tomstorey/discrete-nor-logic-clock/3-bit-ripple-counter/3 bit ripple counter.png

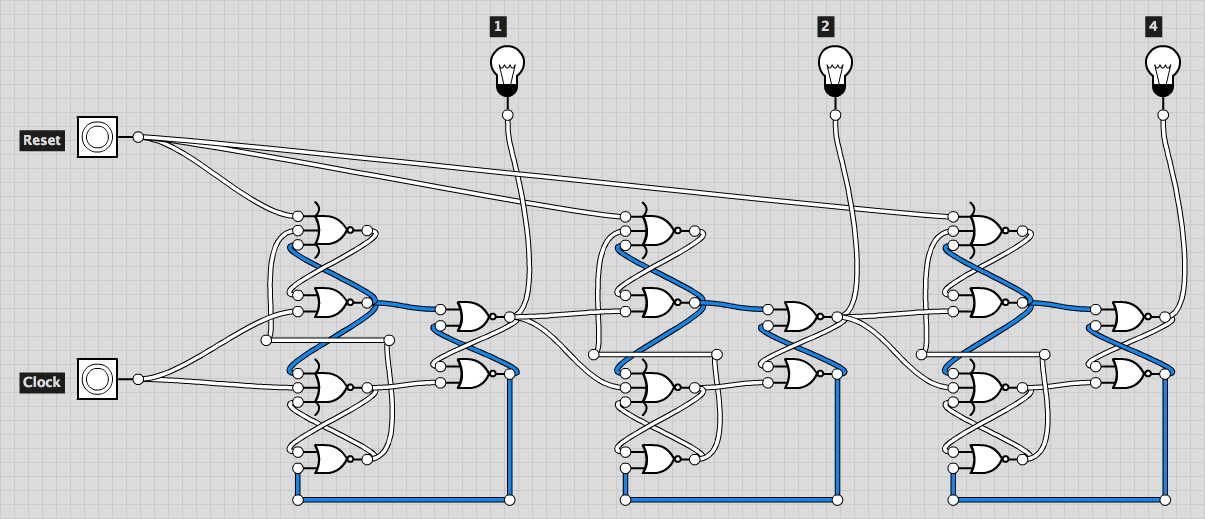
3-bit-ripple-counter/3 bit ripple counter.png
