tomstorey/discrete-nor-logic-clock/7-seg-decoders/2 bit BCD NOR 7 seg decoder Rev B.png

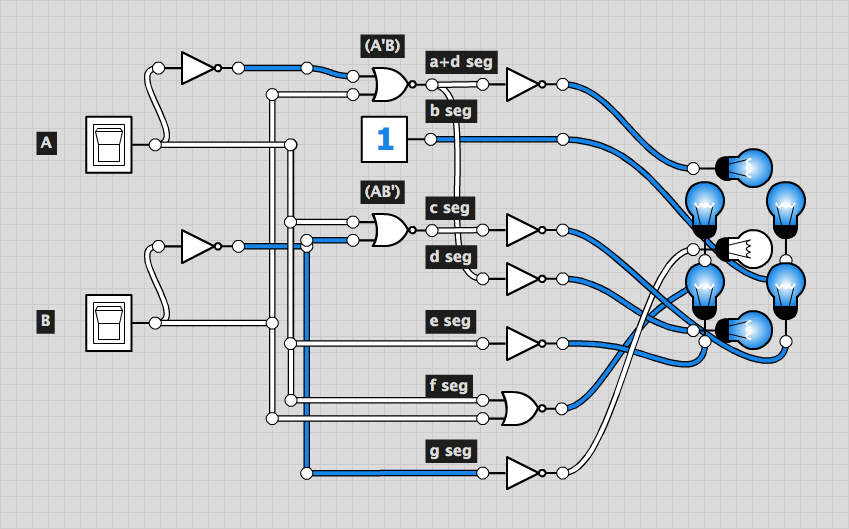
7-seg-decoders/2 bit BCD NOR 7 seg decoder Rev B.png
