tomstorey/discrete-nor-logic-clock/schematics/display-board.pdf

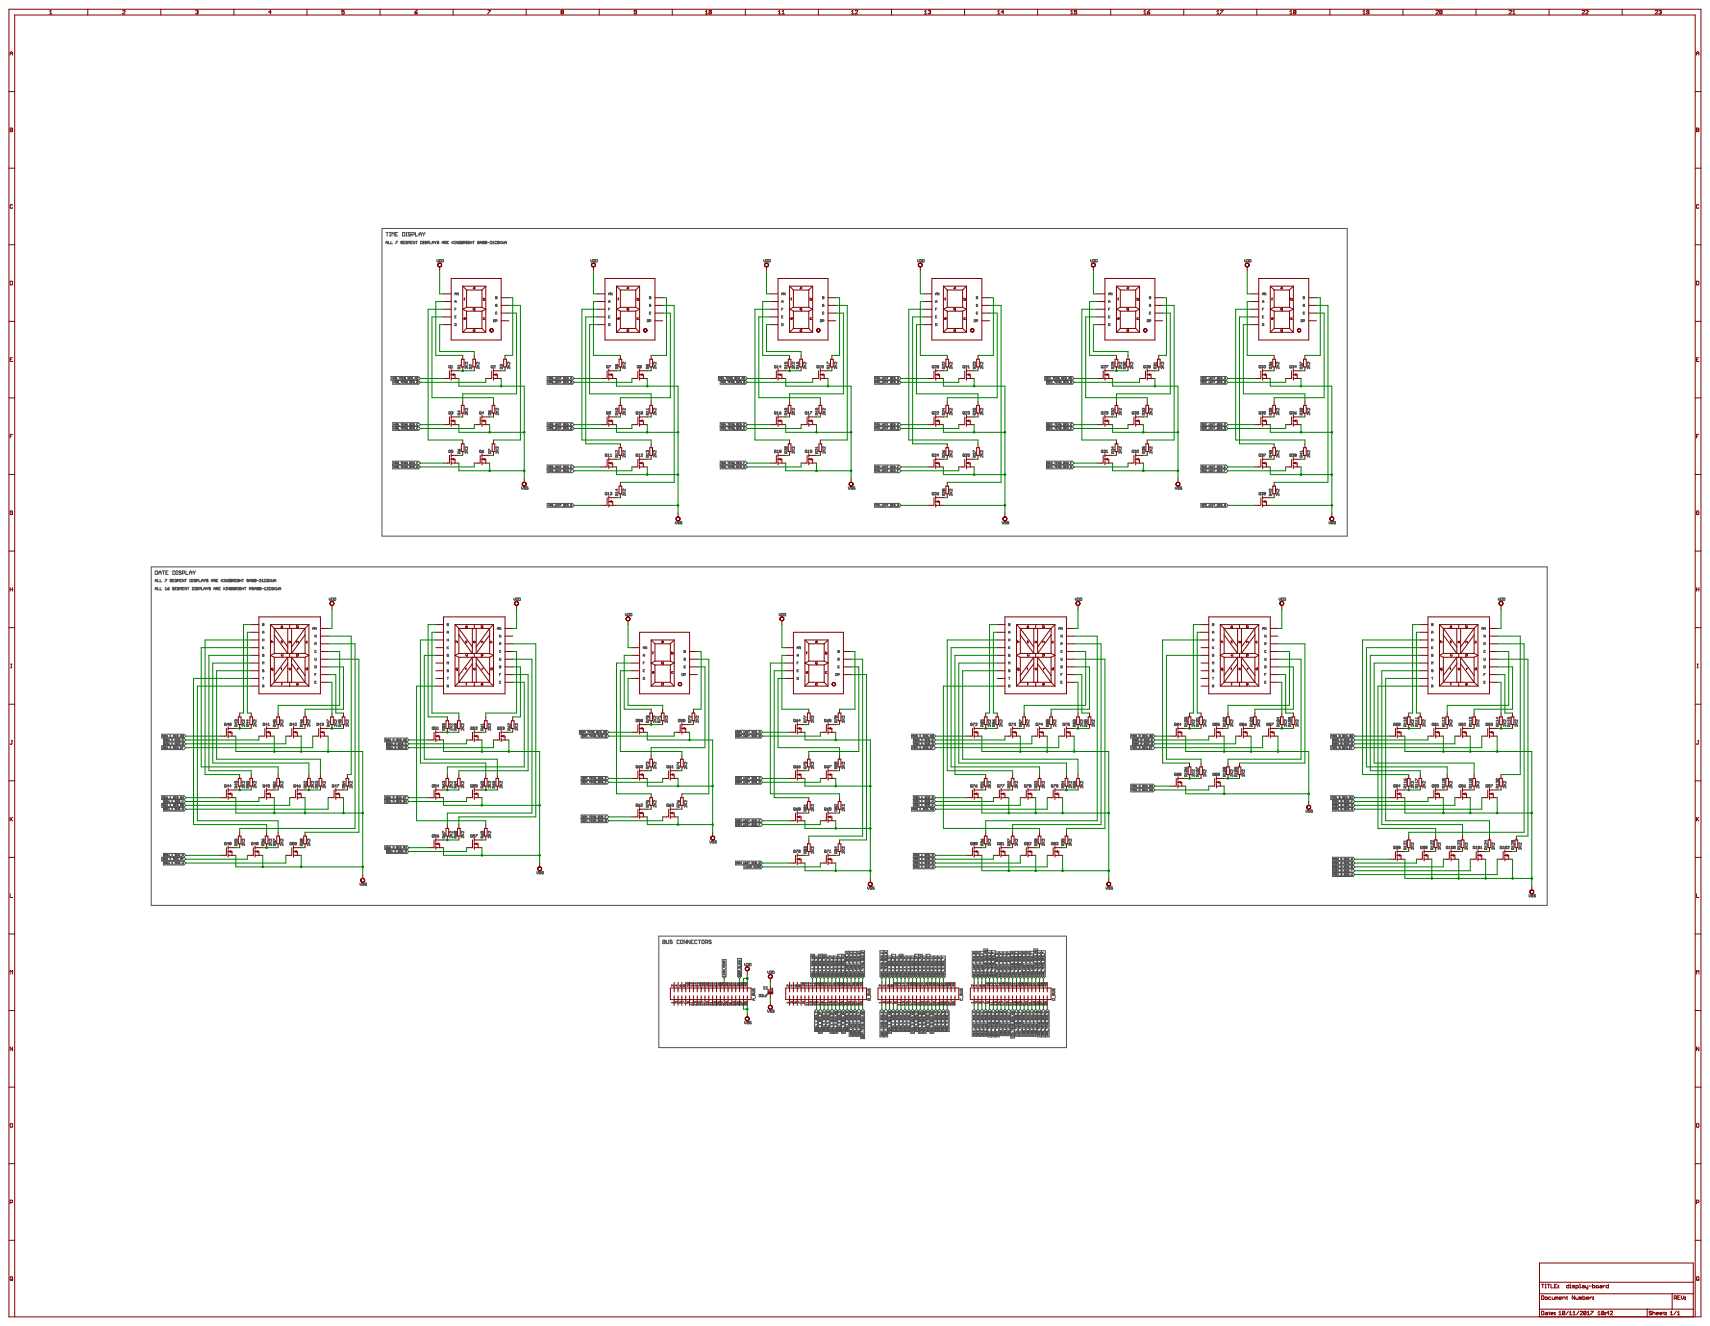
[picture p4: page 1]
