tomstorey/discrete-nor-logic-clock/schematics/calendar-module.pdf

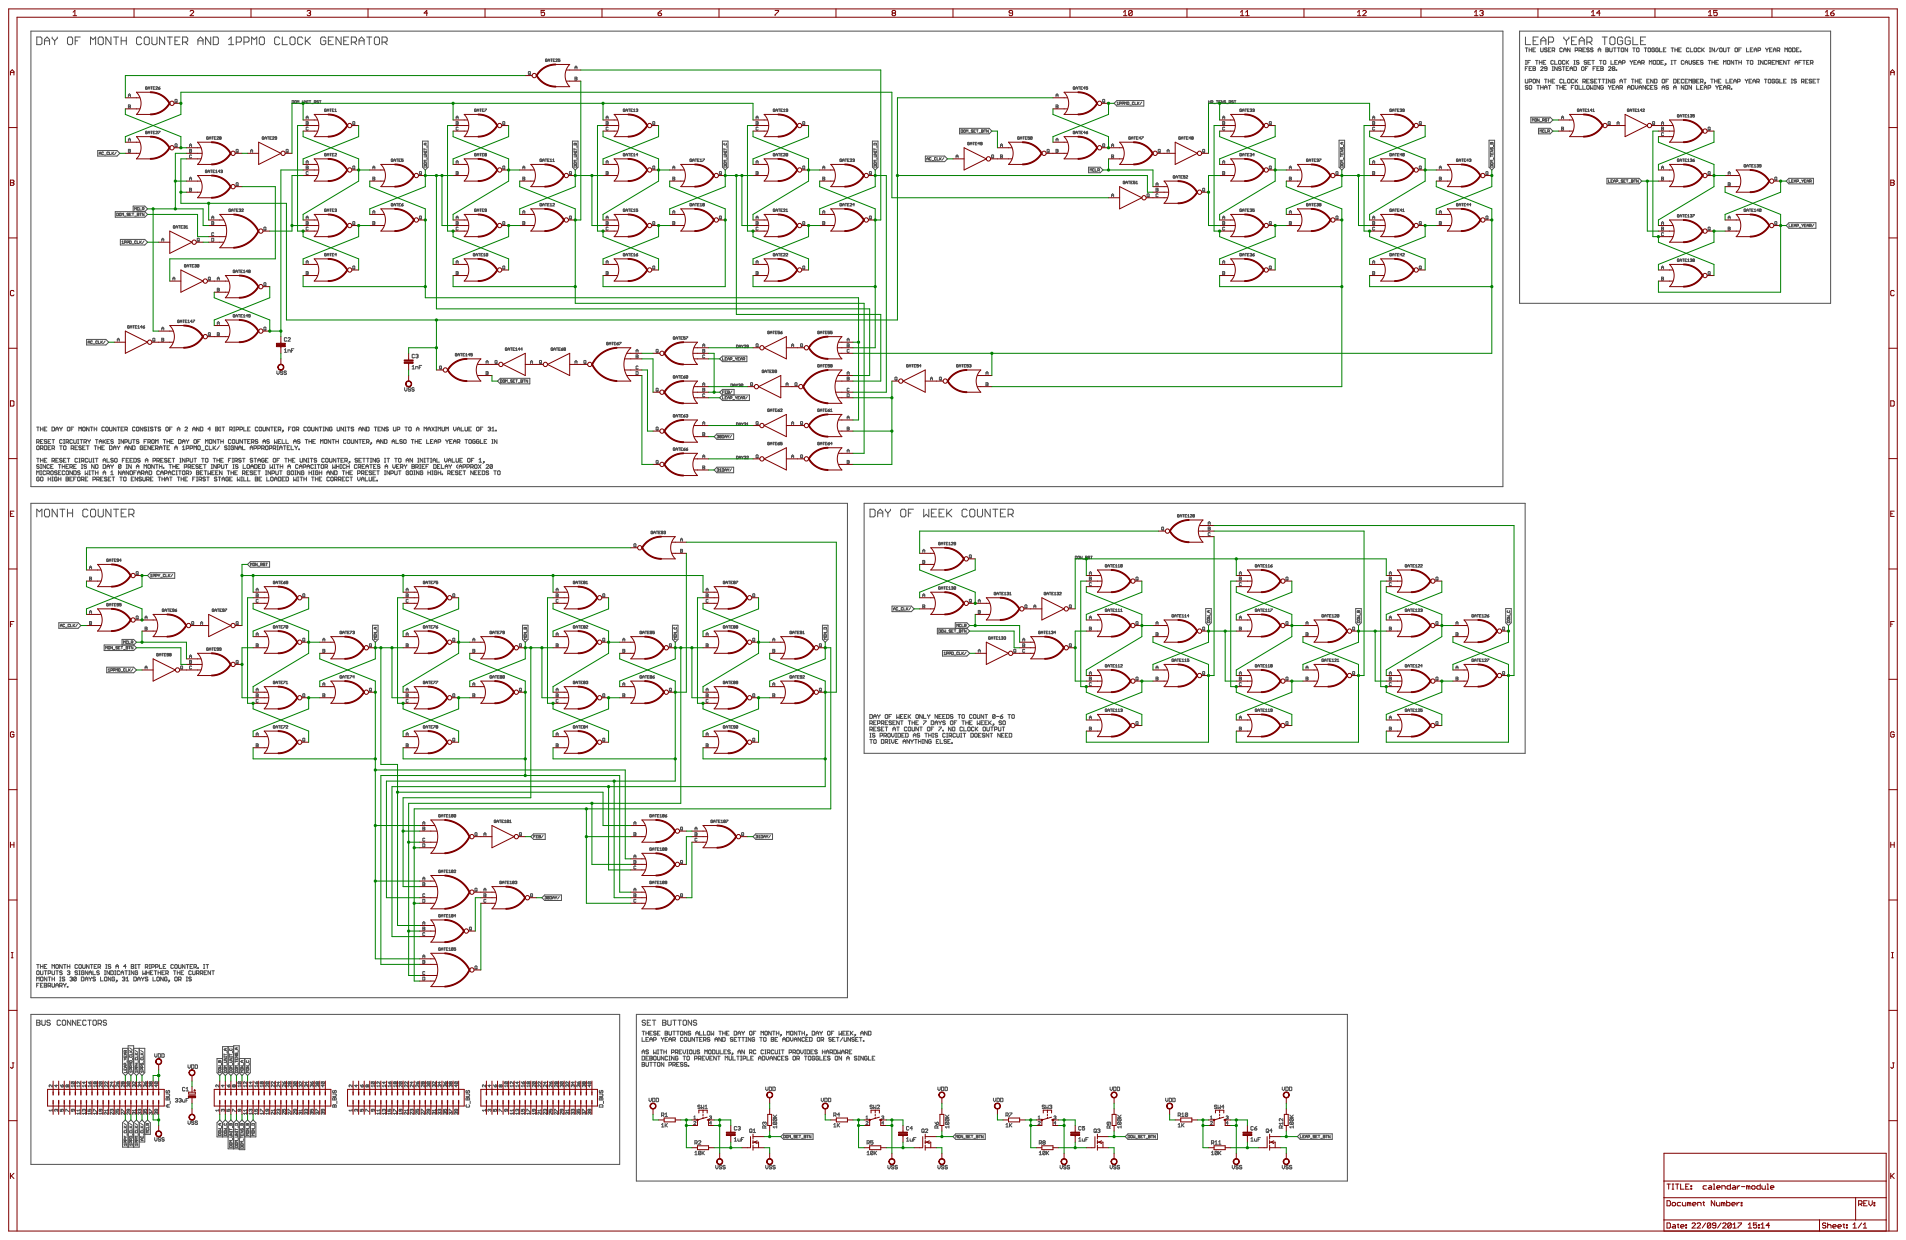
[picture p5: page 1]
