tomstorey/discrete-nor-logic-clock/schematics/calendar-decoders.pdf

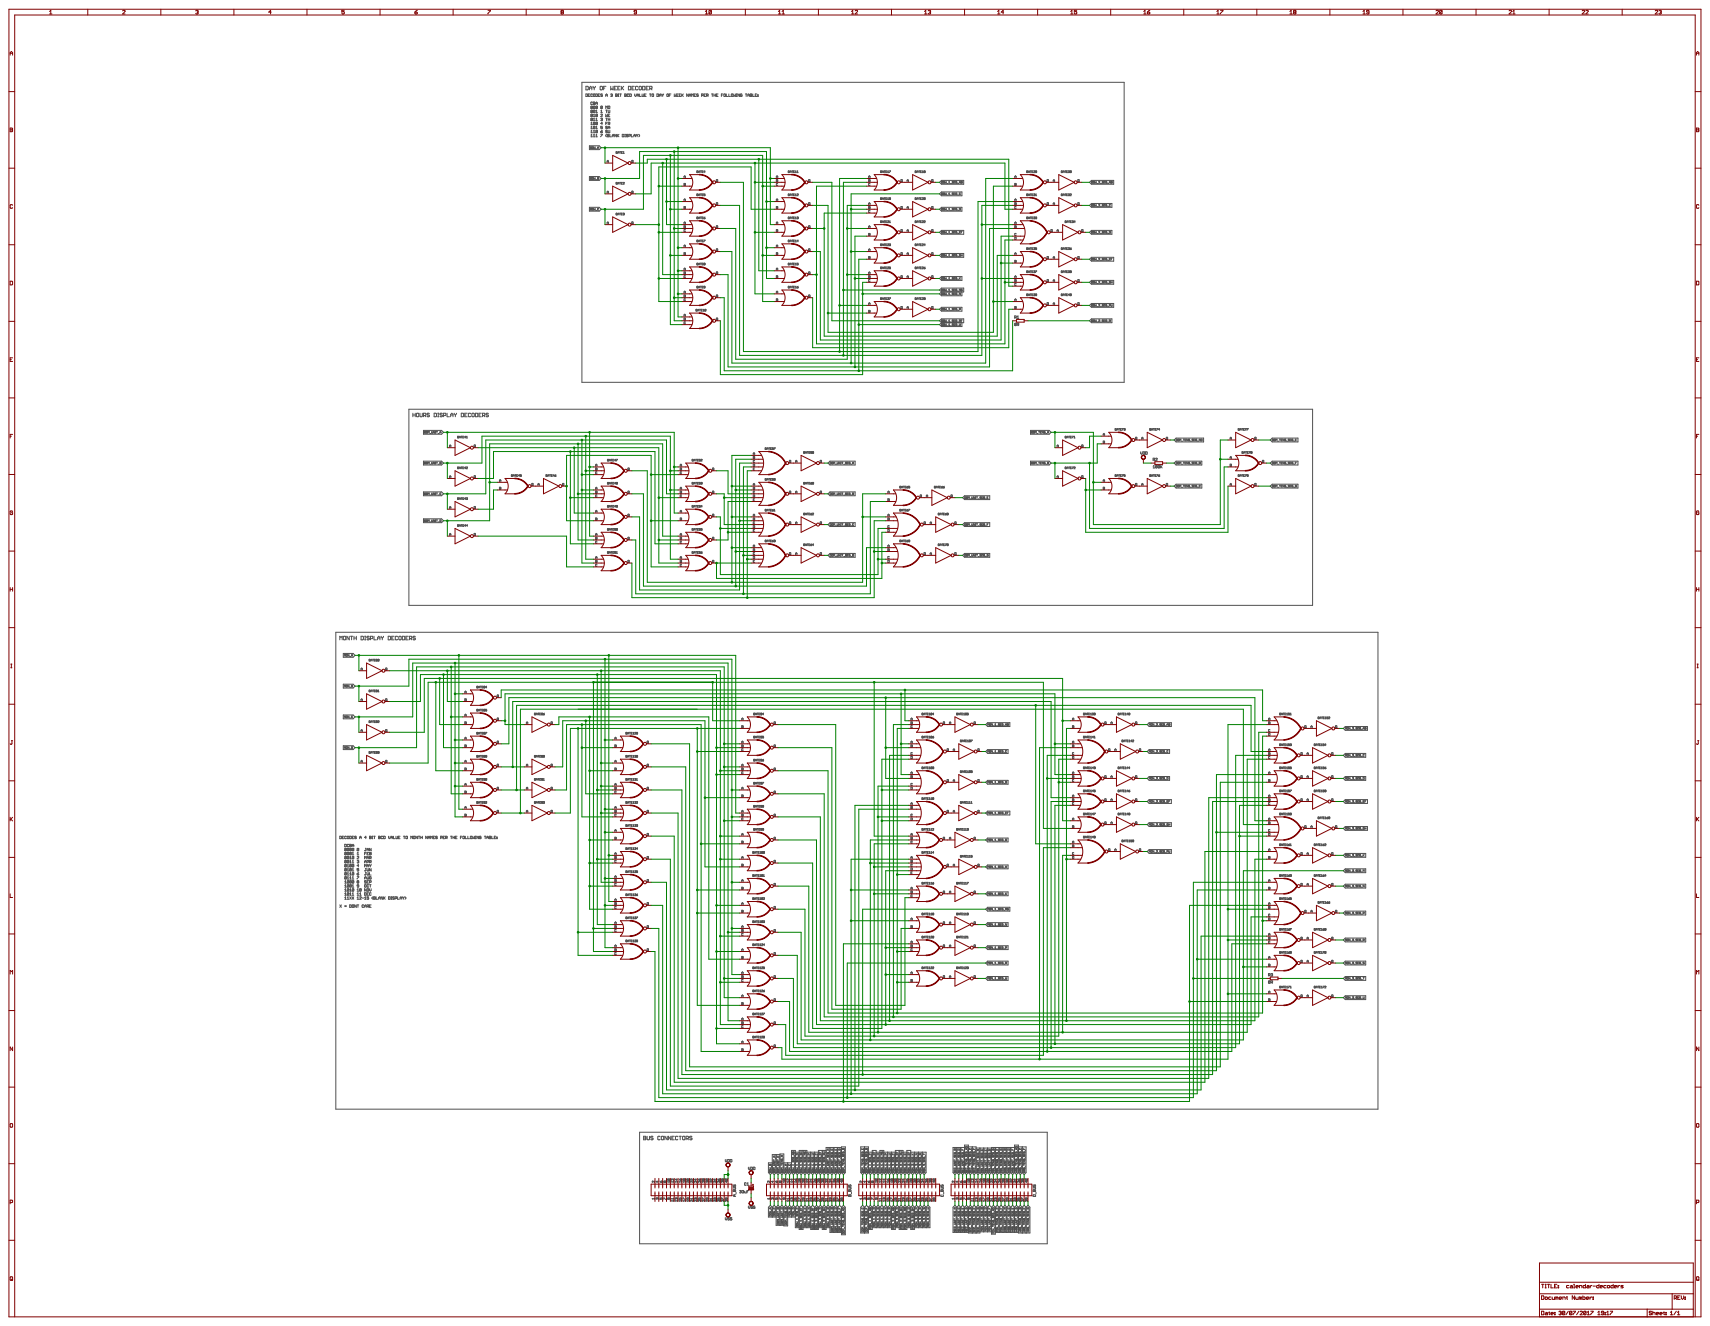
[picture p6: page 1]
