tomstorey/discrete-nor-logic-clock/schematics/analogue-board.pdf

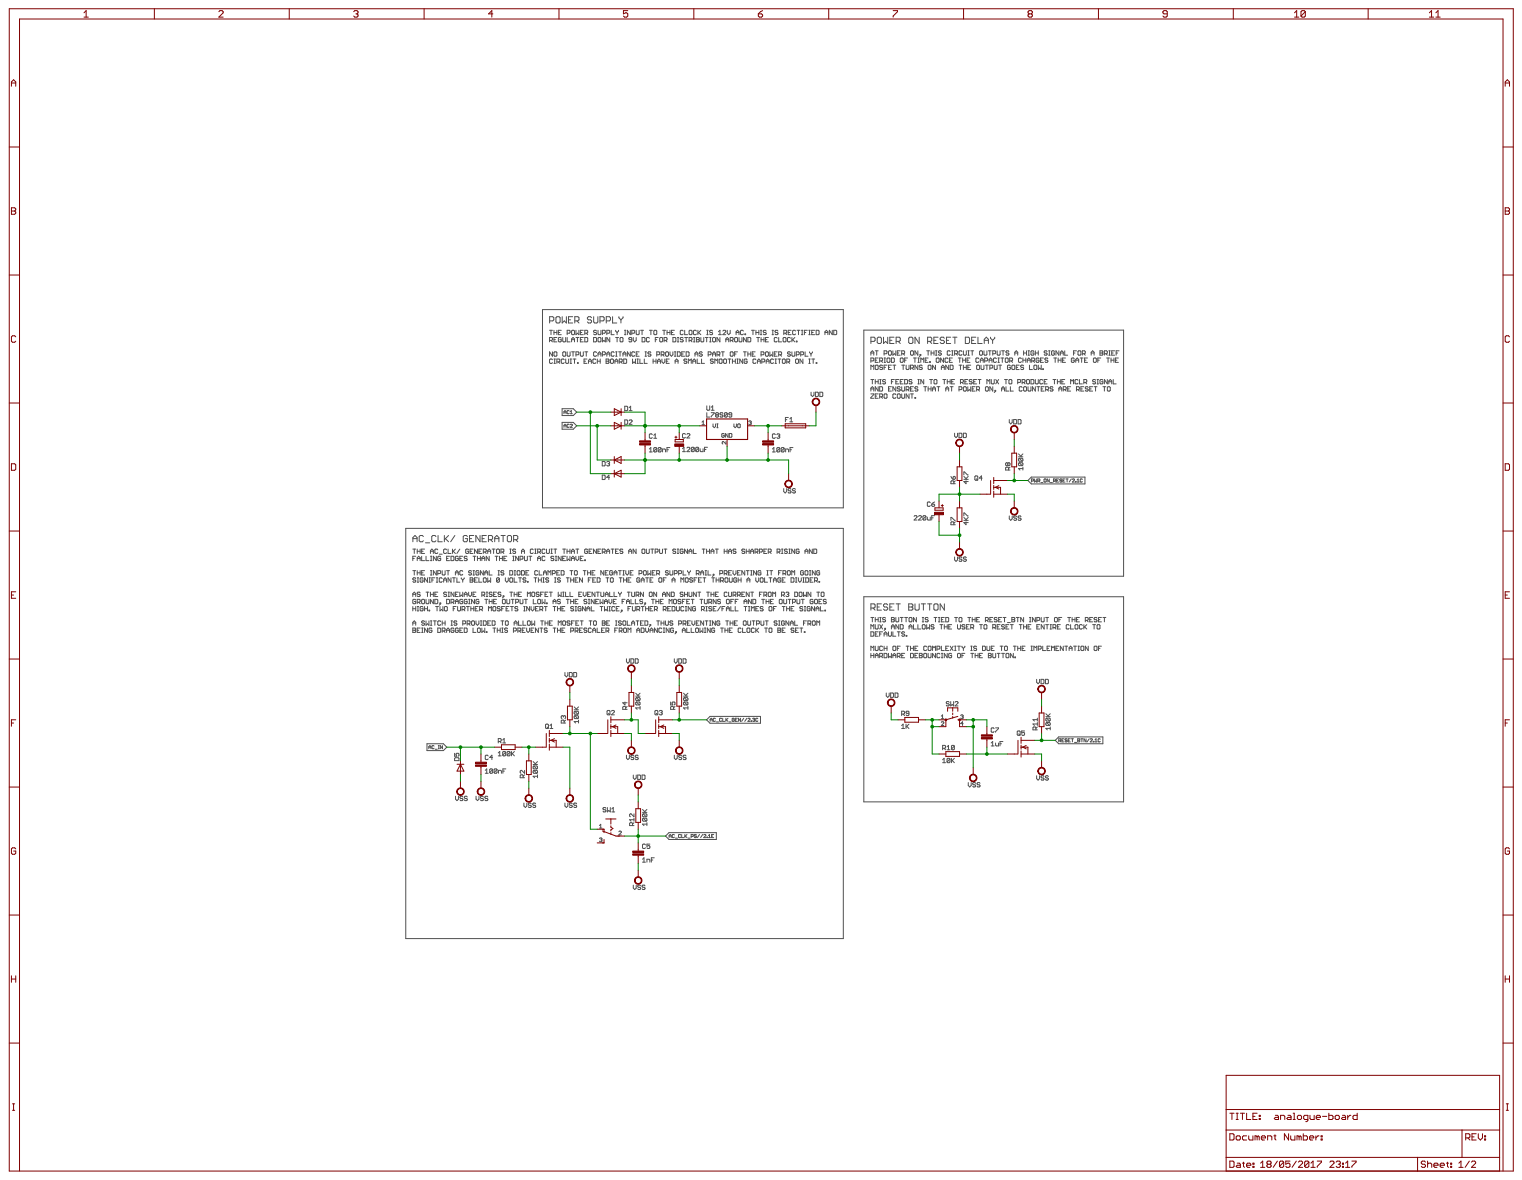
[picture p7: page 1]

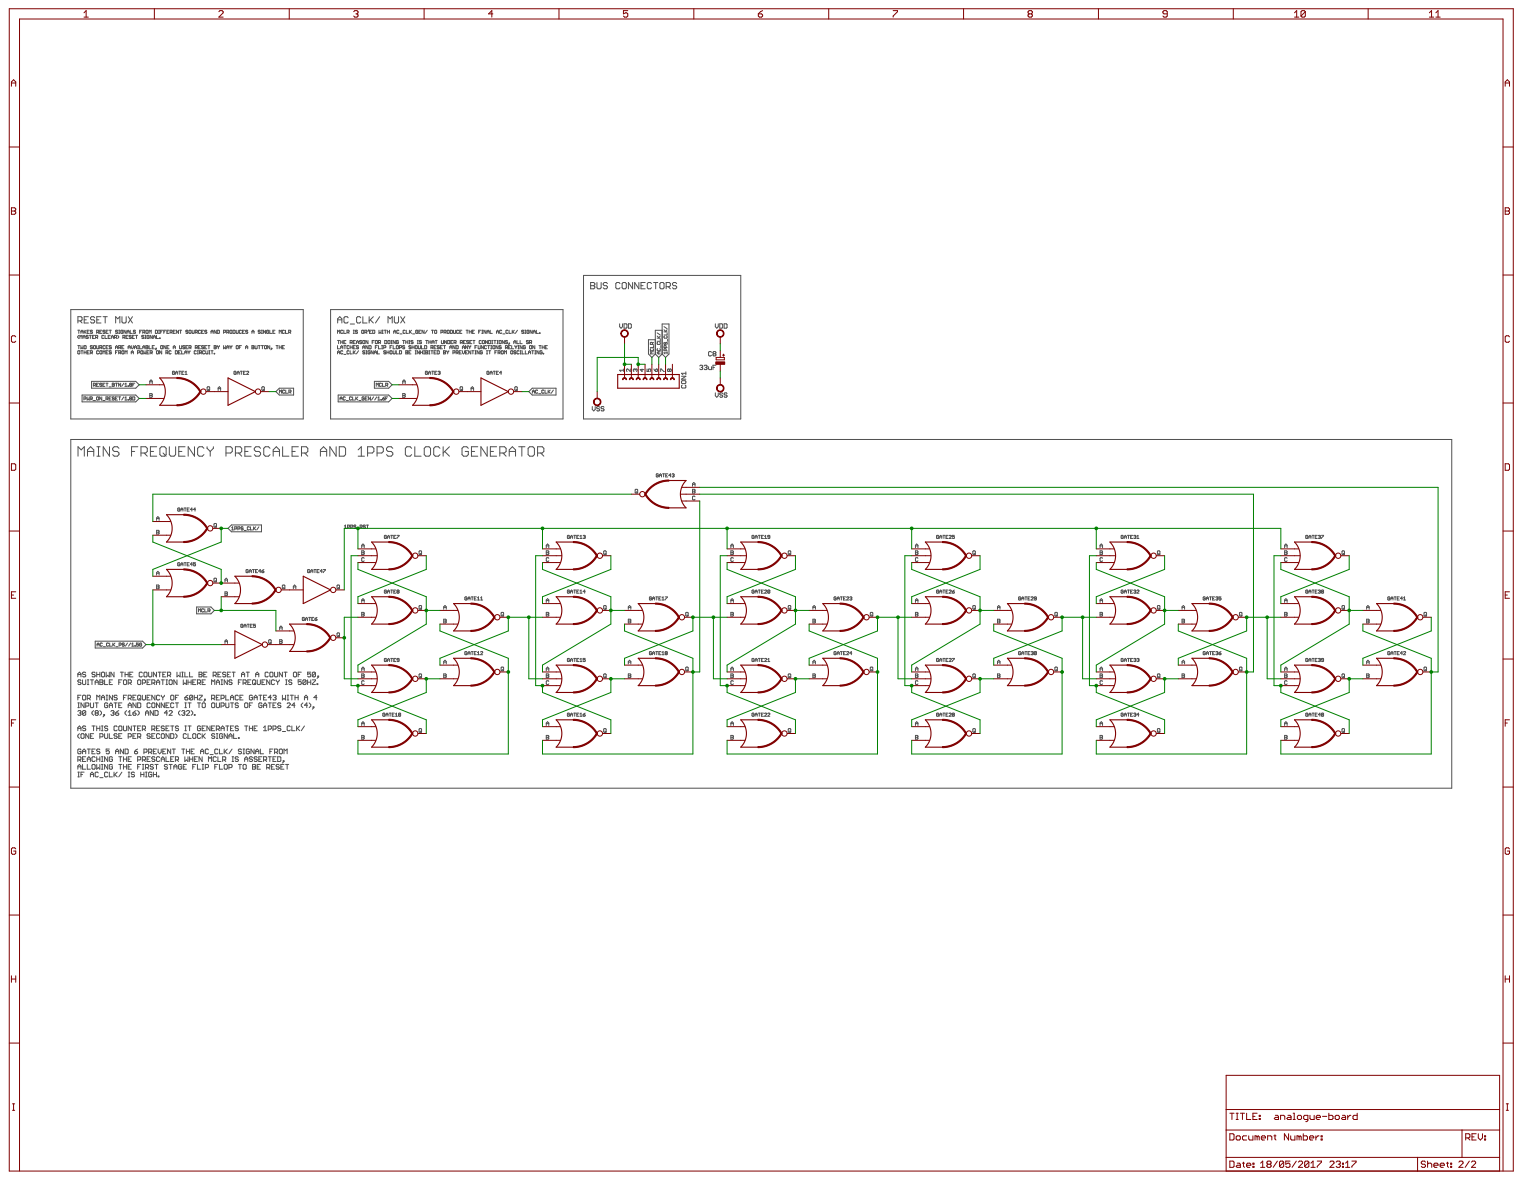
[picture p8: page 2]
