tomstorey/discrete-nor-logic-clock/schematics/time-decoders.pdf

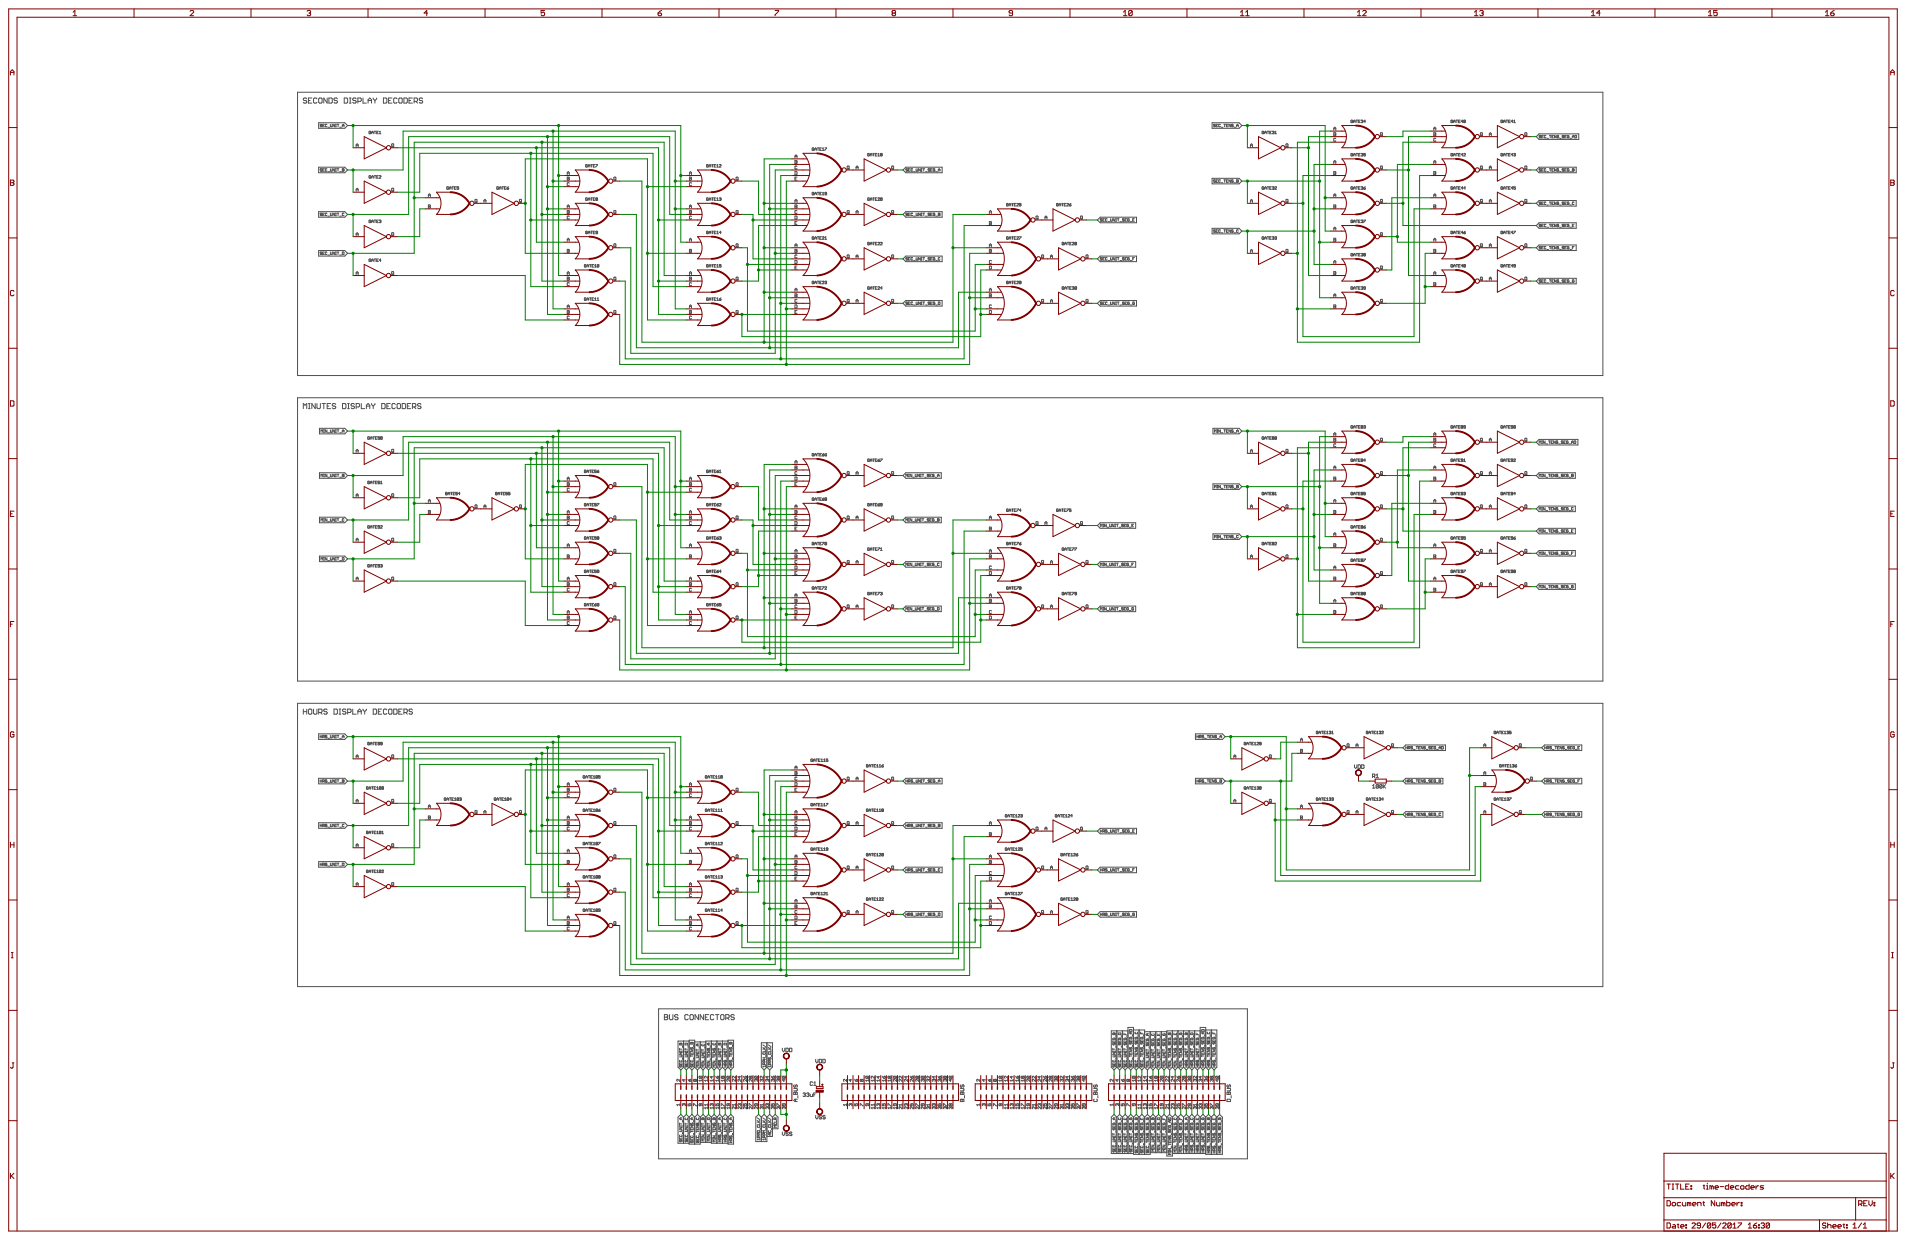
[picture p9: page 1]
