tomstorey/discrete-nor-logic-clock/schematics/time-module.pdf

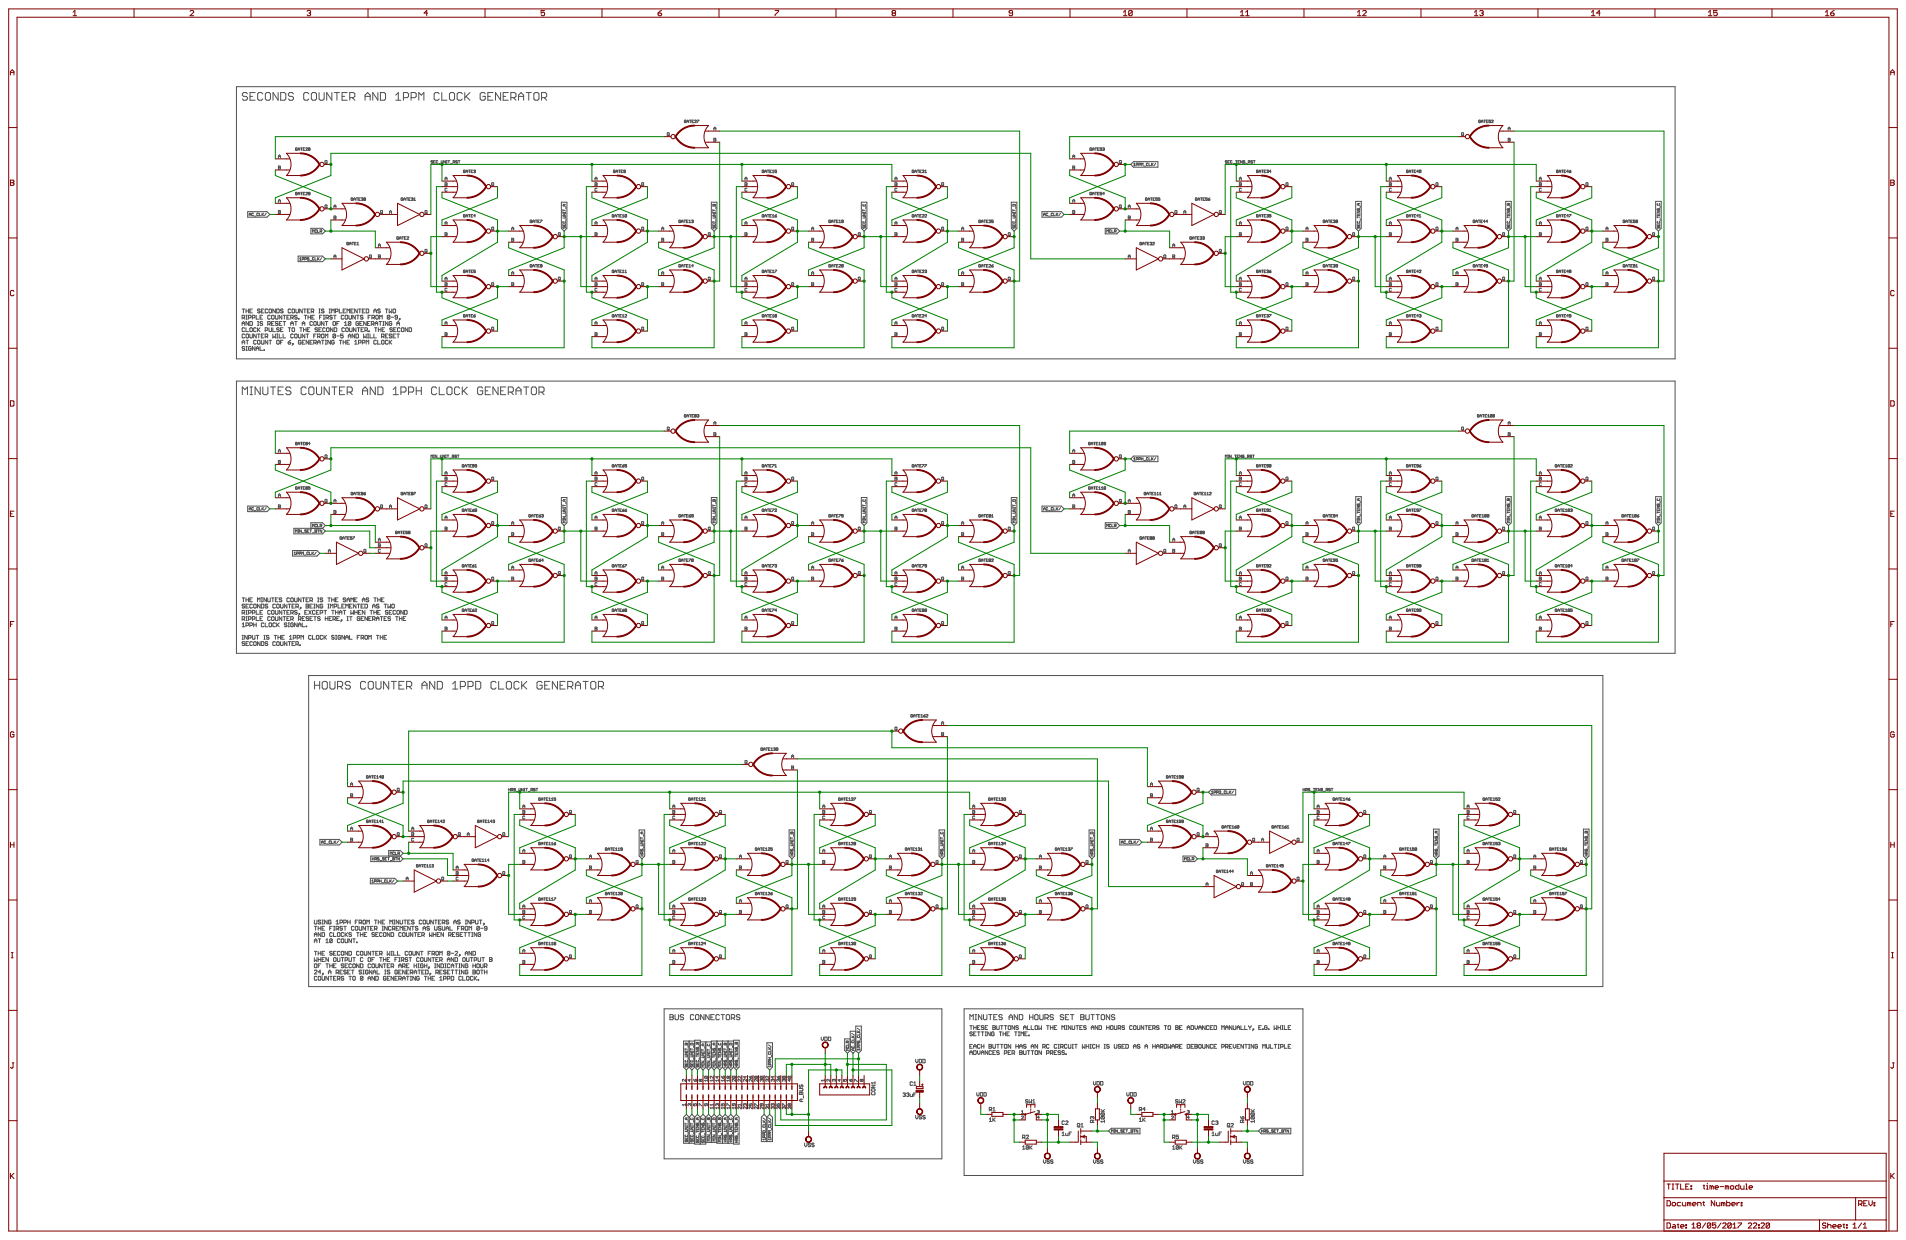
[picture p10: page 1]
