tomstorey/discrete-nor-logic-clock/schematics/analogue-board.sch

## EAGLE design schematics/analogue-board.sch (2017-05-24)

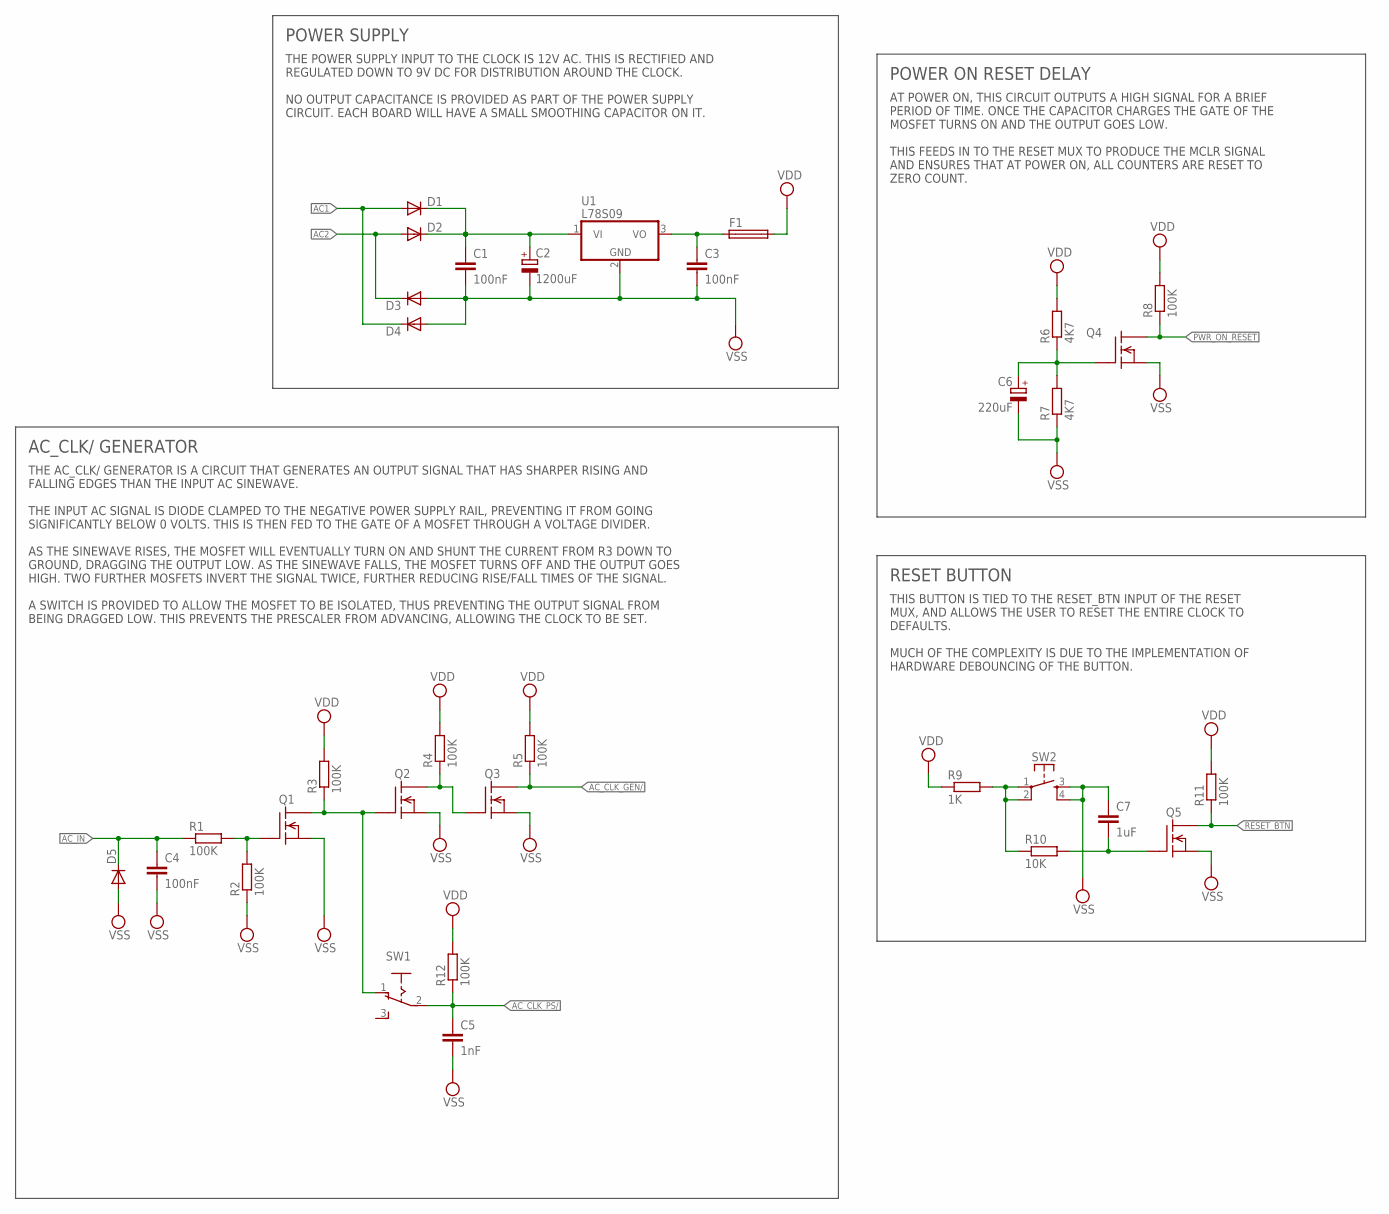
[picture p11: schematic analogue-board.sch, sheet 1]

Parts:
C1, C3, C4: 100nF; C050-024X044
C2: 1200uF; E7,5-16
C5: 1nF; C050-025X075
C6: 220uF; E2,5-6
C7: 1uF; C050-025X075
D1, D2, D3, D4, D5: 1N4004; DO41-10
F1: TE5
Q1, Q2, Q3, Q4, Q5: 2N7000; TO-92
R1, R2, R3, R4, R5, R8, R11, R12: 100K; 0207/2V
R6, R7: 4K7; 0207/2V
R9: 1K; 0207/2V
R10: 10K; 0207/2V
SW1: 255SB
SW2: SPST-TACSWITCH; TE-SMD-TACSWITCH
U1: L78S09; TO220H

Connections:
AC1: D1.A, D4.C
AC2: D2.A, D3.C
AC_CLK_GEN/: Q3.3 (D), R5.1
AC_CLK_PS/: C5.1, R12.1, SW1.2
AC_IN: C4.1, D5.C, R1.1
unnamed: Q1.3 (D), Q2.2 (G), R3.1, SW1.1 (O)
unnamed: C6.+, Q4.2 (G), R6.1, R7.2
unnamed: C3.1, F1.1, U1.3 (VO)
unnamed: C1.1, C2.+, D1.C, D2.C, U1.1 (VI)
unnamed: R9.2, R10.1, SW2.1, SW2.2
unnamed: Q2.3 (D), Q3.2 (G), R4.1
unnamed: Q1.2 (G), R1.2, R2.2
unnamed: C7.2, Q5.2 (G), R10.2
PWR_ON_RESET: Q4.3 (D), R8.1
RESET_BTN: Q5.3 (D), R11.1
VDD: F1.2, R3.2, R4.2, R5.2, R6.2, R8.2, R9.1, R11.2, R12.2
VSS: C1.2, C2.-, C3.2, C4.2, C5.2, C6.-, C7.1, D3.A, D4.A, D5.A, Q1.1 (S), Q2.1 (S), Q3.1 (S), Q4.1 (S), Q5.1 (S), R2.1, R7.1, SW2.3, SW2.4, U1.2 (GND)

Notes on the sheet:
POWER SUPPLY
THE POWER SUPPLY INPUT TO THE CLOCK IS 12V AC. THIS IS RECTIFIED AND REGULATED DOWN TO 9V DC FOR DISTRIBUTION AROUND THE CLOCK. NO OUTPUT CAPACITANCE IS PROVIDED AS PART OF THE POWER SUPPLY CIRCUIT. EACH BOARD WILL HAVE A SMALL SMOOTHING CAPACITOR ON IT.
AC_CLK/ GENERATOR
POWER ON RESET DELAY
AT POWER ON, THIS CIRCUIT OUTPUTS A HIGH SIGNAL FOR A BRIEF PERIOD OF TIME. ONCE THE CAPACITOR CHARGES THE GATE OF THE MOSFET TURNS ON AND THE OUTPUT GOES LOW. THIS FEEDS IN TO THE RESET MUX TO PRODUCE THE MCLR SIGNAL AND ENSURES THAT AT POWER ON, ALL COUNTERS ARE RESET TO ZERO COUNT.
RESET BUTTON
THIS BUTTON IS TIED TO THE RESET_BTN INPUT OF THE RESET MUX, AND ALLOWS THE USER TO RESET THE ENTIRE CLOCK TO DEFAULTS. MUCH OF THE COMPLEXITY IS DUE TO THE IMPLEMENTATION OF HARDWARE DEBOUNCING OF THE BUTTON.
THE AC_CLK/ GENERATOR IS A CIRCUIT THAT GENERATES AN OUTPUT SIGNAL THAT HAS SHARPER RISING AND FALLING EDGES THAN THE INPUT AC SINEWAVE. THE INPUT AC SIGNAL IS DIODE CLAMPED TO THE NEGATIVE POWER SUPPLY RAIL, PREVENTING IT FROM GOING SIGNIFICANTLY BELOW 0 VOLTS. THIS IS THEN FED TO THE GATE OF A MO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

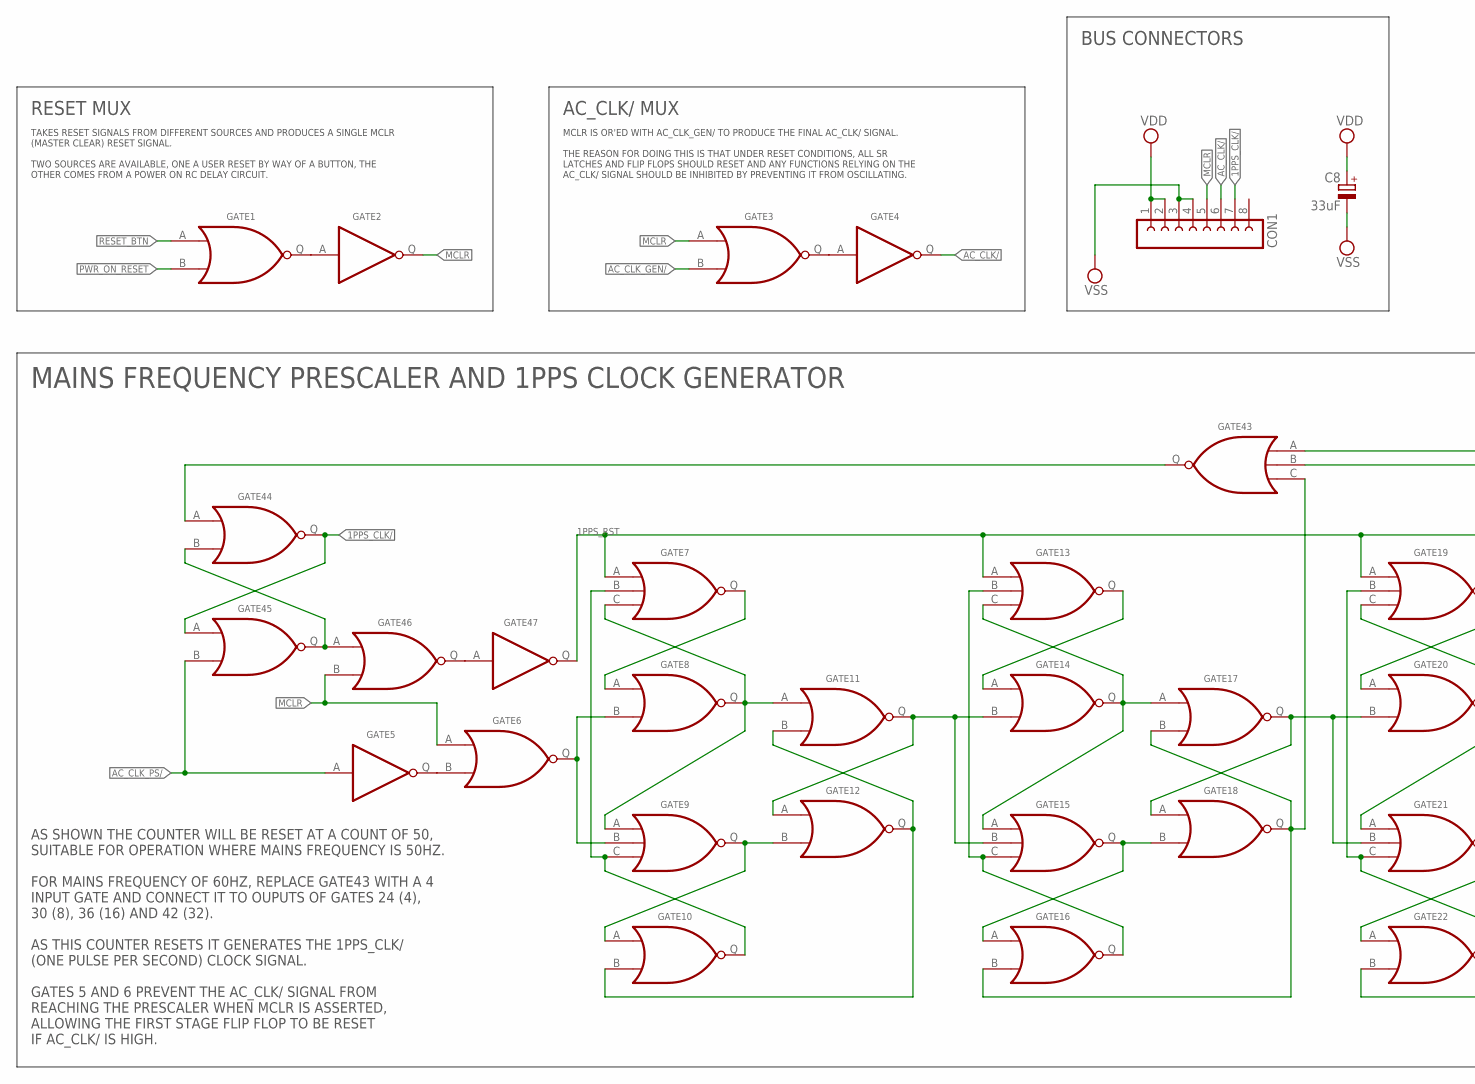
[picture p12: schematic analogue-board.sch, sheet 2, part in row 1, column 1]

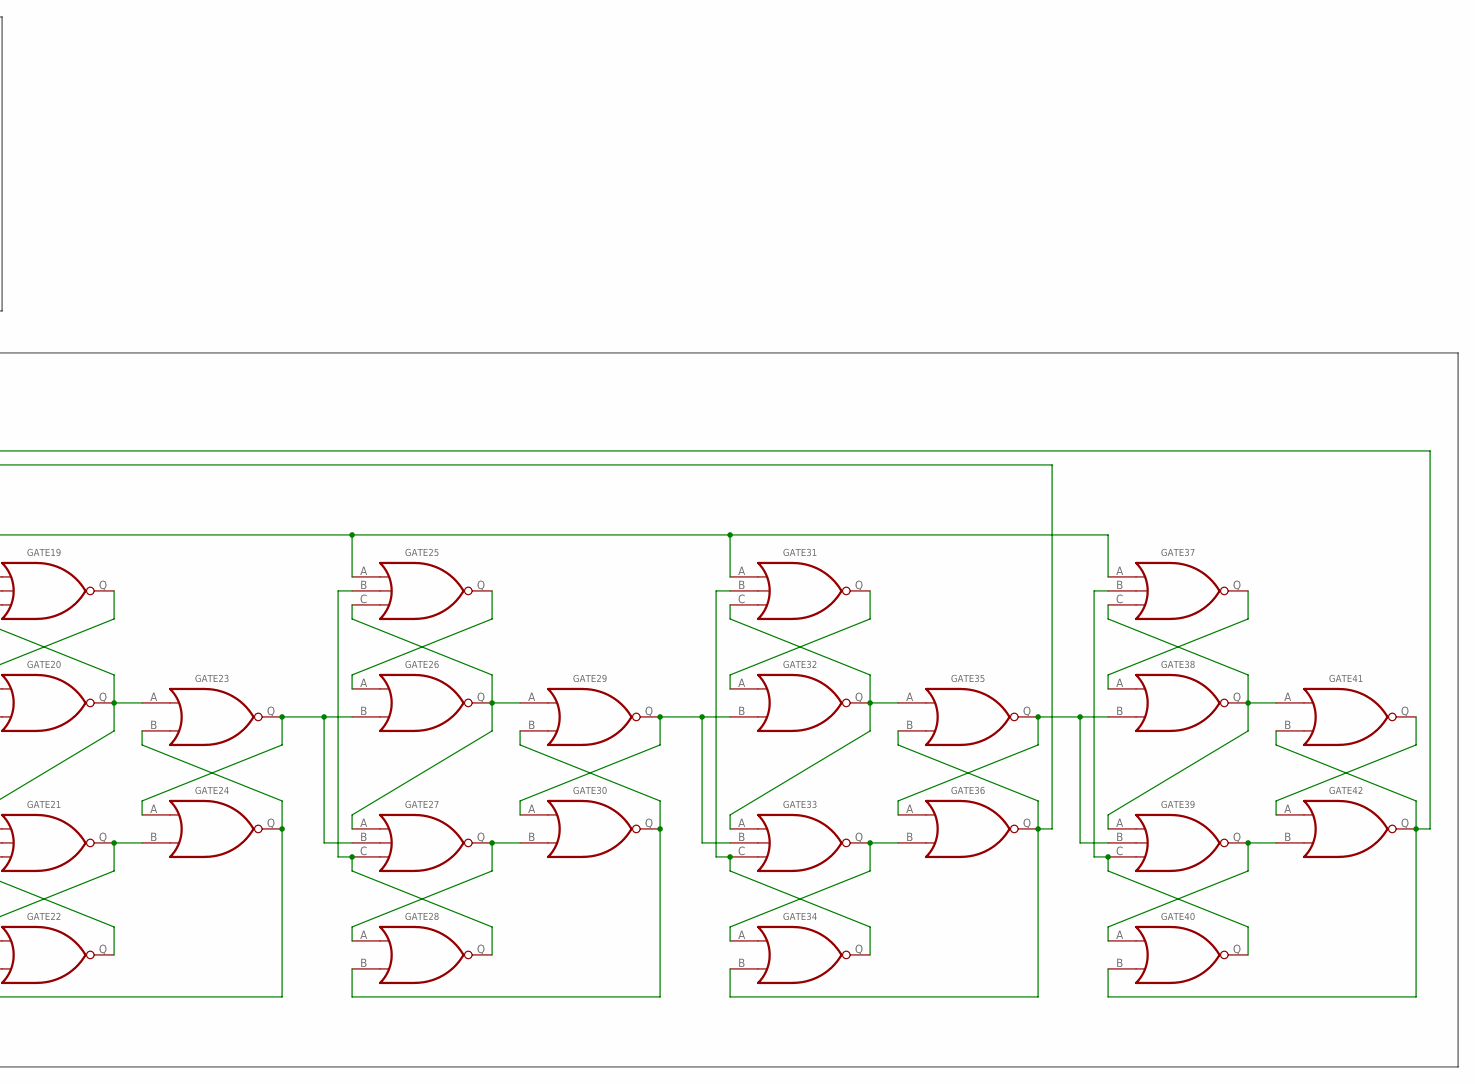
[picture p13: schematic analogue-board.sch, sheet 2, part in row 1, column 2]

Parts:
C8: 33uF; E2,5-6
CON1: FE08-1; FE08
GATE1, GATE3, GATE6, GATE8, GATE10, GATE11, GATE12, GATE14, GATE16, GATE17, GATE18, GATE20, GATE22, GATE23, GATE24, GATE26, GATE28, GATE29, GATE30, GATE32, GATE34, GATE35, GATE36, GATE38, GATE40, GATE41, GATE42, GATE44, GATE45, GATE46: 2NOR
GATE2, GATE4, GATE5, GATE47: INVERTER
GATE7, GATE9, GATE13, GATE15, GATE19, GATE21, GATE25, GATE27, GATE31, GATE33, GATE37, GATE39, GATE43: 3NOR

Connections:
1PPS_CLK/: CON1.7, GATE44.Q, GATE45.A
1PPS_RST: GATE7.A, GATE13.A, GATE19.A, GATE25.A, GATE31.A, GATE37.A, GATE47.Q
AC_CLK/: CON1.6, GATE4.Q
AC_CLK_GEN/: GATE3.B
AC_CLK_PS/: GATE5.A, GATE45.B
MCLR: CON1.5, GATE2.Q, GATE3.A, GATE6.A, GATE46.B
unnamed: GATE1.Q, GATE2.A
unnamed: GATE44.B, GATE45.Q, GATE46.A
unnamed: GATE3.Q, GATE4.A
unnamed: GATE6.Q, GATE8.B, GATE9.B
unnamed: GATE5.Q, GATE6.B
unnamed: GATE46.Q, GATE47.A
unnamed: GATE35.Q, GATE36.A, GATE38.B, GATE39.B
unnamed: GATE7.C, GATE8.Q, GATE9.A, GATE11.A
unnamed: GATE7.Q, GATE8.A
unnamed: GATE7.B, GATE9.C, GATE10.Q
unnamed: GATE9.Q, GATE10.A, GATE12.B
unnamed: GATE10.B, GATE11.B, GATE12.Q
unnamed: GATE11.Q, GATE12.A, GATE14.B, GATE15.B
unnamed: GATE13.C, GATE14.Q, GATE15.A, GATE17.A
unnamed: GATE13.Q, GATE14.A
unnamed: GATE13.B, GATE15.C, GATE16.Q
unnamed: GATE15.Q, GATE16.A, GATE18.B
unnamed: GATE16.B, GATE17.B, GATE18.Q, GATE43.C
unnamed: GATE17.Q, GATE18.A, GATE20.B, GATE21.B
unnamed: GATE19.C, GATE20.Q, GATE21.A, GATE23.A
unnamed: GATE19.Q, GATE20.A
unnamed: GATE19.B, GATE21.C, GATE22.Q
unnamed: GATE21.Q, GATE22.A, GATE24.B
unnamed: GATE22.B, GATE23.B, GATE24.Q
unnamed: GATE23.Q, GATE24.A, GATE26.B, GATE27.B
unnamed: GATE25.C, GATE26.Q, GATE27.A, GATE29.A
unnamed: GATE25.Q, GATE26.A
unnamed: GATE25.B, GATE27.C, GATE28.Q
unnamed: GATE27.Q, GATE28.A, GATE30.B
unnamed: GATE28.B, GATE29.B, GATE30.Q
unnamed: GATE41.Q, GATE42.A
unnamed: GATE31.C, GATE32.Q, GATE33.A, GATE35.A
unnamed: GATE31.Q, GATE32.A
unnamed: GATE31.B, GATE33.C, GATE34.Q
unnamed: GATE33.Q, GATE34.A, GATE36.B
unnamed: GATE34.B, GATE35.B, GATE36.Q, GATE43.B
unnamed: GATE43.Q, GATE44.A
unnamed: GATE37.C, GATE38.Q, GATE39.A, GATE41.A
unnamed: GATE37.Q, GATE38.A
unnamed: GATE37.B, GATE39.C, GATE40.Q
unnamed: GATE39.Q, GATE40.A, GATE42.B
unnamed: GATE40.B, GATE41.B, GATE42.Q, GATE43.A
unnamed: GATE29.Q, GATE30.A, GATE32.B, GATE33.B
PWR_ON_RESET: GATE1.B
RESET_BTN: GATE1.A
VDD: C8.+, CON1.1, CON1.2
VSS: C8.-, CON1.3, CON1.4

Notes on the sheet:
RESET MUX
TAKES RESET SIGNALS FROM DIFFERENT SOURCES AND PRODUCES A SINGLE MCLR (MASTER CLEAR) RESET SIGNAL. TWO SOURCES ARE AVAILABLE, ONE A USER RESET BY WAY OF A BUTTON, THE OTHER COMES FROM A POWER ON RC DELAY CIRCUIT.
MAINS FREQUENCY PRESCALER AND 1PPS CLOCK GENERATOR
AS SHOWN THE COUNTER WILL BE RESET AT A COUNT OF 50, SUITABLE FOR OPERATION WHERE MAINS FREQUENCY IS 50HZ. FOR MAINS FREQUENCY OF 60HZ, REPLACE GATE43 WITH A 4 INPUT GATE AND CONNECT IT TO OUPUTS OF GATES 24 (4), 30 (8), 36 (16) AND 42 (32). AS THIS COUNTER RESETS IT GENERATES THE 1PPS_CLK/ (ONE PU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
BUS CONNECTORS
AC_CLK/ MUX
MCLR IS OR'ED WITH AC_CLK_GEN/ TO PRODUCE THE FINAL AC_CLK/ SIGNAL. THE REASON FOR DOING THIS IS THAT UNDER RESET CONDITIONS, ALL SR LATCHES AND FLIP FLOPS SHOULD RESET AND ANY FUNCTIONS RELYING ON THE AC_CLK/ SIGNAL SHOULD BE INHIBITED BY PREVENTING IT FROM OSCILLATING.
