tomstorey/discrete-nor-logic-clock/schematics/calendar-decoders.sch

## EAGLE design schematics/calendar-decoders.sch (2017-08-16)

Schematic: calendar-decoders.sch

Parts:
A_BUS: MA20-2
B_BUS: MA20-2
C1: 33uF; E2,5-6
C_BUS: MA20-2
D_BUS: MA20-2
GATE1, GATE2, GATE3, GATE18, GATE20, GATE22, GATE24, GATE26, GATE28, GATE30, GATE32, GATE34, GATE36, GATE38, GATE40, GATE41, GATE42, GATE43, GATE44, GATE46, GATE58, GATE60, GATE62, GATE64, GATE66, GATE68, GATE70, GATE71, GATE72, GATE74, GATE76, GATE77, GATE79, GATE80, GATE81, GATE82, GATE83, GATE86, GATE89, GATE91, GATE93, GATE105, GATE107, GATE109, GATE111, GATE113, GATE115, GATE117, GATE119, GATE121, GATE123, GATE140, GATE142, GATE144, GATE146, GATE148, GATE150, GATE152, GATE154, GATE156, GATE158, GATE160, GATE162, GATE164, GATE166, GATE168, GATE170, GATE172: INVERTER
GATE4, GATE5, GATE7, GATE12, GATE13, GATE14, GATE15, GATE16, GATE21, GATE23, GATE27, GATE29, GATE35, GATE39, GATE45, GATE49, GATE54, GATE65, GATE73, GATE75, GATE78, GATE84, GATE85, GATE87, GATE88, GATE90, GATE92, GATE94, GATE97, GATE99, GATE100, GATE101, GATE102, GATE118, GATE122, GATE124, GATE126, GATE128, GATE129, GATE130, GATE133, GATE139, GATE147, GATE155, GATE161, GATE163, GATE169, GATE171: 2NOR
GATE6, GATE8, GATE9, GATE10, GATE11, GATE17, GATE19, GATE25, GATE31, GATE37, GATE47, GATE48, GATE50, GATE51, GATE52, GATE53, GATE55, GATE56, GATE95, GATE96, GATE98, GATE103, GATE104, GATE112, GATE116, GATE120, GATE125, GATE127, GATE131, GATE132, GATE134, GATE135, GATE136, GATE137, GATE138, GATE143, GATE145, GATE153, GATE157, GATE167: 3NOR
GATE33, GATE67, GATE69, GATE106, GATE108, GATE110, GATE141, GATE149, GATE151, GATE159, GATE165: 4NOR
GATE57, GATE59, GATE61, GATE63, GATE114: 5NOR
R1, R3: 0R; 0207/2V
R2: 100K; 0207/2V

Connections:
DOM_TENS_A: B_BUS.8, GATE71.A, GATE75.A, GATE77.A, GATE78.A
DOM_TENS_B: B_BUS.9, GATE72.A, GATE73.B, GATE78.B
DOM_TENS_SEG_AD: B_BUS.39, GATE74.Q
DOM_TENS_SEG_B: B_BUS.40, R2.2
DOM_TENS_SEG_C: C_BUS.1, GATE76.Q
DOM_TENS_SEG_E: C_BUS.2, GATE77.Q
DOM_TENS_SEG_F: C_BUS.3, GATE78.Q
DOM_TENS_SEG_G: C_BUS.4, GATE79.Q
DOM_UNIT_A: B_BUS.4, GATE41.A, GATE47.A, GATE50.A, GATE52.A, GATE54.A
DOM_UNIT_B: B_BUS.5, GATE42.A, GATE47.B, GATE51.A, GATE52.B, GATE53.A, GATE56.A
DOM_UNIT_C: B_BUS.6, GATE43.A, GATE47.C, GATE48.A, GATE51.B, GATE53.B
DOM_UNIT_D: B_BUS.7, GATE44.A, GATE45.A, GATE48.B, GATE50.B, GATE55.A
DOM_UNIT_SEG_A: B_BUS.32, GATE58.Q
DOM_UNIT_SEG_B: B_BUS.33, GATE60.Q
DOM_UNIT_SEG_C: B_BUS.34, GATE62.Q
DOM_UNIT_SEG_D: B_BUS.35, GATE64.Q
DOM_UNIT_SEG_E: B_BUS.36, GATE66.Q
DOM_UNIT_SEG_F: B_BUS.37, GATE68.Q
DOM_UNIT_SEG_G: B_BUS.38, GATE70.Q
DOW_1_SEG_AB: B_BUS.14, GATE18.Q
DOW_1_SEG_C: B_BUS.15, GATE7.Q, GATE19.B, GATE23.A, GATE29.A
DOW_1_SEG_D: B_BUS.16, GATE20.Q
DOW_1_SEG_EF: B_BUS.17, GATE22.Q
DOW_1_SEG_GH: B_BUS.18, GATE24.Q
DOW_1_SEG_K: B_BUS.19, GATE26.Q
DOW_1_SEG_MS: B_BUS.20, GATE5.Q, GATE17.B, GATE31.B, GATE33.A, GATE37.A
DOW_1_SEG_N: B_BUS.21, GATE10.Q, GATE25.C
DOW_1_SEG_P: B_BUS.22, GATE28.Q
DOW_1_SEG_RT: B_BUS.23, GATE11.Q
DOW_1_SEG_U: B_BUS.24, GATE9.Q, GATE23.B, R1.1
DOW_2_SEG_AB: B_BUS.25, GATE30.Q
DOW_2_SEG_C: B_BUS.26, GATE32.Q
DOW_2_SEG_D: B_BUS.27, GATE34.Q
DOW_2_SEG_EF: B_BUS.28, GATE36.Q
DOW_2_SEG_GH: B_BUS.29, GATE38.Q
DOW_2_SEG_PU: B_BUS.30, GATE40.Q
DOW_2_SEG_R: B_BUS.31, R1.2
DOW_A: B_BUS.1, GATE1.A, GATE4.A, GATE7.A, GATE8.A, GATE9.A, GATE10.A, GATE11.A, GATE13.A
DOW_B: B_BUS.2, GATE2.A, GATE6.B, GATE9.B, GATE10.B, GATE12.A, GATE14.A, GATE15.B
DOW_C: B_BUS.3, GATE3.A, GATE5.B, GATE7.B, GATE10.C, GATE11.C, GATE14.B, GATE16.B
HRS_TENS_SEG_AD: D_BUS.34
HRS_TENS_SEG_B: D_BUS.35
HRS_TENS_SEG_C: D_BUS.36
HRS_TENS_SEG_E: D_BUS.37
HRS_TENS_SEG_F: D_BUS.38
HRS_TENS_SEG_G: D_BUS.39
HRS_UNIT_SEG_A: D_BUS.27
HRS_UNIT_SEG_B: D_BUS.28
HRS_UNIT_SEG_C: D_BUS.29
HRS_UNIT_SEG_D: D_BUS.30
HRS_UNIT_SEG_E: D_BUS.31
HRS_UNIT_SEG_F: D_BUS.32
HRS_UNIT_SEG_G: D_BUS.33
MIN_TENS_SEG_AD: D_BUS.21
MIN_TENS_SEG_B: D_BUS.22
MIN_TENS_SEG_C: D_BUS.23
MIN_TENS_SEG_E: D_BUS.24
MIN_TENS_SEG_F: D_BUS.25
MIN_TENS_SEG_G: D_BUS.26
MIN_UNIT_SEG_A: D_BUS.14
MIN_UNIT_SEG_B: D_BUS.15
MIN_UNIT_SEG_C: D_BUS.16
MIN_UNIT_SEG_D: D_BUS.17
MIN_UNIT_SEG_E: D_BUS.18
MIN_UNIT_SEG_F: D_BUS.19
MIN_UNIT_SEG_G: D_BUS.20
MON_1_SEG_AB: C_BUS.5, GATE105.Q
MON_1_SEG_C: C_BUS.6, GATE107.Q
MON_1_SEG_D: C_BUS.7, GATE109.Q
MON_1_SEG_EF: C_BUS.8, GATE111.Q
MON_1_SEG_G: C_BUS.9, GATE113.Q
MON_1_SEG_H: C_BUS.10, GATE115.Q
MON_1_SEG_K: C_BUS.11, GATE117.Q
MON_1_SEG_MS: C_BUS.12, GATE131.Q, GATE157.B
MON_1_SEG_N: C_BUS.13, GATE119.Q
MON_1_SEG_P: C_BUS.14, GATE121.Q
MON_1_SEG_R: C_BUS.15, GATE137.Q, GATE163.A, R3.1
MON_1_SEG_U: C_BUS.16, GATE123.Q
MON_2_SEG_AB: C_BUS.17, GATE140.Q
MON_2_SEG_C: C_BUS.18, GATE142.Q
MON_2_SEG_D: C_BUS.19, GATE144.Q
MON_2_SEG_EF: C_BUS.20, GATE146.Q
MON_2_SEG_GH: C_BUS.21, GATE148.Q
MON_2_SEG_PU: C_BUS.22, GATE150.Q
MON_3_SEG_AB: C_BUS.23, GATE152.Q
MON_3_SEG_C: C_BUS.24, GATE154.Q
MON_3_SEG_D: C_BUS.25, GATE156.Q
MON_3_SEG_EF: C_BUS.26, GATE158.Q
MON_3_SEG_GH: C_BUS.27, GATE160.Q
MON_3_SEG_K: C_BUS.28, GATE162.Q
MON_3_SEG_M: C_BUS.29, GATE103.Q, GATE112.B, GATE114.B, GATE169.B
MON_3_SEG_N: C_BUS.30, GATE164.Q
MON_3_SEG_P: C_BUS.31, GATE166.Q
MON_3_SEG_R: C_BUS.32, GATE168.Q
MON_3_SEG_S: C_BUS.33, GATE170.Q
MON_3_SEG_T: C_BUS.34, R3.2
MON_3_SEG_U: C_BUS.35, GATE172.Q
MON_A: B_BUS.10, GATE80.A, GATE92.A, GATE98.A, GATE134.A, GATE136.A
MON_B: B_BUS.11, GATE81.A, GATE97.A, GATE98.B, GATE101.A, GATE103.A, GATE125.A, GATE129.A, GATE132.A, GATE133.A, GATE135.A, GATE136.B, GATE138.A
MON_C: B_BUS.12, GATE82.A, GATE84.A, GATE87.A, GATE88.A, GATE90.A, GATE92.B, GATE103.B, GATE127.A
MON_D: B_BUS.13, GATE83.A, GATE85.A, GATE90.B, GATE95.A, GATE96.A, GATE98.C, GATE125.B, GATE126.A
unnamed: GATE3.Q, GATE4.B, GATE6.C, GATE8.C, GATE9.C, GATE12.B
unnamed: GATE45.Q, GATE46.A
unnamed: GATE57.Q, GATE58.A
unnamed: GATE1.Q, GATE5.A, GATE6.A, GATE15.A, GATE37.C
unnamed: GATE2.Q, GATE8.B, GATE11.B, GATE13.B, GATE16.A, GATE31.C
unnamed: GATE8.Q, GATE21.B, GATE25.B, GATE33.B
unnamed: GATE12.Q, GATE27.B, GATE29.B, GATE39.A
unnamed: GATE6.Q, GATE19.A, GATE21.A, GATE25.A
unnamed: GATE59.Q, GATE60.A
unnamed: GATE4.Q, GATE17.A, GATE27.A, GATE31.A
unnamed: GATE16.Q, GATE39.B
unnamed: GATE15.Q, GATE17.C, GATE33.D, GATE37.B
unnamed: GATE14.Q, GATE33.C, GATE35.B
unnamed: GATE13.Q, GATE19.C, GATE35.A
unnamed: GATE61.Q, GATE62.A
unnamed: GATE63.Q, GATE64.A
unnamed: GATE17.Q, GATE18.A
unnamed: GATE19.Q, GATE20.A
unnamed: GATE21.Q, GATE22.A
unnamed: GATE23.Q, GATE24.A
unnamed: GATE25.Q, GATE26.A
unnamed: GATE27.Q, GATE28.A
unnamed: GATE29.Q, GATE30.A
unnamed: GATE31.Q, GATE32.A
unnamed: GATE33.Q, GATE34.A
unnamed: GATE35.Q, GATE36.A
unnamed: GATE37.Q, GATE38.A
unnamed: GATE39.Q, GATE40.A
unnamed: GATE65.Q, GATE66.A
unnamed: GATE67.Q, GATE68.A
unnamed: GATE69.Q, GATE70.A
unnamed: GATE73.Q, GATE74.A
unnamed: GATE75.Q, GATE76.A
unnamed: GATE93.Q, GATE94.B, GATE95.C, GATE101.B, GATE102.B, GATE126.B, GATE137.C, GATE138.C
unnamed: GATE91.Q, GATE99.B, GATE128.B, GATE129.B, GATE132.C
unnamed: GATE90.Q, GATE91.A, GATE149.A, GATE153.A
unnamed: GATE92.Q, GATE93.A, GATE159.B
unnamed: GATE104.Q, GATE105.A
unnamed: GATE106.Q, GATE107.A
unnamed: GATE108.Q, GATE109.A
unnamed: GATE110.Q, GATE111.A
unnamed: GATE80.Q, GATE84.B, GATE96.B, GATE99.A, GATE100.A, GATE103.C, GATE125.C, GATE127.B, GATE130.A, GATE131.A, GATE132.B, GATE135.B
unnamed: GATE81.Q, GATE87.B, GATE95.B, GATE96.C, GATE102.A, GATE124.A, GATE127.C, GATE128.A, GATE131.B, GATE134.B, GATE137.A
unnamed: GATE82.Q, GATE85.B, GATE139.A, GATE147.A
unnamed: GATE83.Q, GATE88.B, GATE94.A, GATE112.A, GATE137.B, GATE138.B, GATE147.B
unnamed: GATE84.Q, GATE104.A, GATE151.A
unnamed: GATE85.Q, GATE86.A, GATE106.A, GATE108.A, GATE141.A, GATE143.A
unnamed: GATE87.Q, GATE106.B, GATE108.B, GATE159.A
unnamed: GATE88.Q, GATE89.A, GATE145.A
unnamed: GATE86.Q, GATE124.B, GATE130.B, GATE133.B, GATE134.C, GATE135.C, GATE136.C
unnamed: GATE112.Q, GATE113.A
unnamed: GATE114.Q, GATE115.A
unnamed: GATE116.Q, GATE117.A
unnamed: GATE118.Q, GATE119.A
unnamed: GATE120.Q, GATE121.A
unnamed: GATE122.Q, GATE123.A
unnamed: GATE124.Q, GATE145.C, GATE157.C, GATE159.D
unnamed: GATE125.Q, GATE145.B, GATE153.B
unnamed: GATE126.Q, GATE141.C, GATE143.B, GATE167.C
unnamed: GATE127.Q, GATE149.B
unnamed: GATE128.Q, GATE141.B, GATE151.B, GATE165.B, GATE167.B, GATE171.A
unnamed: GATE120.A, GATE138.Q, GATE165.A, GATE171.B
unnamed: GATE89.Q, GATE97.B, GATE100.B, GATE131.C
unnamed: GATE114.A, GATE116.A, GATE118.A, GATE136.Q, GATE163.B, GATE169.A
unnamed: GATE110.A, GATE135.Q, GATE167.A
unnamed: GATE110.B, GATE134.Q
unnamed: GATE133.Q, GATE161.A
unnamed: GATE132.Q, GATE157.A
unnamed: GATE102.Q, GATE112.C, GATE114.C, GATE116.B, GATE141.D, GATE143.C
unnamed: GATE101.Q, GATE108.C, GATE110.C, GATE149.C, GATE153.C
unnamed: GATE100.Q, GATE106.D, GATE108.D, GATE110.D
unnamed: GATE99.Q, GATE114.D, GATE120.B, GATE122.A, GATE165.C
unnamed: GATE98.Q, GATE106.C, GATE139.B, GATE149.D, GATE161.B
unnamed: GATE97.Q, GATE104.B, GATE151.C
unnamed: GATE96.Q, GATE104.C, GATE114.E, GATE120.C, GATE122.B, GATE151.D, GATE165.D
unnamed: GATE95.Q, GATE118.B
unnamed: GATE94.Q, GATE116.C
unnamed: GATE151.Q, GATE152.A
unnamed: GATE130.Q, GATE155.A, GATE159.C
unnamed: GATE129.Q, GATE155.B
unnamed: GATE139.Q, GATE140.A
unnamed: GATE141.Q, GATE142.A
unnamed: GATE41.Q, GATE49.A, GATE53.C, GATE55.B, GATE56.B
unnamed: GATE42.Q, GATE48.C, GATE50.C, GATE55.C
unnamed: GATE43.Q, GATE45.B
unnamed: GATE44.Q, GATE51.C
unnamed: GATE143.Q, GATE144.A
unnamed: GATE46.Q, GATE49.B, GATE52.C, GATE54.B, GATE56.C
unnamed: GATE51.Q, GATE57.E, GATE63.D, GATE67.B, GATE69.B
unnamed: GATE50.Q, GATE57.D, GATE63.C, GATE65.B
unnamed: GATE49.Q, GATE57.C, GATE61.B
unnamed: GATE48.Q, GATE57.B, GATE59.B, GATE63.B, GATE69.A
unnamed: GATE47.Q, GATE57.A, GATE59.A, GATE61.A, GATE63.A, GATE65.A, GATE67.A
unnamed: GATE53.Q, GATE59.D, GATE61.C
unnamed: GATE54.Q, GATE61.D, GATE67.C, GATE69.C
unnamed: GATE55.Q, GATE59.E, GATE61.E
unnamed: GATE56.Q, GATE63.E, GATE67.D, GATE69.D
unnamed: GATE52.Q, GATE59.C
unnamed: GATE145.Q, GATE146.A
unnamed: GATE147.Q, GATE148.A
unnamed: GATE149.Q, GATE150.A
unnamed: GATE153.Q, GATE154.A
unnamed: GATE155.Q, GATE156.A
unnamed: GATE157.Q, GATE158.A
unnamed: GATE159.Q, GATE160.A
unnamed: GATE71.Q, GATE73.A
unnamed: GATE72.Q, GATE75.B, GATE79.A
unnamed: GATE161.Q, GATE162.A
unnamed: GATE163.Q, GATE164.A
unnamed: GATE165.Q, GATE166.A
unnamed: GATE167.Q, GATE168.A
unnamed: GATE169.Q, GATE170.A
unnamed: GATE171.Q, GATE172.A
SEC_TENS_SEG_AD: D_BUS.8
SEC_TENS_SEG_B: D_BUS.9
SEC_TENS_SEG_C: D_BUS.10
SEC_TENS_SEG_E: D_BUS.11
SEC_TENS_SEG_F: D_BUS.12
SEC_TENS_SEG_G: D_BUS.13
SEC_UNIT_SEG_A: D_BUS.1
SEC_UNIT_SEG_B: D_BUS.2
SEC_UNIT_SEG_C: D_BUS.3
SEC_UNIT_SEG_D: D_BUS.4
SEC_UNIT_SEG_E: D_BUS.5
SEC_UNIT_SEG_F: D_BUS.6
SEC_UNIT_SEG_G: D_BUS.7
VDD: A_BUS.38, A_BUS.40, C1.+, R2.1
VSS: A_BUS.37, A_BUS.39, C1.-

Notes on the sheet:
BUS CONNECTORS
DAY OF WEEK DECODER
DECODES A 3 BIT BCD VALUE TO DAY OF WEEK NAMES PER THE FOLLOWING TABLE: CBA 000 0 MO 001 1 TU 010 2 WE 011 3 TH 100 4 FR 101 5 SA 110 6 SU 111 7 (BLANK DISPLAY)
HOURS DISPLAY DECODERS
MONTH DISPLAY DECODERS
DECODES A 4 BIT BCD VALUE TO MONTH NAMES PER THE FOLLOWING TABLE: DCBA 0000 0 JAN 0001 1 FEB 0010 2 MAR 0011 3 APR 0100 4 MAY 0101 5 JUN 0110 6 JUL 0111 7 AUG 1000 8 SEP 1001 9 OCT 1010 10 NOV 1011 11 DEC 11XX 12-15 (BLANK DISPLAY) X = DONT CARE
