tomstorey/discrete-nor-logic-clock/schematics/calendar-module.sch

## EAGLE design schematics/calendar-module.sch (2017-09-22)

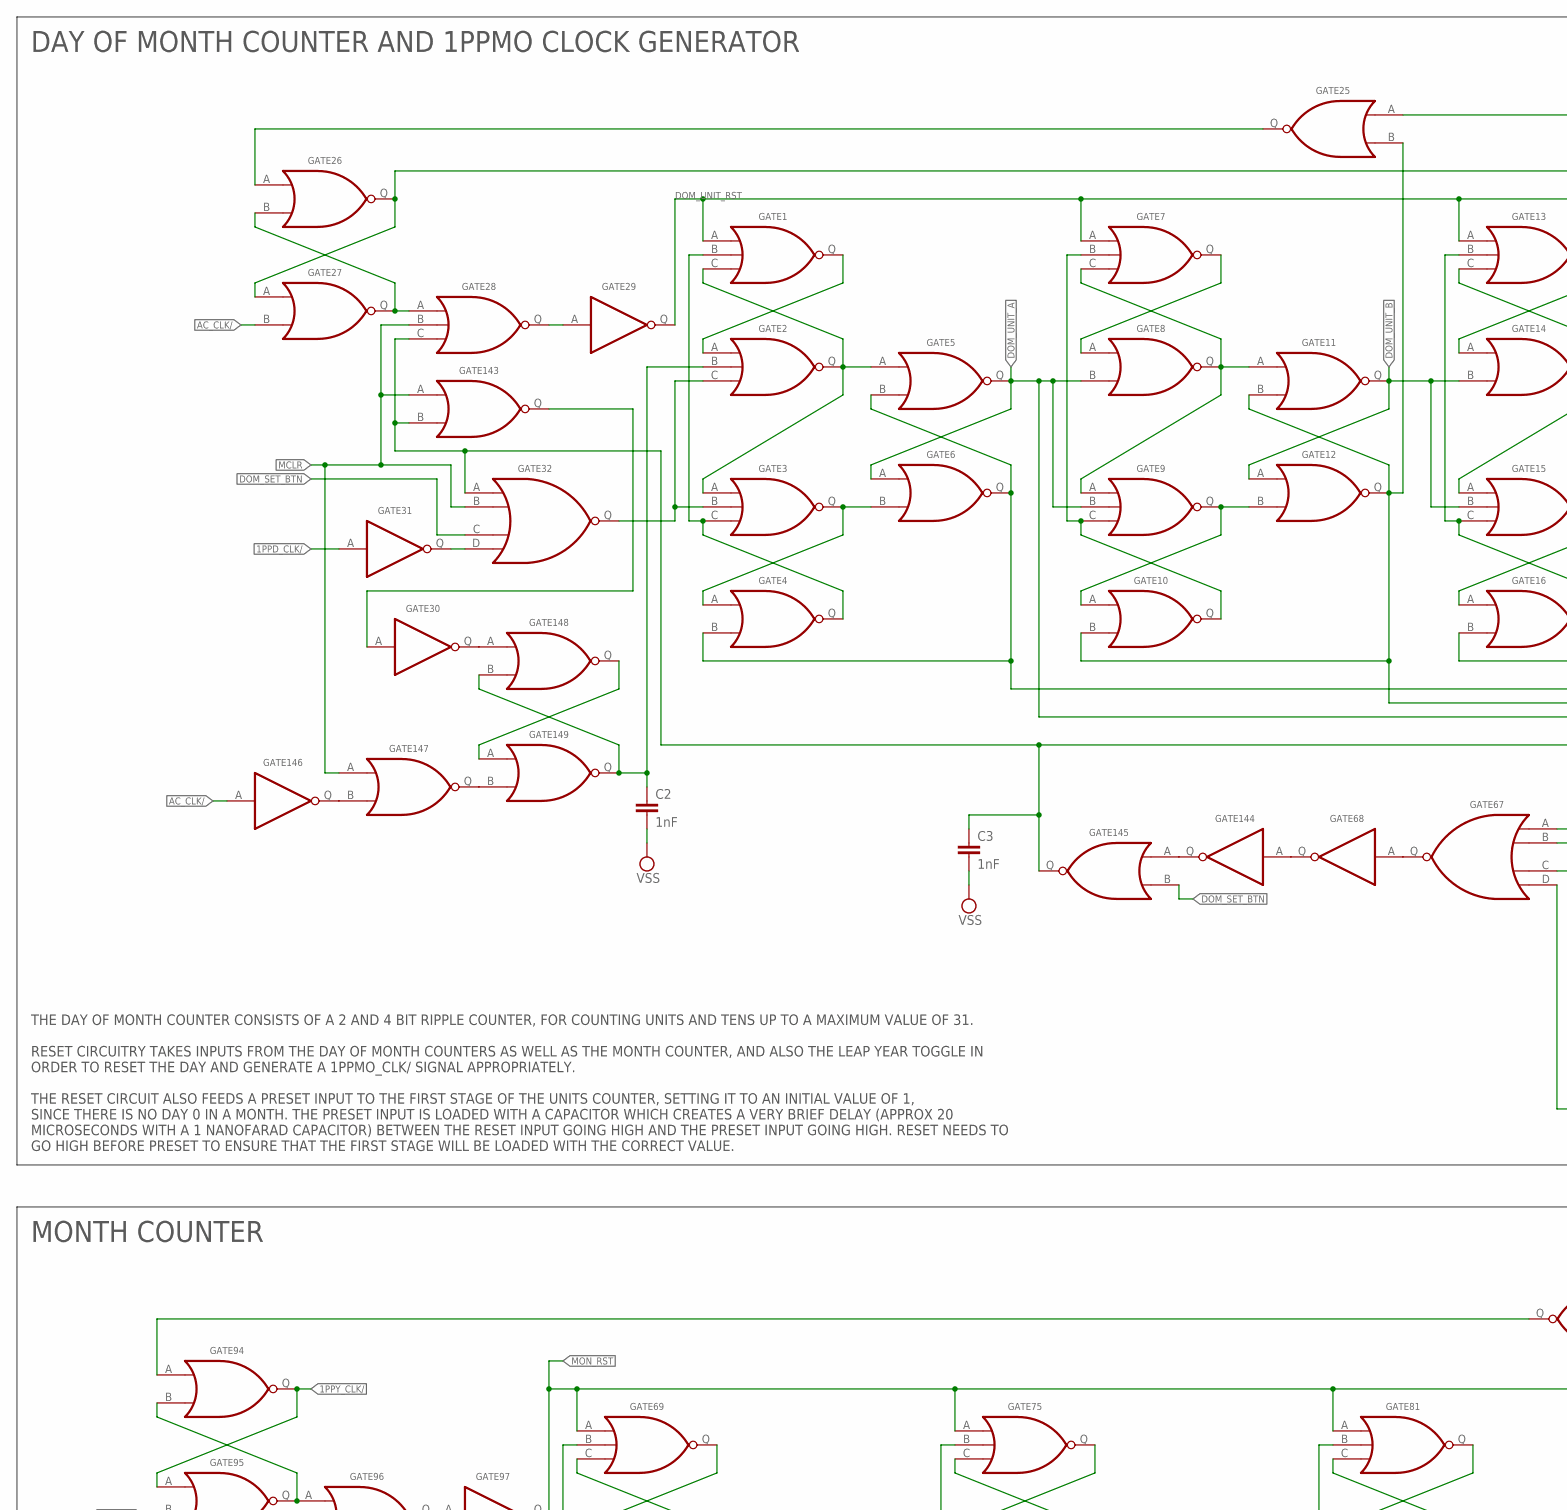
[picture p14: schematic calendar-module.sch, part in row 1, column 1]

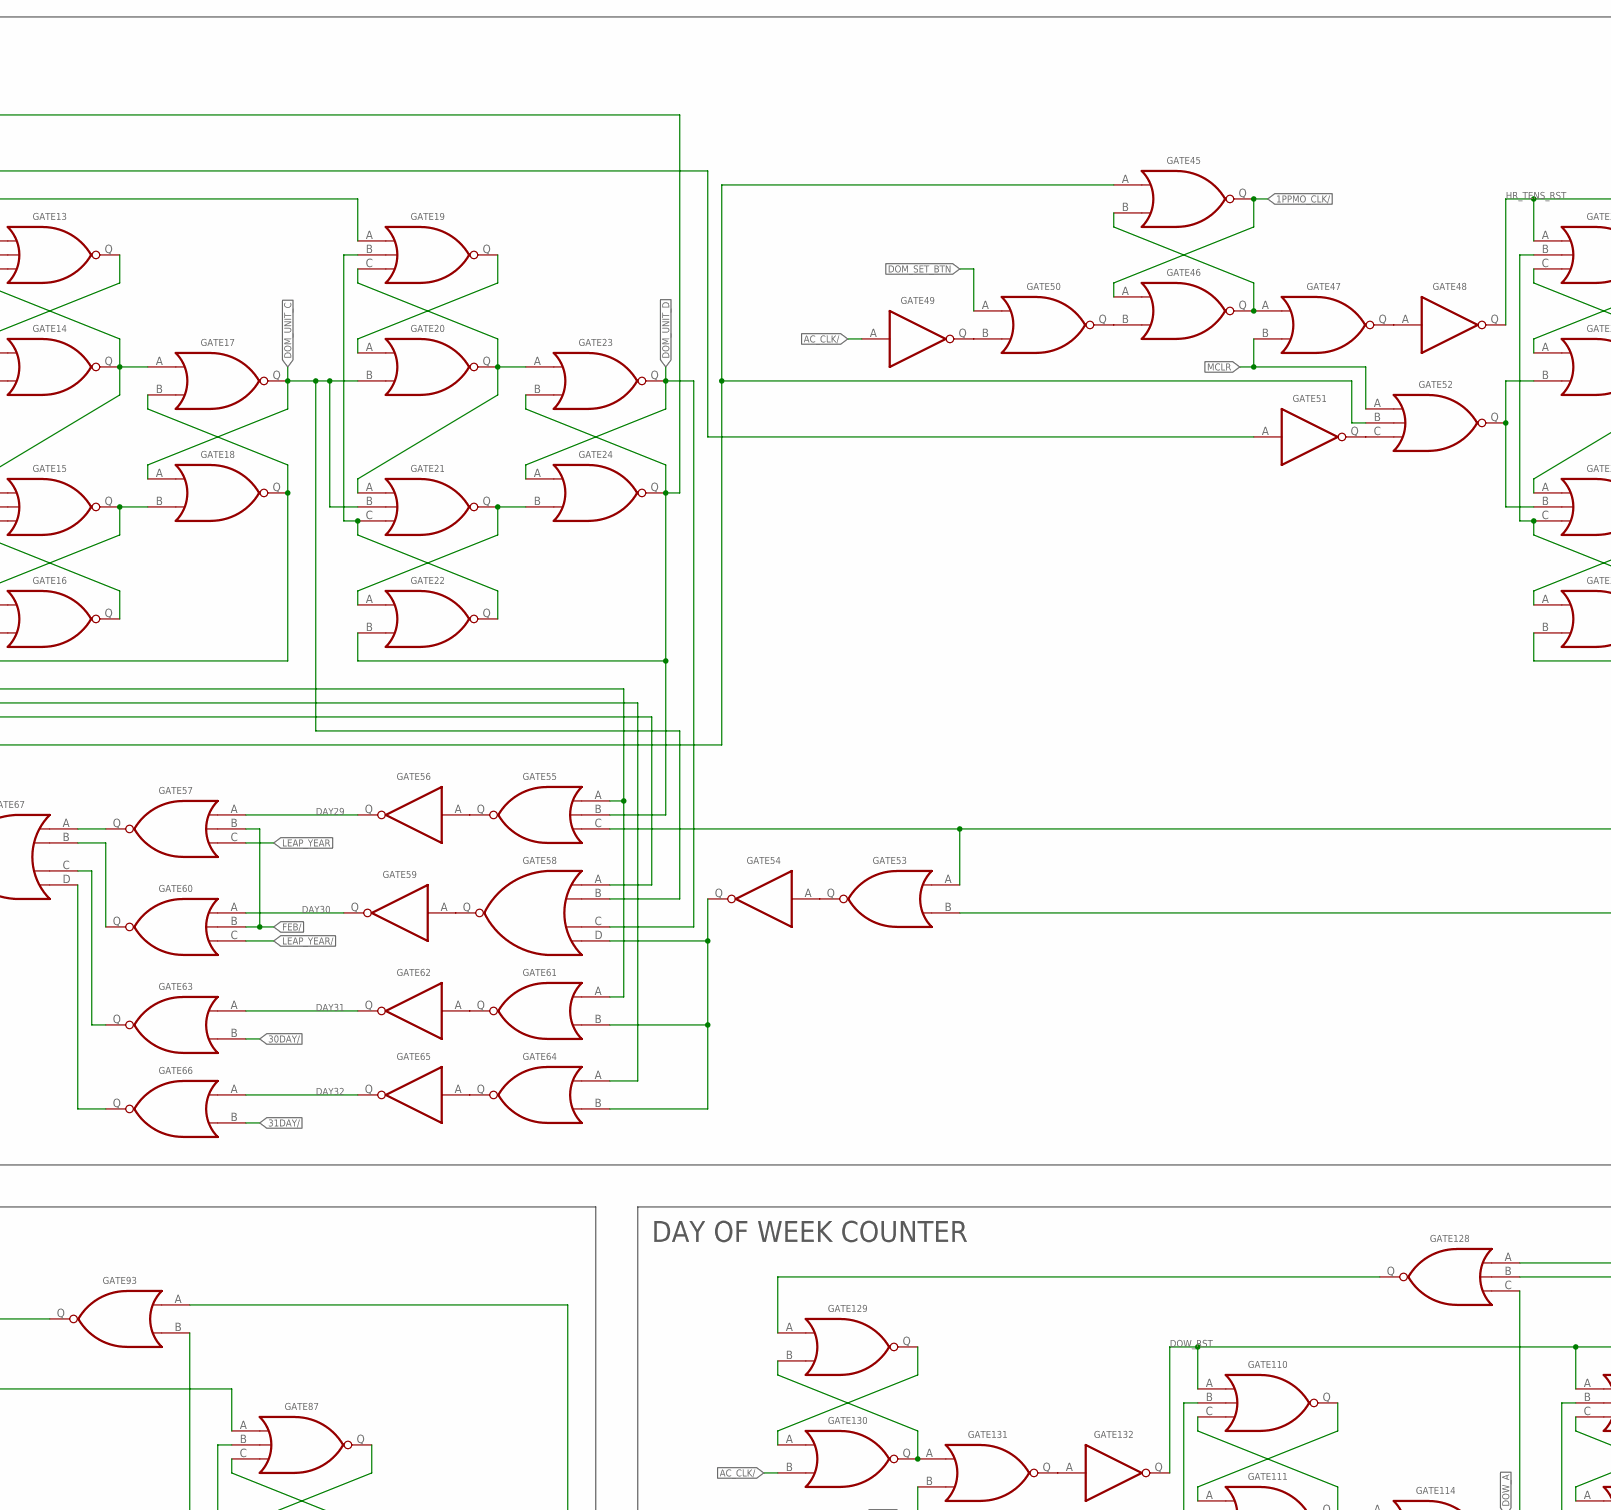
[picture p15: schematic calendar-module.sch, part in row 1, column 2]

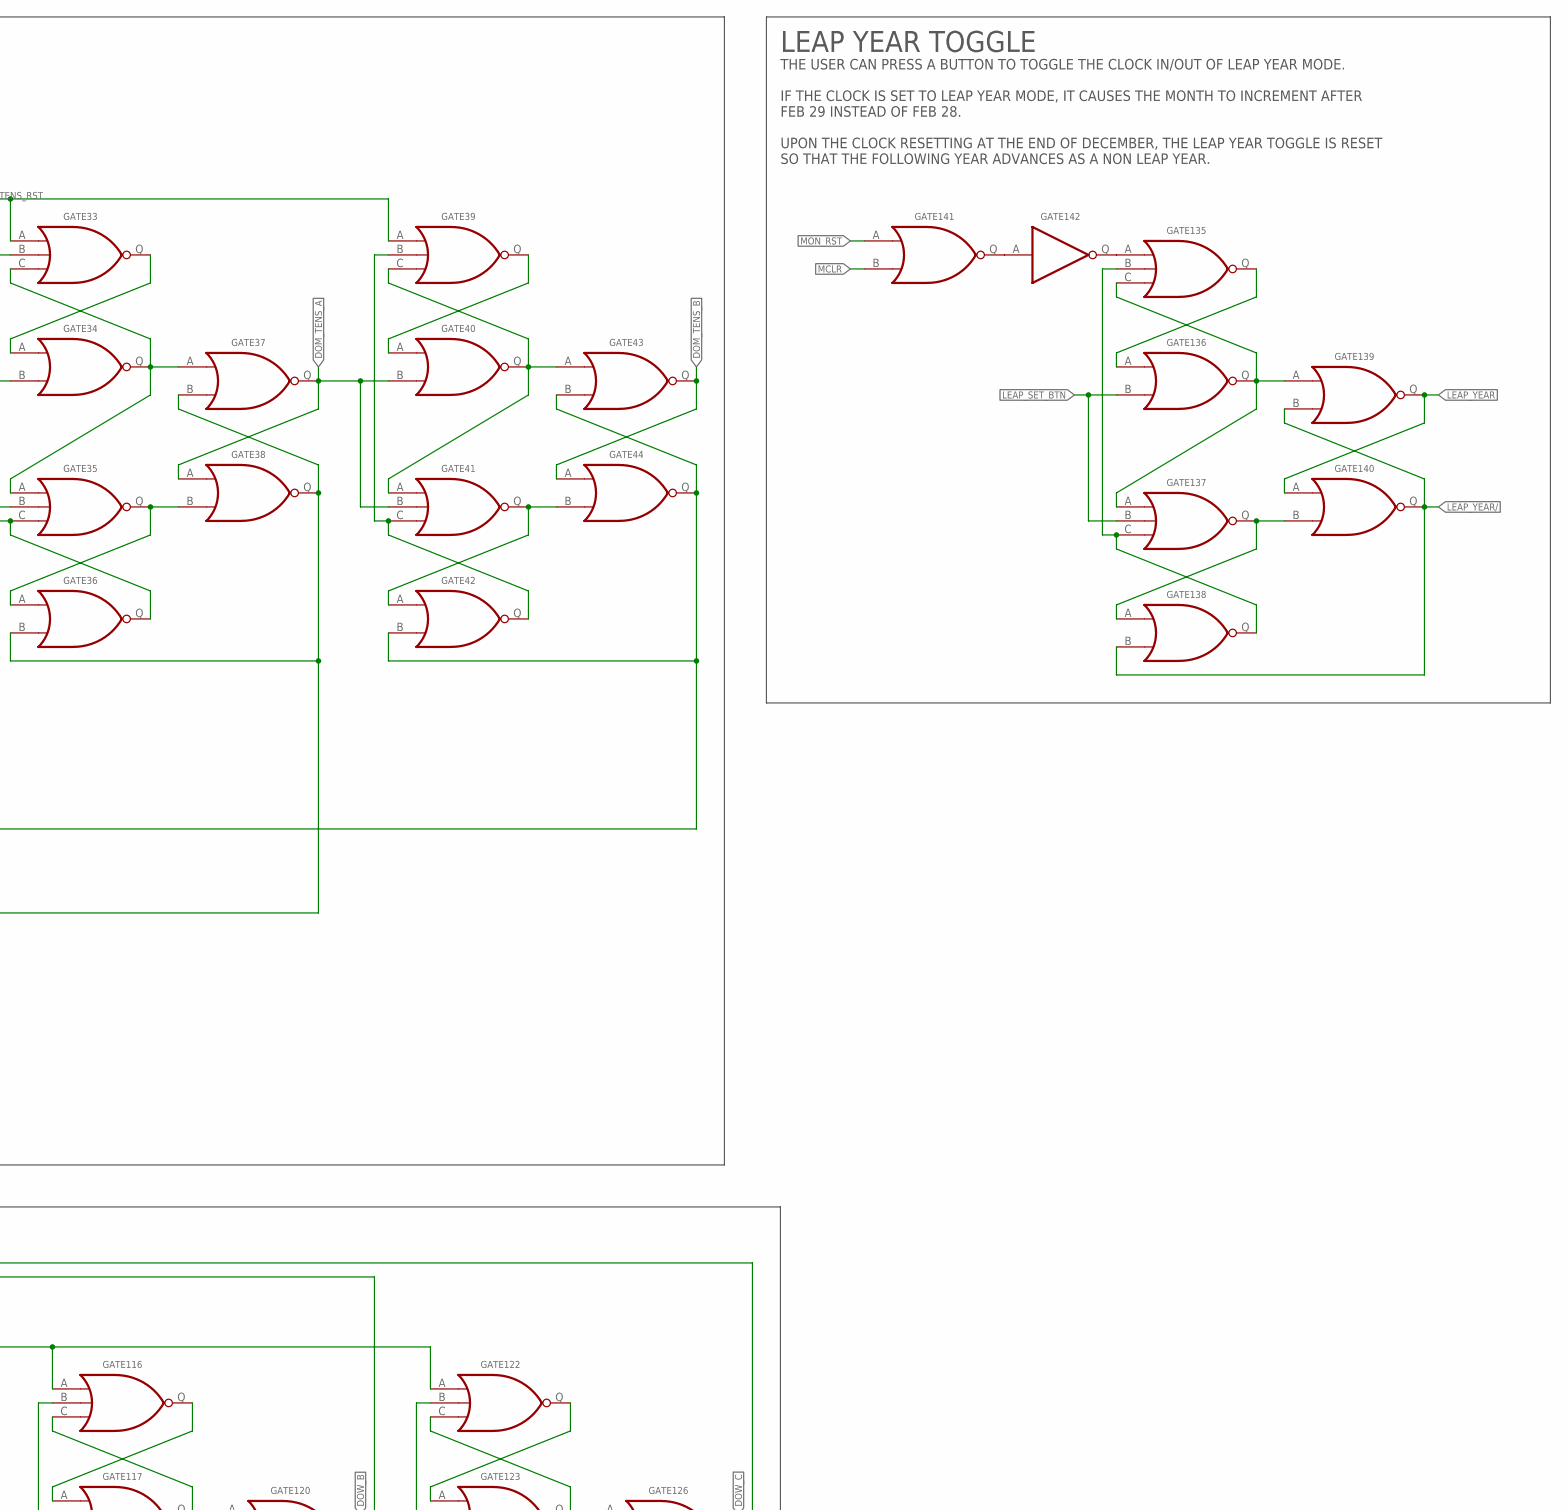
[picture p16: schematic calendar-module.sch, part in row 1, column 3]

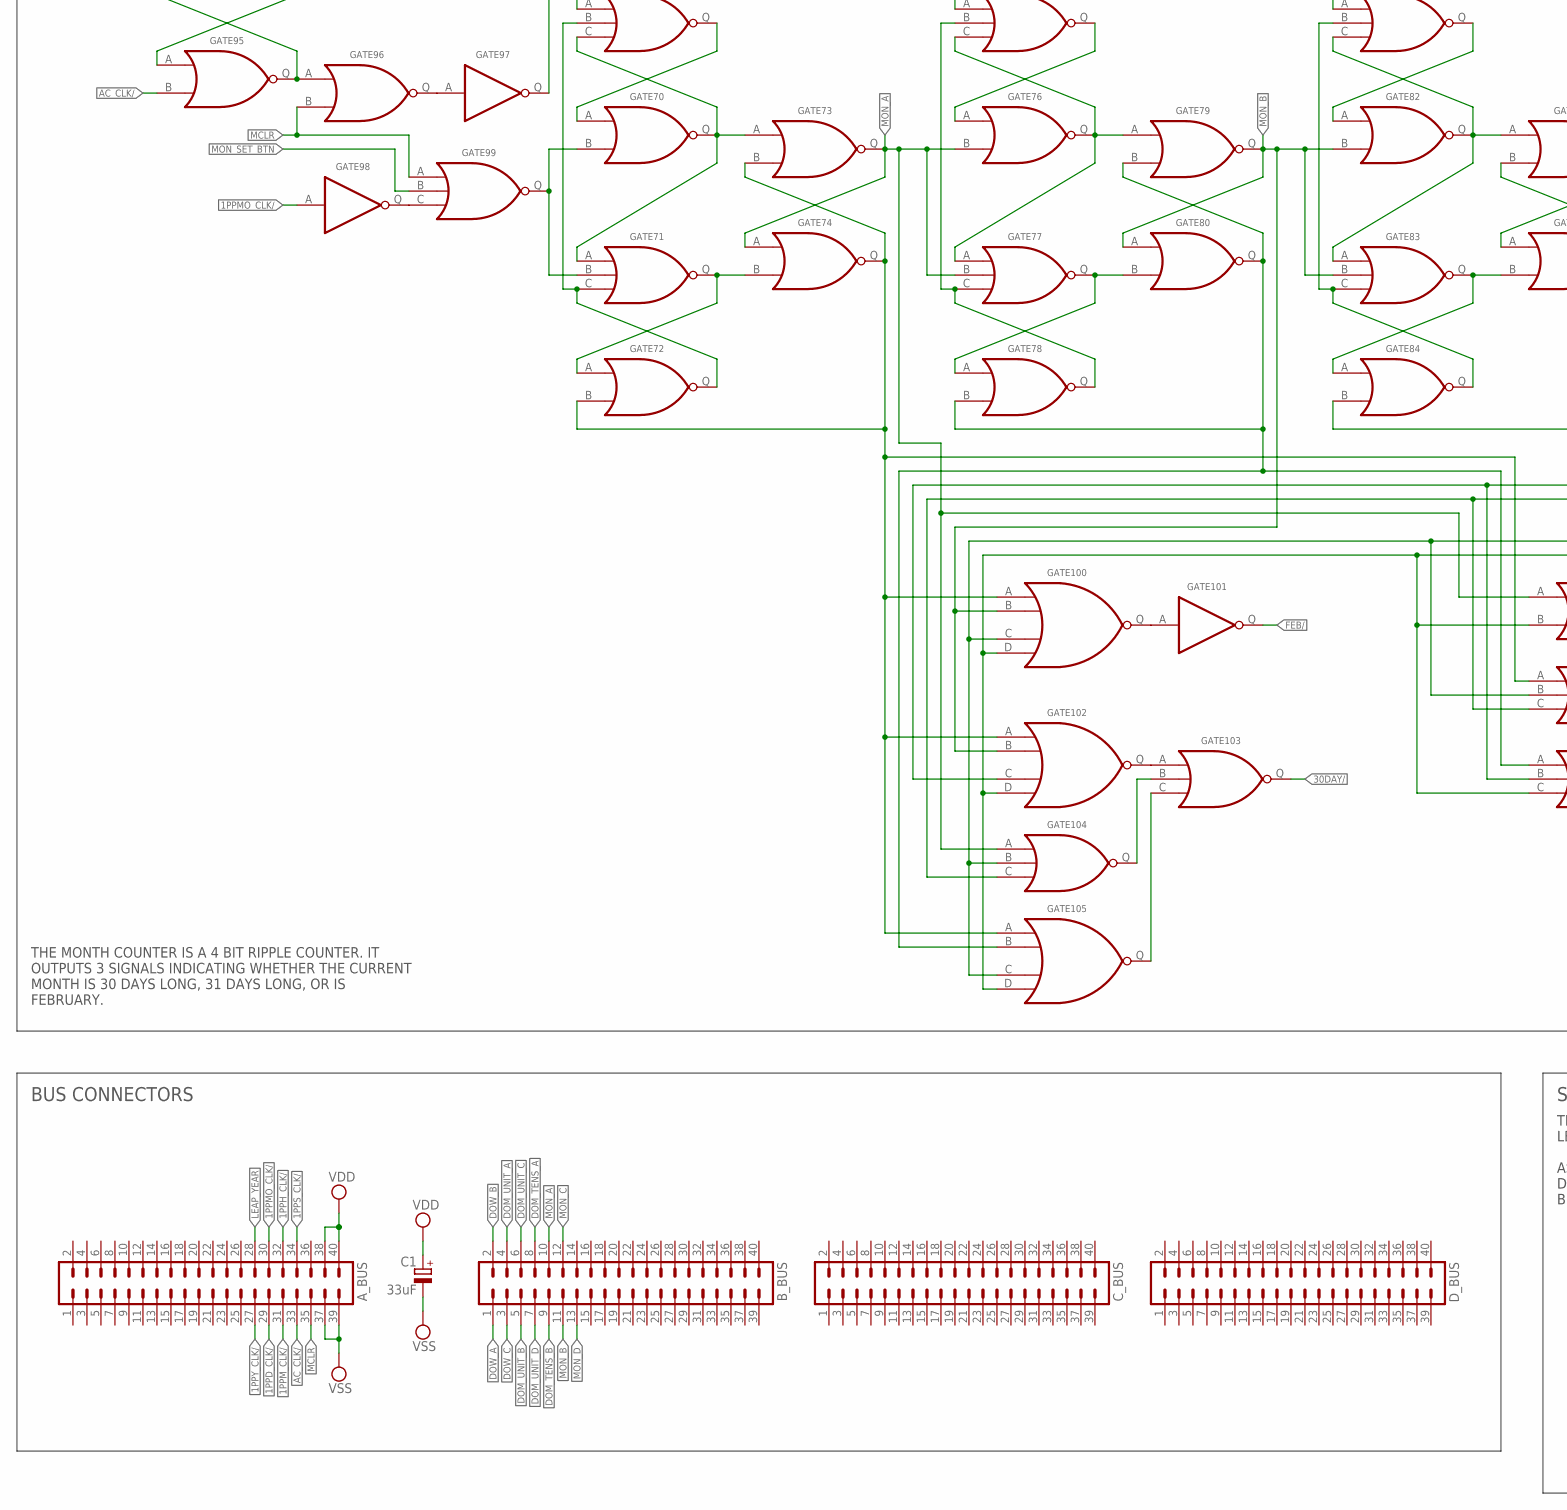
[picture p17: schematic calendar-module.sch, part in row 2, column 1]

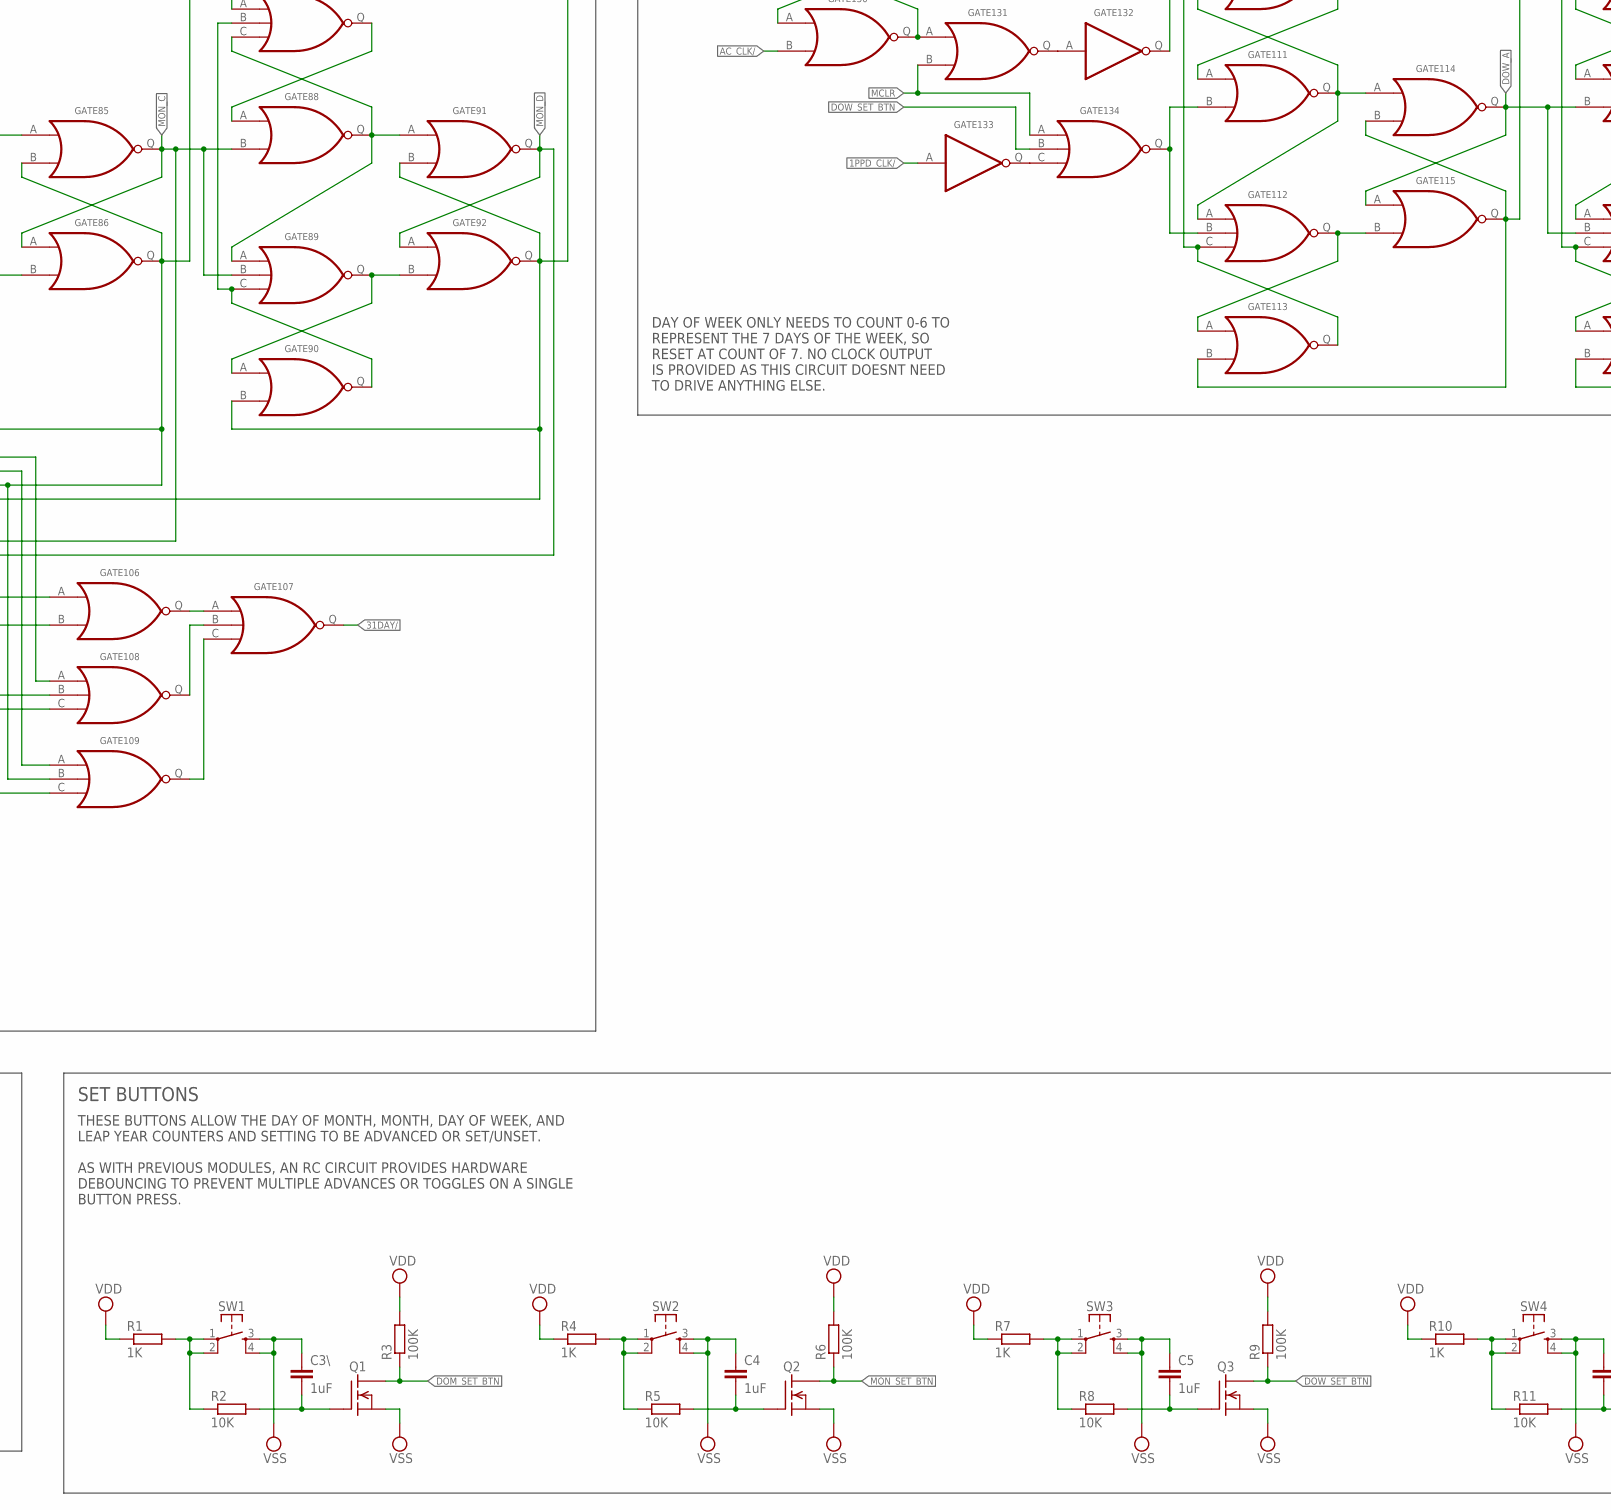
[picture p18: schematic calendar-module.sch, part in row 2, column 2]

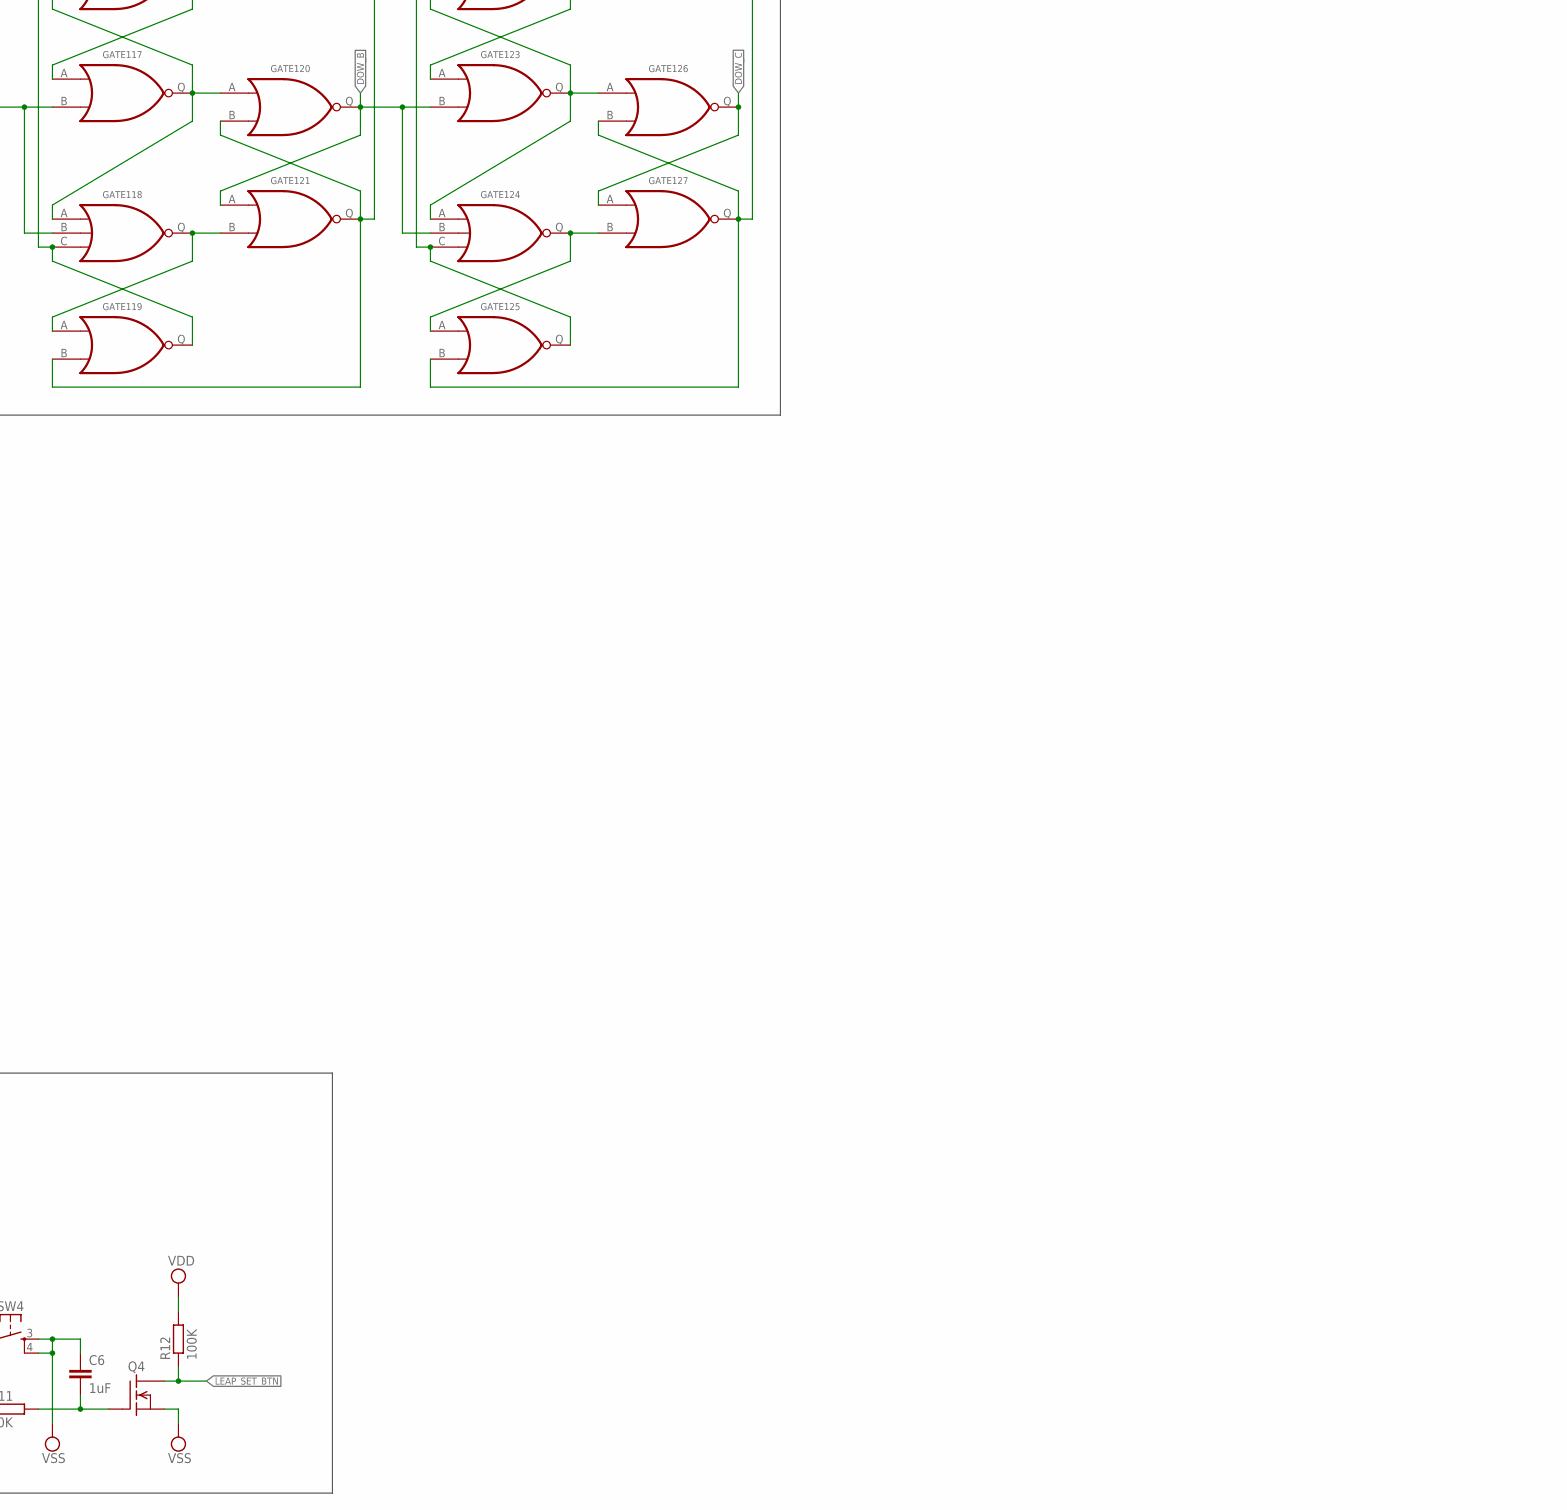
[picture p19: schematic calendar-module.sch, part in row 2, column 3]

Parts:
A_BUS: MA20-2
B_BUS: MA20-2
C1: 33uF; E2,5-6
C2, C3: 1nF; C050-025X075
C3\, C4, C5, C6: 1uF; C050-025X075
C_BUS: MA20-2
D_BUS: MA20-2
GATE1, GATE2, GATE3, GATE7, GATE9, GATE13, GATE15, GATE19, GATE21, GATE28, GATE33, GATE35, GATE39, GATE41, GATE52, GATE55, GATE57, GATE60, GATE69, GATE71, GATE75, GATE77, GATE81, GATE83, GATE87, GATE89, GATE99, GATE103, GATE104, GATE107, GATE108, GATE109, GATE110, GATE112, GATE116, GATE118, GATE122, GATE124, GATE128, GATE134, GATE135, GATE137: 3NOR
GATE4, GATE5, GATE6, GATE8, GATE10, GATE11, GATE12, GATE14, GATE16, GATE17, GATE18, GATE20, GATE22, GATE23, GATE24, GATE25, GATE26, GATE27, GATE34, GATE36, GATE37, GATE38, GATE40, GATE42, GATE43, GATE44, GATE45, GATE46, GATE47, GATE50, GATE53, GATE61, GATE63, GATE64, GATE66, GATE70, GATE72, GATE73, GATE74, GATE76, GATE78, GATE79, GATE80, GATE82, GATE84, GATE85, GATE86, GATE88, GATE90, GATE91, GATE92, GATE93, GATE94, GATE95, GATE96, GATE106, GATE111, GATE113, GATE114, GATE115, GATE117, GATE119, GATE120, GATE121, GATE123, GATE125, GATE126, GATE127, GATE129, GATE130, GATE131, GATE136, GATE138, GATE139, GATE140, GATE141, GATE143, GATE145, GATE147, GATE148, GATE149: 2NOR
GATE29, GATE30, GATE31, GATE48, GATE49, GATE51, GATE54, GATE56, GATE59, GATE62, GATE65, GATE68, GATE97, GATE98, GATE101, GATE132, GATE133, GATE142, GATE144, GATE146: INVERTER
GATE32, GATE58, GATE67, GATE100, GATE102, GATE105: 4NOR
Q1, Q2, Q3, Q4: 2N7000; TO-92
R1, R4, R7, R10: 1K; 0207/2V
R2, R5, R8, R11: 10K; 0207/2V
R3, R6, R9, R12: 100K; 0207/2V
SW1, SW2, SW3, SW4: SPST-TACSWITCH; TE-SMD-TACSWITCH

Connections:
1PPD_CLK/: A_BUS.29, GATE31.A, GATE133.A
1PPH_CLK/: A_BUS.32
1PPMO_CLK/: A_BUS.30, GATE45.Q, GATE46.A, GATE98.A
1PPM_CLK/: A_BUS.31
1PPS_CLK/: A_BUS.34
1PPY_CLK/: A_BUS.27, GATE94.Q, GATE95.A
30DAY/: GATE63.B, GATE103.Q
31DAY/: GATE66.B, GATE107.Q
AC_CLK/: A_BUS.33, GATE27.B, GATE49.A, GATE95.B, GATE130.B, GATE146.A
DAY29: GATE56.Q, GATE57.A
DAY30: GATE59.Q, GATE60.A
DAY31: GATE62.Q, GATE63.A
DAY32: GATE65.Q, GATE66.A
DOM_RESET: C3.1, GATE28.C, GATE32.A, GATE45.A, GATE52.B, GATE143.B, GATE145.Q
DOM_SET_BTN: GATE32.C, GATE50.A, GATE145.B, Q1.3 (D), R3.1
DOM_TENS_A: B_BUS.8, GATE37.Q, GATE38.A, GATE40.B, GATE41.B
DOM_TENS_B: B_BUS.9, GATE43.Q, GATE44.A
DOM_UNIT_A: B_BUS.4, GATE5.Q, GATE6.A, GATE8.B, GATE9.B, GATE58.A
DOM_UNIT_B: B_BUS.5, GATE11.Q, GATE12.A, GATE14.B, GATE15.B
DOM_UNIT_C: B_BUS.6, GATE17.Q, GATE18.A, GATE20.B, GATE21.B, GATE58.B
DOM_UNIT_D: B_BUS.7, GATE23.Q, GATE24.A, GATE58.C
DOM_UNIT_RST: GATE1.A, GATE7.A, GATE13.A, GATE19.A, GATE29.Q
DOM_UNIT_RST/: GATE26.Q, GATE27.A, GATE51.A
DOW_A: B_BUS.1, GATE114.Q, GATE115.A, GATE117.B, GATE118.B
DOW_B: B_BUS.2, GATE120.Q, GATE121.A, GATE123.B, GATE124.B
DOW_C: B_BUS.3, GATE126.Q, GATE127.A
DOW_RST: GATE110.A, GATE116.A, GATE122.A, GATE132.Q
DOW_SET_BTN: GATE134.B, Q3.3 (D), R9.1
FEB/: GATE57.B, GATE60.B, GATE101.Q
HR_TENS_RST: GATE33.A, GATE39.A, GATE48.Q
LEAP_SET_BTN: GATE136.B, GATE137.B, Q4.3 (D), R12.1
LEAP_YEAR: A_BUS.28, GATE57.C, GATE139.Q, GATE140.A
LEAP_YEAR/: GATE60.C, GATE138.B, GATE139.B, GATE140.Q
MCLR: A_BUS.35, GATE28.B, GATE32.B, GATE47.B, GATE52.A, GATE96.B, GATE99.A, GATE131.B, GATE134.A, GATE141.B, GATE143.A, GATE147.A
MON_A: B_BUS.10, GATE73.Q, GATE74.A, GATE76.B, GATE77.B, GATE104.A, GATE106.A
MON_B: B_BUS.11, GATE79.Q, GATE80.A, GATE82.B, GATE83.B, GATE100.B, GATE102.B
MON_C: B_BUS.12, GATE85.Q, GATE86.A, GATE88.B, GATE89.B, GATE100.C, GATE104.B, GATE105.C, GATE108.B
MON_D: B_BUS.13, GATE91.Q, GATE92.A, GATE100.D, GATE102.D, GATE105.D, GATE106.B, GATE109.C
MON_RST: GATE69.A, GATE75.A, GATE81.A, GATE87.A, GATE97.Q, GATE141.A
MON_SET_BTN: GATE99.B, Q2.3 (D), R6.1
unnamed: GATE28.Q, GATE29.A
unnamed: GATE45.B, GATE46.Q, GATE47.A
unnamed: GATE47.Q, GATE48.A
unnamed: GATE129.B, GATE130.Q, GATE131.A
unnamed: GATE46.B, GATE50.Q
unnamed: GATE49.Q, GATE50.B
unnamed: GATE51.Q, GATE52.C
unnamed: GATE53.Q, GATE54.A
unnamed: GATE58.Q, GATE59.A
unnamed: GATE61.Q, GATE62.A
unnamed: GATE96.Q, GATE97.A
unnamed: GATE2.C, GATE3.B, GATE32.Q
unnamed: GATE98.Q, GATE99.C
unnamed: GATE69.C, GATE70.Q, GATE71.A, GATE73.A
unnamed: GATE69.Q, GATE70.A
unnamed: GATE69.B, GATE71.C, GATE72.Q
unnamed: GATE71.Q, GATE72.A, GATE74.B
unnamed: GATE72.B, GATE73.B, GATE74.Q, GATE100.A, GATE102.A, GATE105.A, GATE108.A
unnamed: GATE75.C, GATE76.Q, GATE77.A, GATE79.A
unnamed: GATE75.Q, GATE76.A
unnamed: GATE75.B, GATE77.C, GATE78.Q
unnamed: GATE77.Q, GATE78.A, GATE80.B
unnamed: GATE78.B, GATE79.B, GATE80.Q, GATE105.B, GATE109.A
unnamed: GATE81.C, GATE82.Q, GATE83.A, GATE85.A
unnamed: GATE81.Q, GATE82.A
unnamed: GATE100.Q, GATE101.A
unnamed: GATE81.B, GATE83.C, GATE84.Q
unnamed: GATE83.Q, GATE84.A, GATE86.B
unnamed: GATE84.B, GATE85.B, GATE86.Q, GATE93.B, GATE102.C, GATE109.B
unnamed: GATE87.C, GATE88.Q, GATE89.A, GATE91.A
unnamed: GATE54.Q, GATE58.D, GATE61.B, GATE64.B
unnamed: GATE87.Q, GATE88.A
unnamed: GATE87.B, GATE89.C, GATE90.Q
unnamed: GATE89.Q, GATE90.A, GATE92.B
unnamed: GATE90.B, GATE91.B, GATE92.Q, GATE93.A, GATE104.C, GATE108.C
unnamed: GATE131.Q, GATE132.A
unnamed: GATE94.B, GATE95.Q, GATE96.A
unnamed: GATE146.Q, GATE147.B
unnamed: GATE133.Q, GATE134.C
unnamed: GATE135.A, GATE142.Q
unnamed: GATE103.B, GATE104.Q
unnamed: GATE103.C, GATE105.Q
unnamed: GATE106.Q, GATE107.A
unnamed: GATE107.B, GATE108.Q
unnamed: GATE107.C, GATE109.Q
unnamed: GATE26.B, GATE27.Q, GATE28.A
unnamed: GATE31.Q, GATE32.D
unnamed: GATE34.B, GATE35.B, GATE52.Q
unnamed: GATE110.C, GATE111.Q, GATE112.A, GATE114.A
unnamed: GATE110.Q, GATE111.A
unnamed: GATE110.B, GATE112.C, GATE113.Q
unnamed: GATE112.Q, GATE113.A, GATE115.B
unnamed: GATE93.Q, GATE94.A
unnamed: GATE113.B, GATE114.B, GATE115.Q, GATE128.C
unnamed: GATE116.C, GATE117.Q, GATE118.A, GATE120.A
unnamed: GATE116.Q, GATE117.A
unnamed: GATE148.Q, GATE149.A
unnamed: GATE116.B, GATE118.C, GATE119.Q
unnamed: GATE118.Q, GATE119.A, GATE121.B
unnamed: GATE119.B, GATE120.B, GATE121.Q, GATE128.B
unnamed: GATE122.C, GATE123.Q, GATE124.A, GATE126.A
unnamed: C2.1, GATE2.B, GATE148.B, GATE149.Q
unnamed: GATE122.Q, GATE123.A
unnamed: GATE122.B, GATE124.C, GATE125.Q
unnamed: GATE124.Q, GATE125.A, GATE127.B
unnamed: GATE57.Q, GATE67.A
unnamed: GATE60.Q, GATE67.B
unnamed: GATE63.Q, GATE67.C
unnamed: GATE68.Q, GATE144.A
unnamed: GATE144.Q, GATE145.A
unnamed: GATE125.B, GATE126.B, GATE127.Q, GATE128.A
unnamed: GATE128.Q, GATE129.A
unnamed: GATE66.Q, GATE67.D
unnamed: GATE55.Q, GATE56.A
unnamed: GATE70.B, GATE71.B, GATE99.Q
unnamed: GATE147.Q, GATE149.B
unnamed: GATE129.Q, GATE130.A
unnamed: GATE102.Q, GATE103.A
unnamed: GATE111.B, GATE112.B, GATE134.Q
unnamed: GATE135.C, GATE136.Q, GATE137.A, GATE139.A
unnamed: GATE135.Q, GATE136.A
unnamed: GATE135.B, GATE137.C, GATE138.Q
unnamed: GATE1.C, GATE2.Q, GATE3.A, GATE5.A
unnamed: GATE1.Q, GATE2.A
unnamed: GATE1.B, GATE3.C, GATE4.Q
unnamed: GATE3.Q, GATE4.A, GATE6.B
unnamed: GATE4.B, GATE5.B, GATE6.Q, GATE55.A, GATE61.A
unnamed: GATE7.C, GATE8.Q, GATE9.A, GATE11.A
unnamed: GATE7.Q, GATE8.A
unnamed: GATE7.B, GATE9.C, GATE10.Q
unnamed: GATE9.Q, GATE10.A, GATE12.B
unnamed: GATE10.B, GATE11.B, GATE12.Q, GATE25.B, GATE64.A
unnamed: GATE13.C, GATE14.Q, GATE15.A, GATE17.A
unnamed: GATE13.Q, GATE14.A
unnamed: GATE13.B, GATE15.C, GATE16.Q
unnamed: GATE15.Q, GATE16.A, GATE18.B
unnamed: GATE16.B, GATE17.B, GATE18.Q
unnamed: GATE19.C, GATE20.Q, GATE21.A, GATE23.A
unnamed: GATE19.Q, GATE20.A
unnamed: GATE19.B, GATE21.C, GATE22.Q
unnamed: GATE21.Q, GATE22.A, GATE24.B
unnamed: GATE22.B, GATE23.B, GATE24.Q, GATE25.A, GATE55.B
unnamed: GATE25.Q, GATE26.A
unnamed: GATE137.Q, GATE138.A, GATE140.B
unnamed: GATE141.Q, GATE142.A
unnamed: GATE64.Q, GATE65.A
unnamed: GATE67.Q, GATE68.A
unnamed: GATE33.C, GATE34.Q, GATE35.A, GATE37.A
unnamed: GATE33.Q, GATE34.A
unnamed: GATE33.B, GATE35.C, GATE36.Q
unnamed: GATE35.Q, GATE36.A, GATE38.B
unnamed: GATE36.B, GATE37.B, GATE38.Q, GATE53.B
unnamed: GATE39.C, GATE40.Q, GATE41.A, GATE43.A
unnamed: GATE39.Q, GATE40.A
unnamed: GATE39.B, GATE41.C, GATE42.Q
unnamed: GATE41.Q, GATE42.A, GATE44.B
unnamed: GATE30.Q, GATE148.A
unnamed: R4.2, R5.1, SW2.1, SW2.2
unnamed: C4.2, Q2.2 (G), R5.2
unnamed: GATE42.B, GATE43.B, GATE44.Q, GATE53.A, GATE55.C
unnamed: R7.2, R8.1, SW3.1, SW3.2
unnamed: R1.2, R2.1, SW1.1, SW1.2
unnamed: C5.2, Q3.2 (G), R8.2
unnamed: R10.2, R11.1, SW4.1, SW4.2
unnamed: C6.2, Q4.2 (G), R11.2
unnamed: GATE30.A, GATE143.Q
unnamed: C3\.2, Q1.2 (G), R2.2
VDD: A_BUS.38, A_BUS.40, C1.+, R1.1, R3.2, R4.1, R6.2, R7.1, R9.2, R10.1, R12.2
VSS: A_BUS.37, A_BUS.39, C1.-, C2.2, C3.2, C3\.1, C4.1, C5.1, C6.1, Q1.1 (S), Q2.1 (S), Q3.1 (S), Q4.1 (S), SW1.3, SW1.4, SW2.3, SW2.4, SW3.3, SW3.4, SW4.3, SW4.4

Notes on the sheet:
DAY OF MONTH COUNTER AND 1PPMO CLOCK GENERATOR
THE DAY OF MONTH COUNTER CONSISTS OF A 2 AND 4 BIT RIPPLE COUNTER, FOR COUNTING UNITS AND TENS UP TO A MAXIMUM VALUE OF 31. RESET CIRCUITRY TAKES INPUTS FROM THE DAY OF MONTH COUNTERS AS WELL AS THE MONTH COUNTER, AND ALSO THE LEAP YEAR TOGGLE IN ORDER TO RESET THE DAY AND GENERATE A 1PPMO_CLK/ SIG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
MONTH COUNTER
THE MONTH COUNTER IS A 4 BIT RIPPLE COUNTER. IT OUTPUTS 3 SIGNALS INDICATING WHETHER THE CURRENT MONTH IS 30 DAYS LONG, 31 DAYS LONG, OR IS FEBRUARY.
DAY OF WEEK COUNTER
DAY OF WEEK ONLY NEEDS TO COUNT 0-6 TO REPRESENT THE 7 DAYS OF THE WEEK, SO RESET AT COUNT OF 7. NO CLOCK OUTPUT IS PROVIDED AS THIS CIRCUIT DOESNT NEED TO DRIVE ANYTHING ELSE.
LEAP YEAR TOGGLE
THE USER CAN PRESS A BUTTON TO TOGGLE THE CLOCK IN/OUT OF LEAP YEAR MODE. IF THE CLOCK IS SET TO LEAP YEAR MODE, IT CAUSES THE MONTH TO INCREMENT AFTER FEB 29 INSTEAD OF FEB 28. UPON THE CLOCK RESETTING AT THE END OF DECEMBER, THE LEAP YEAR TOGGLE IS RESET SO THAT THE FOLLOWING YEAR ADVANCES AS A N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
SET BUTTONS
THESE BUTTONS ALLOW THE DAY OF MONTH, MONTH, DAY OF WEEK, AND LEAP YEAR COUNTERS AND SETTING TO BE ADVANCED OR SET/UNSET. AS WITH PREVIOUS MODULES, AN RC CIRCUIT PROVIDES HARDWARE DEBOUNCING TO PREVENT MULTIPLE ADVANCES OR TOGGLES ON A SINGLE BUTTON PRESS.
BUS CONNECTORS
