tomstorey/discrete-nor-logic-clock/schematics/display-board.sch

## EAGLE design schematics/display-board.sch (2017-11-10)

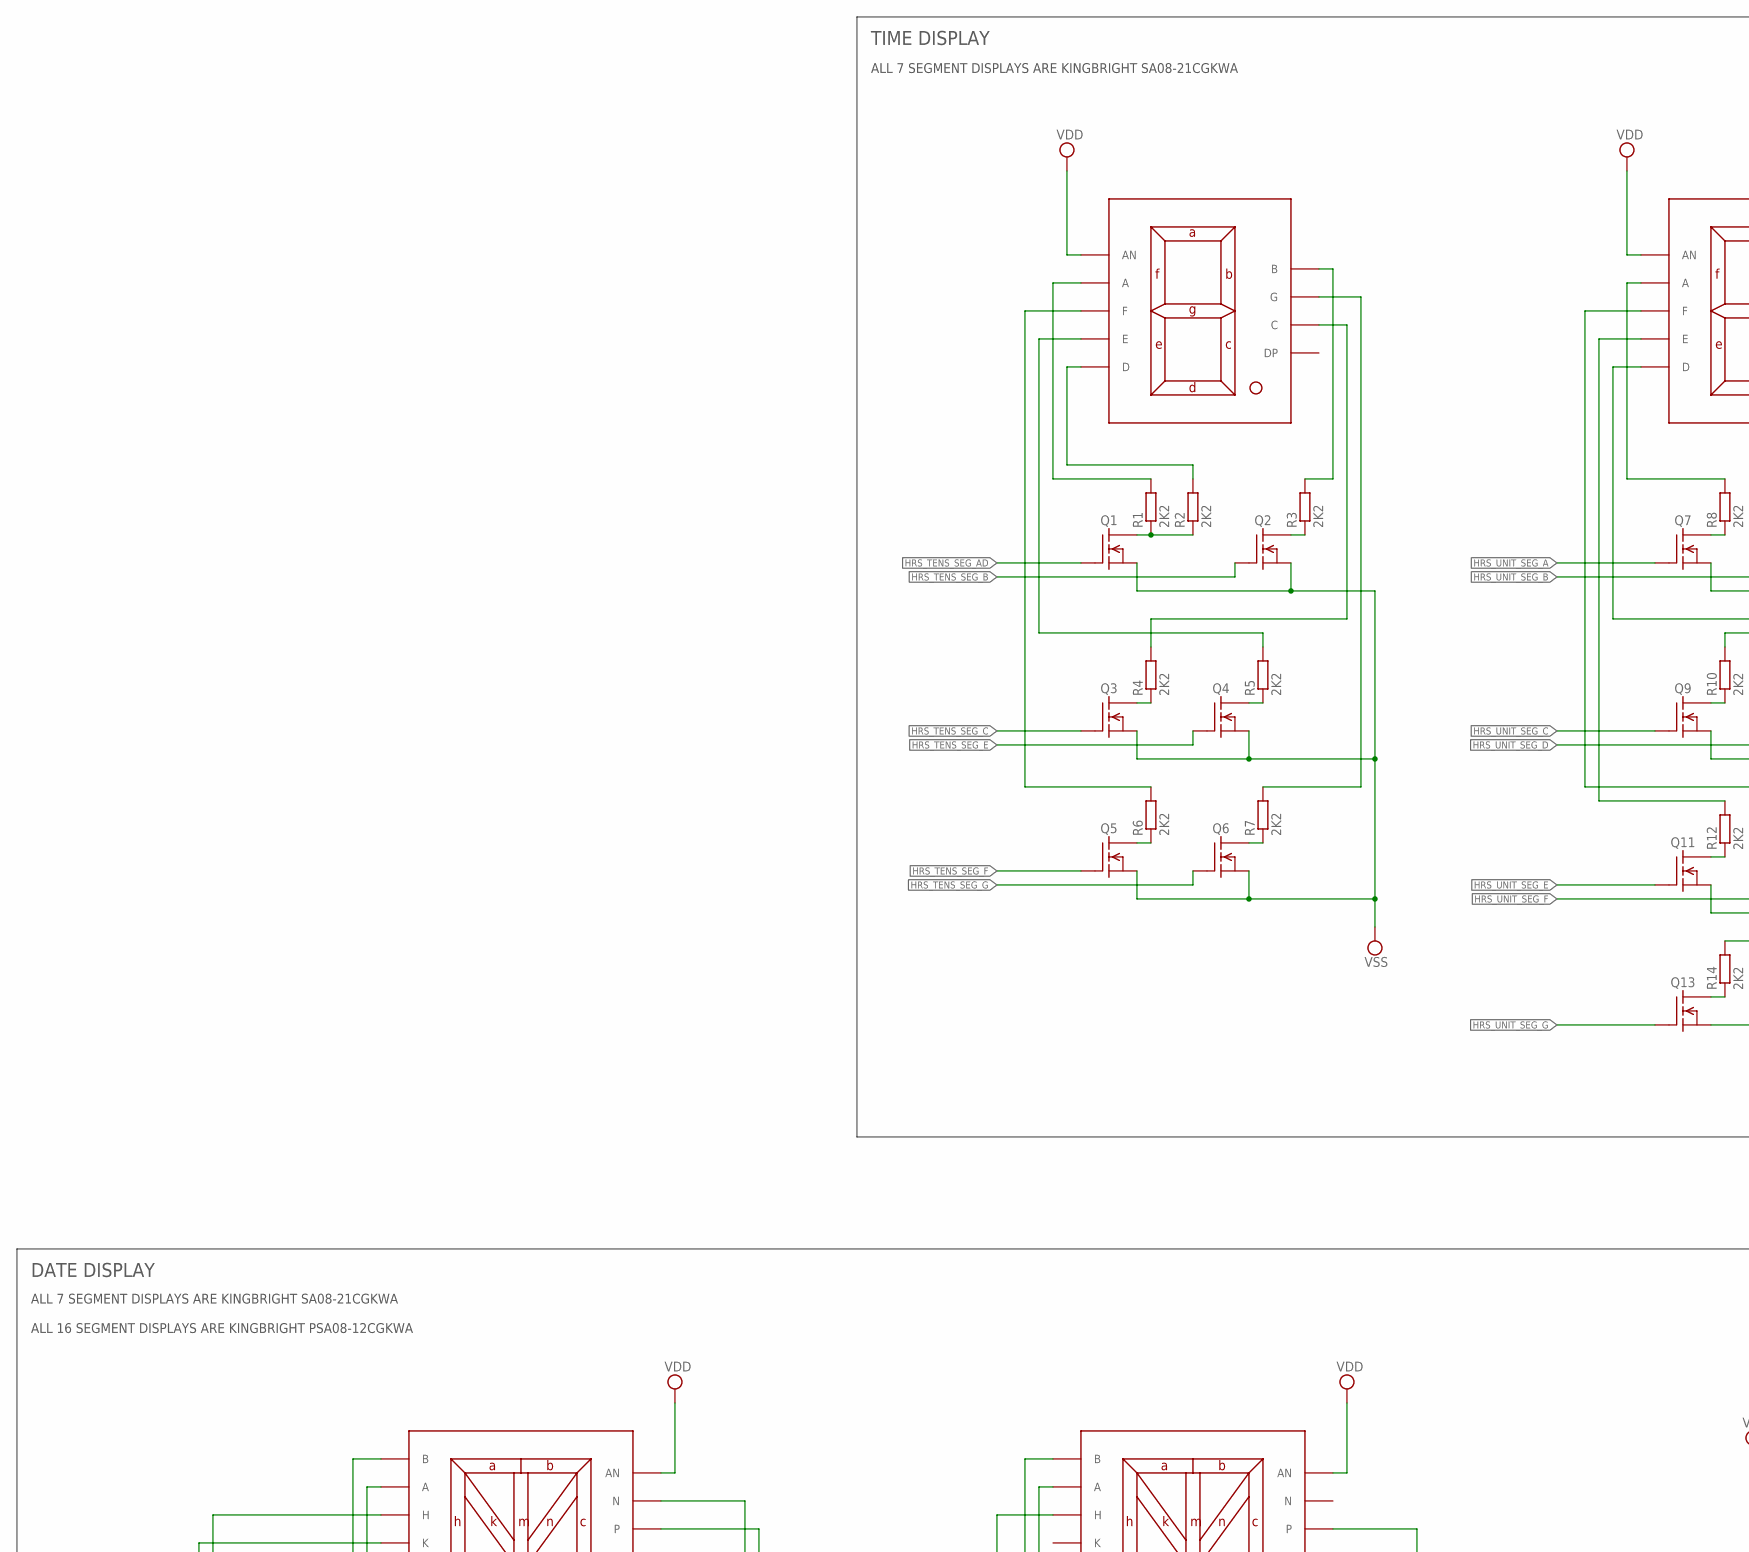
[picture p20: schematic display-board.sch, part in row 1, column 1]

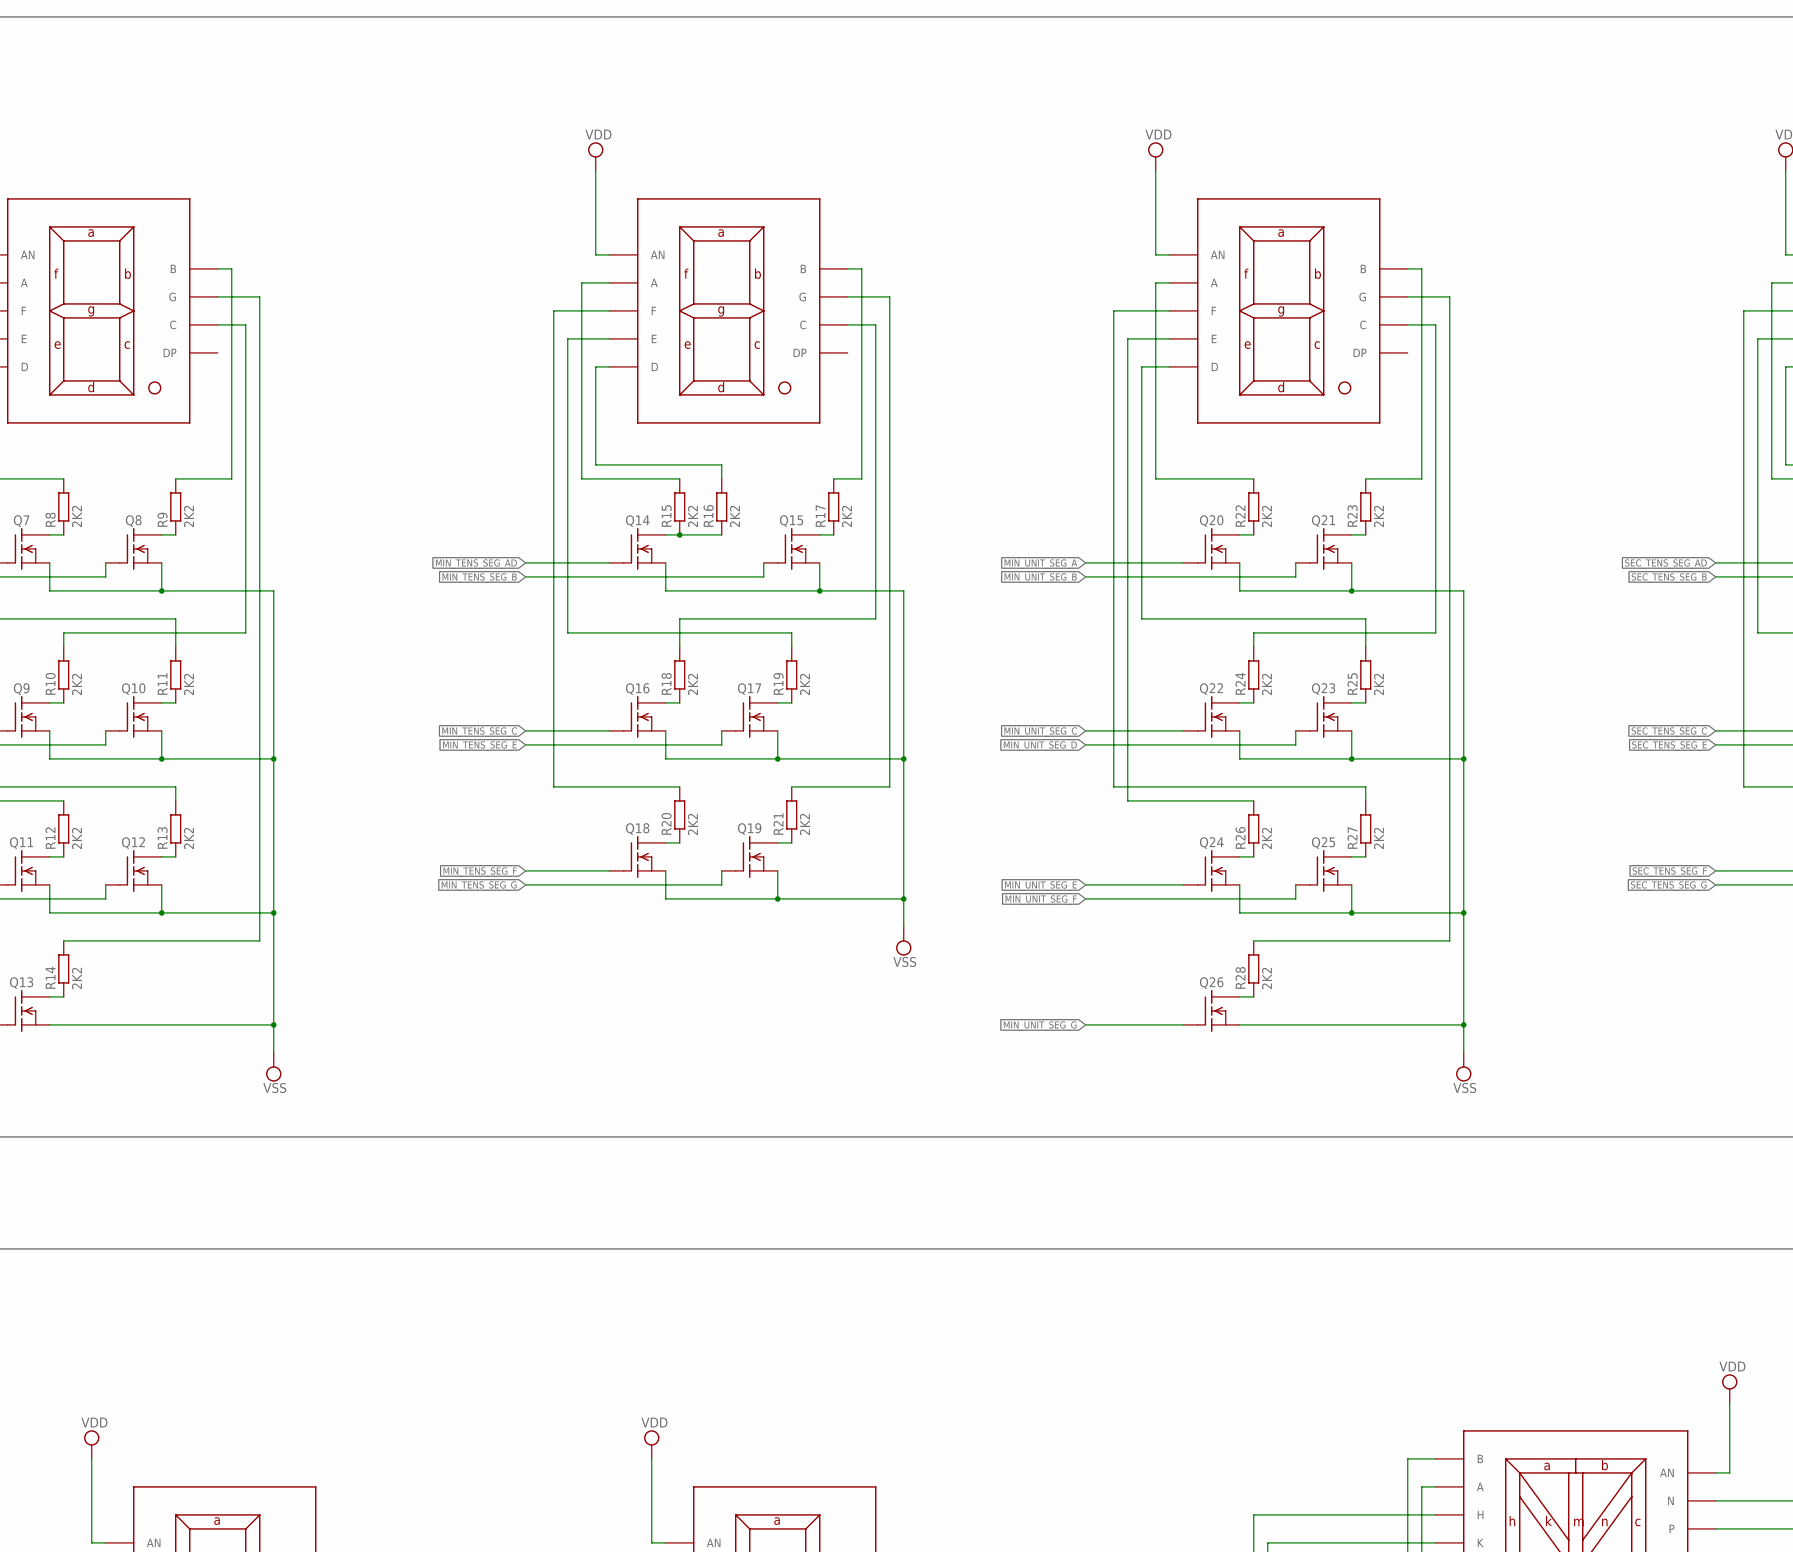
[picture p21: schematic display-board.sch, part in row 1, column 2]

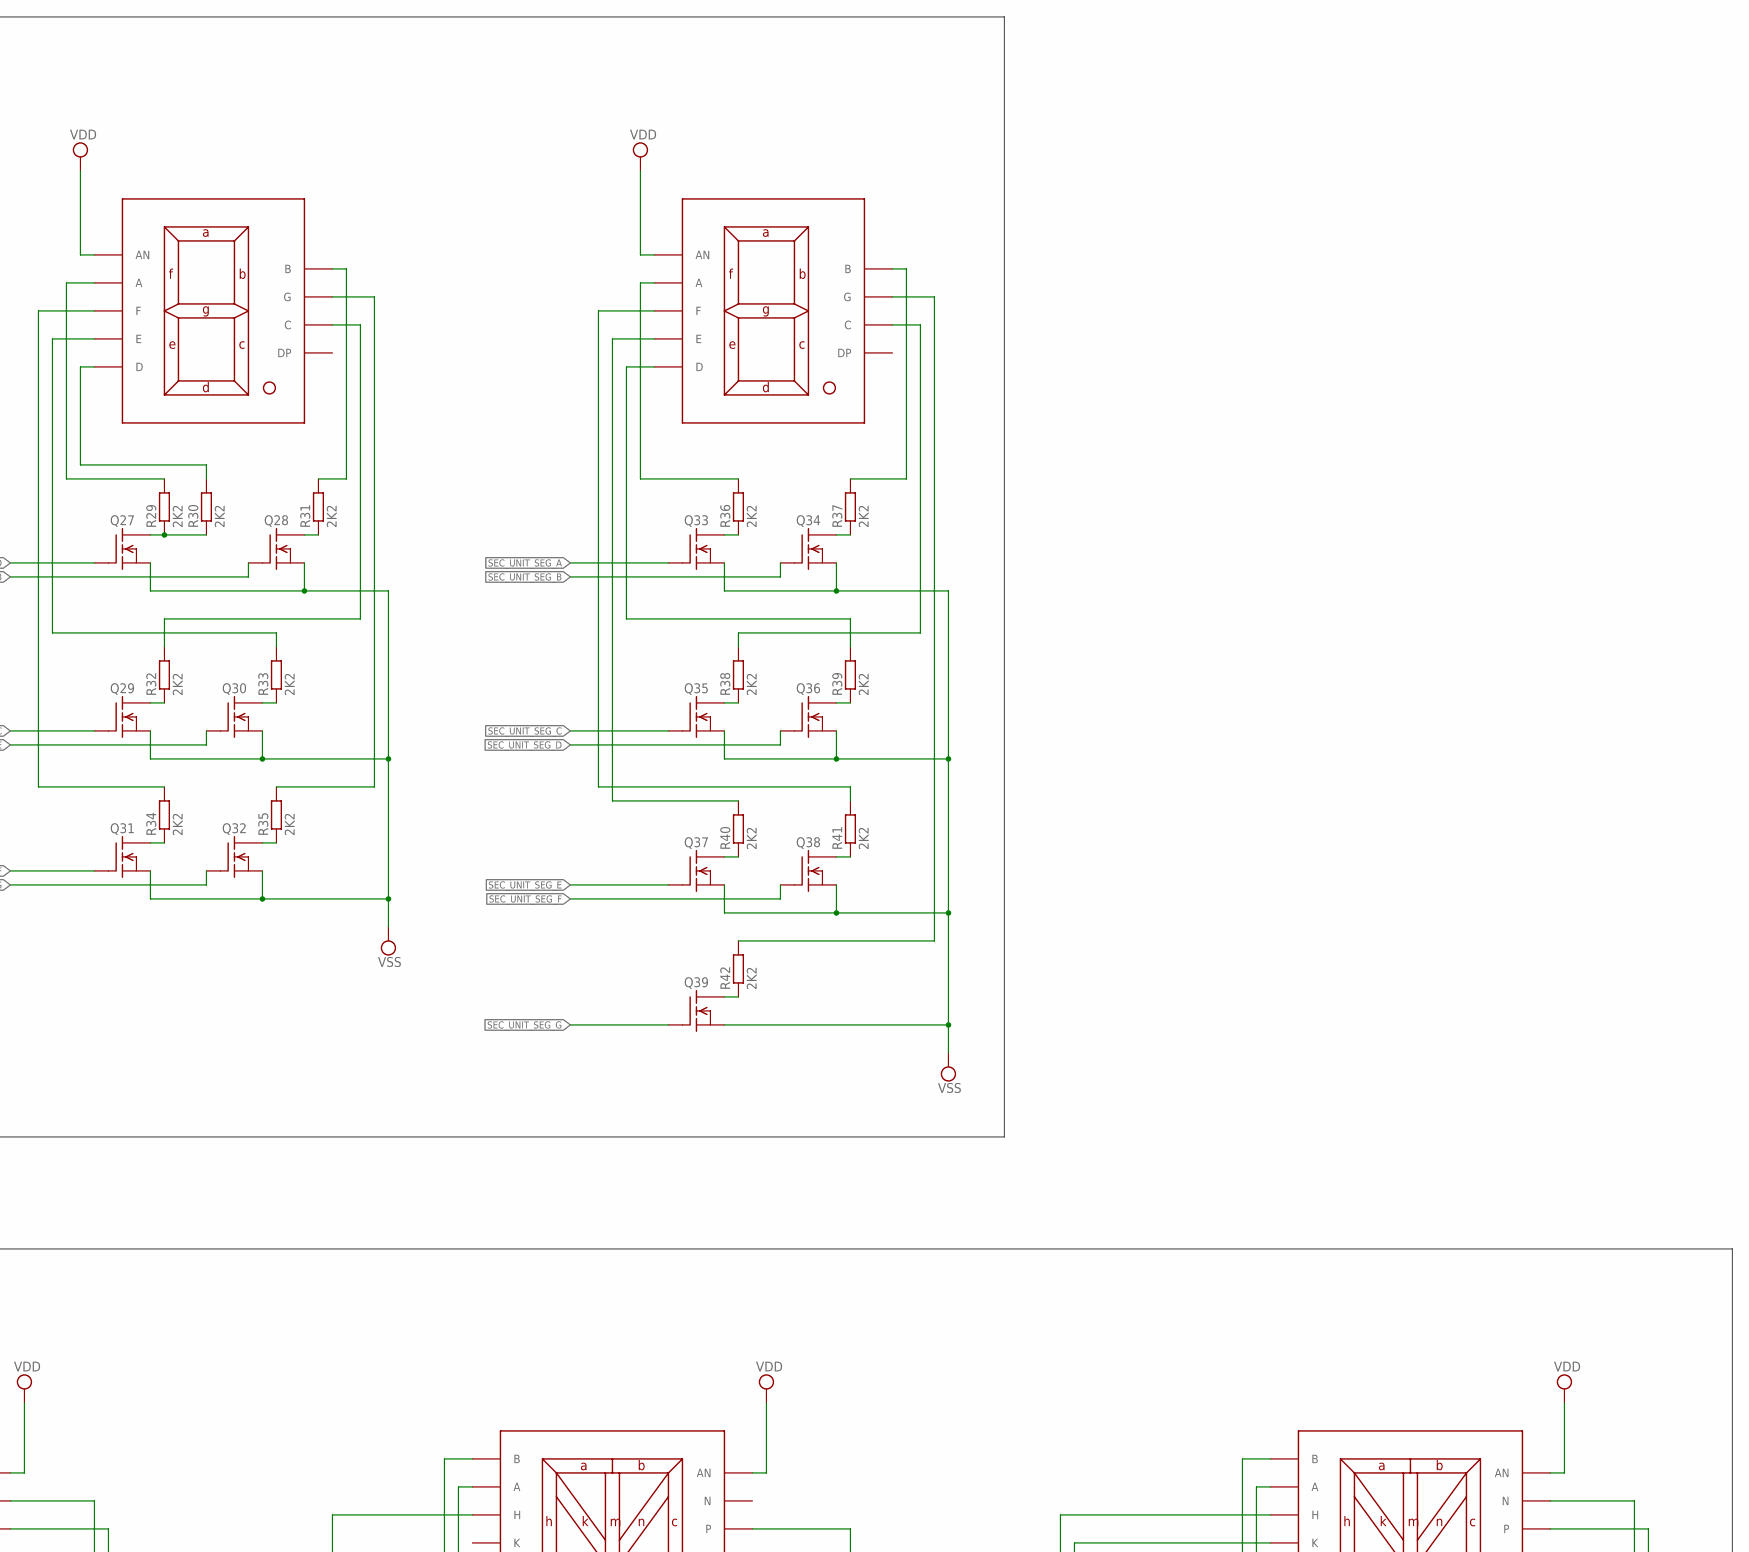
[picture p22: schematic display-board.sch, part in row 1, column 3]

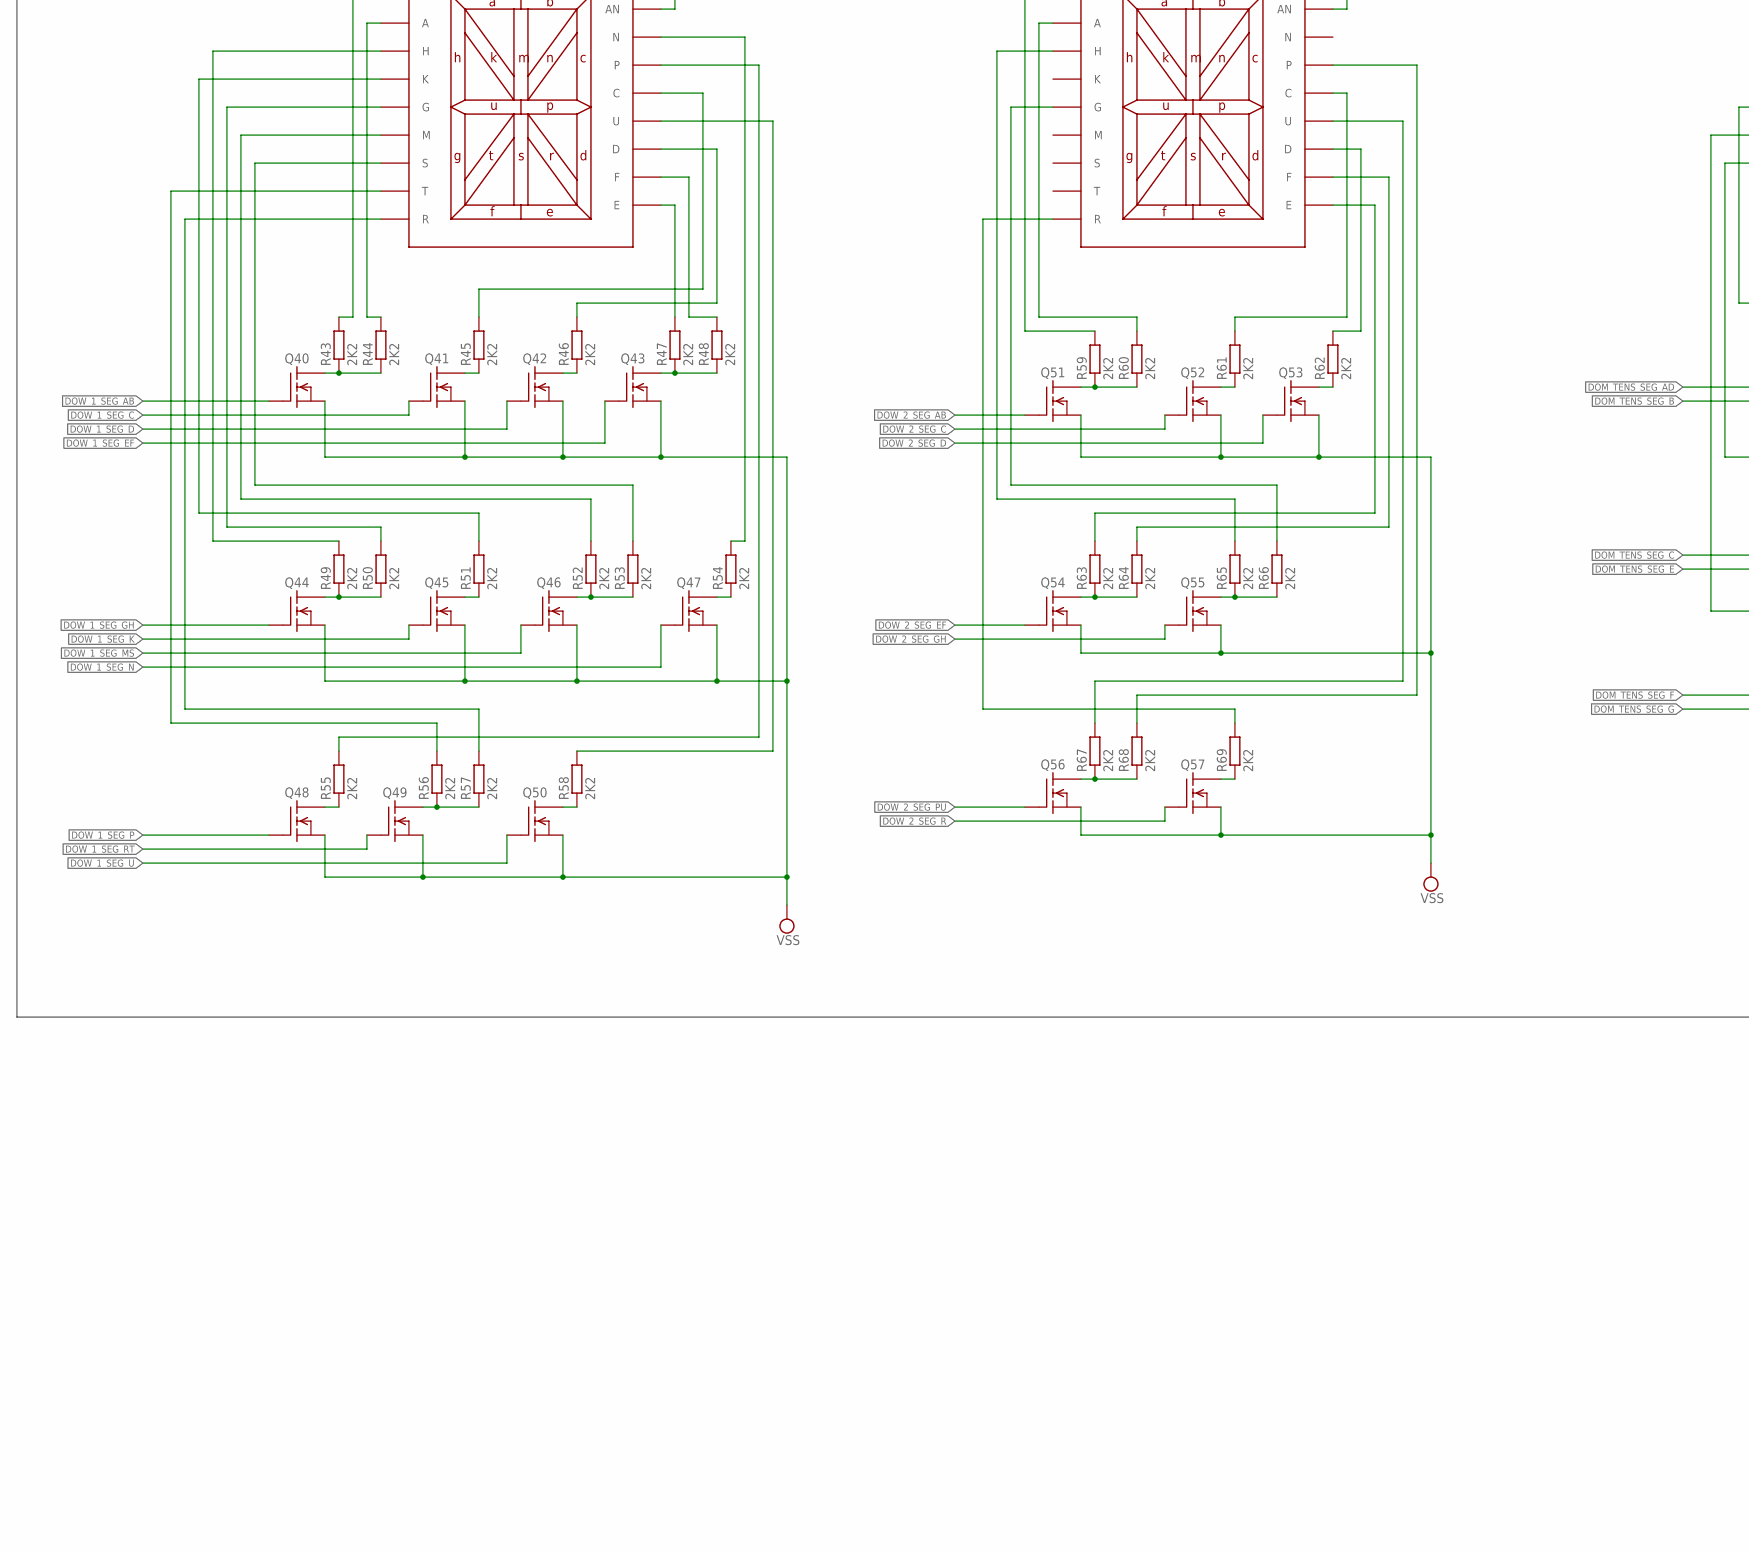
[picture p23: schematic display-board.sch, part in row 2, column 1]

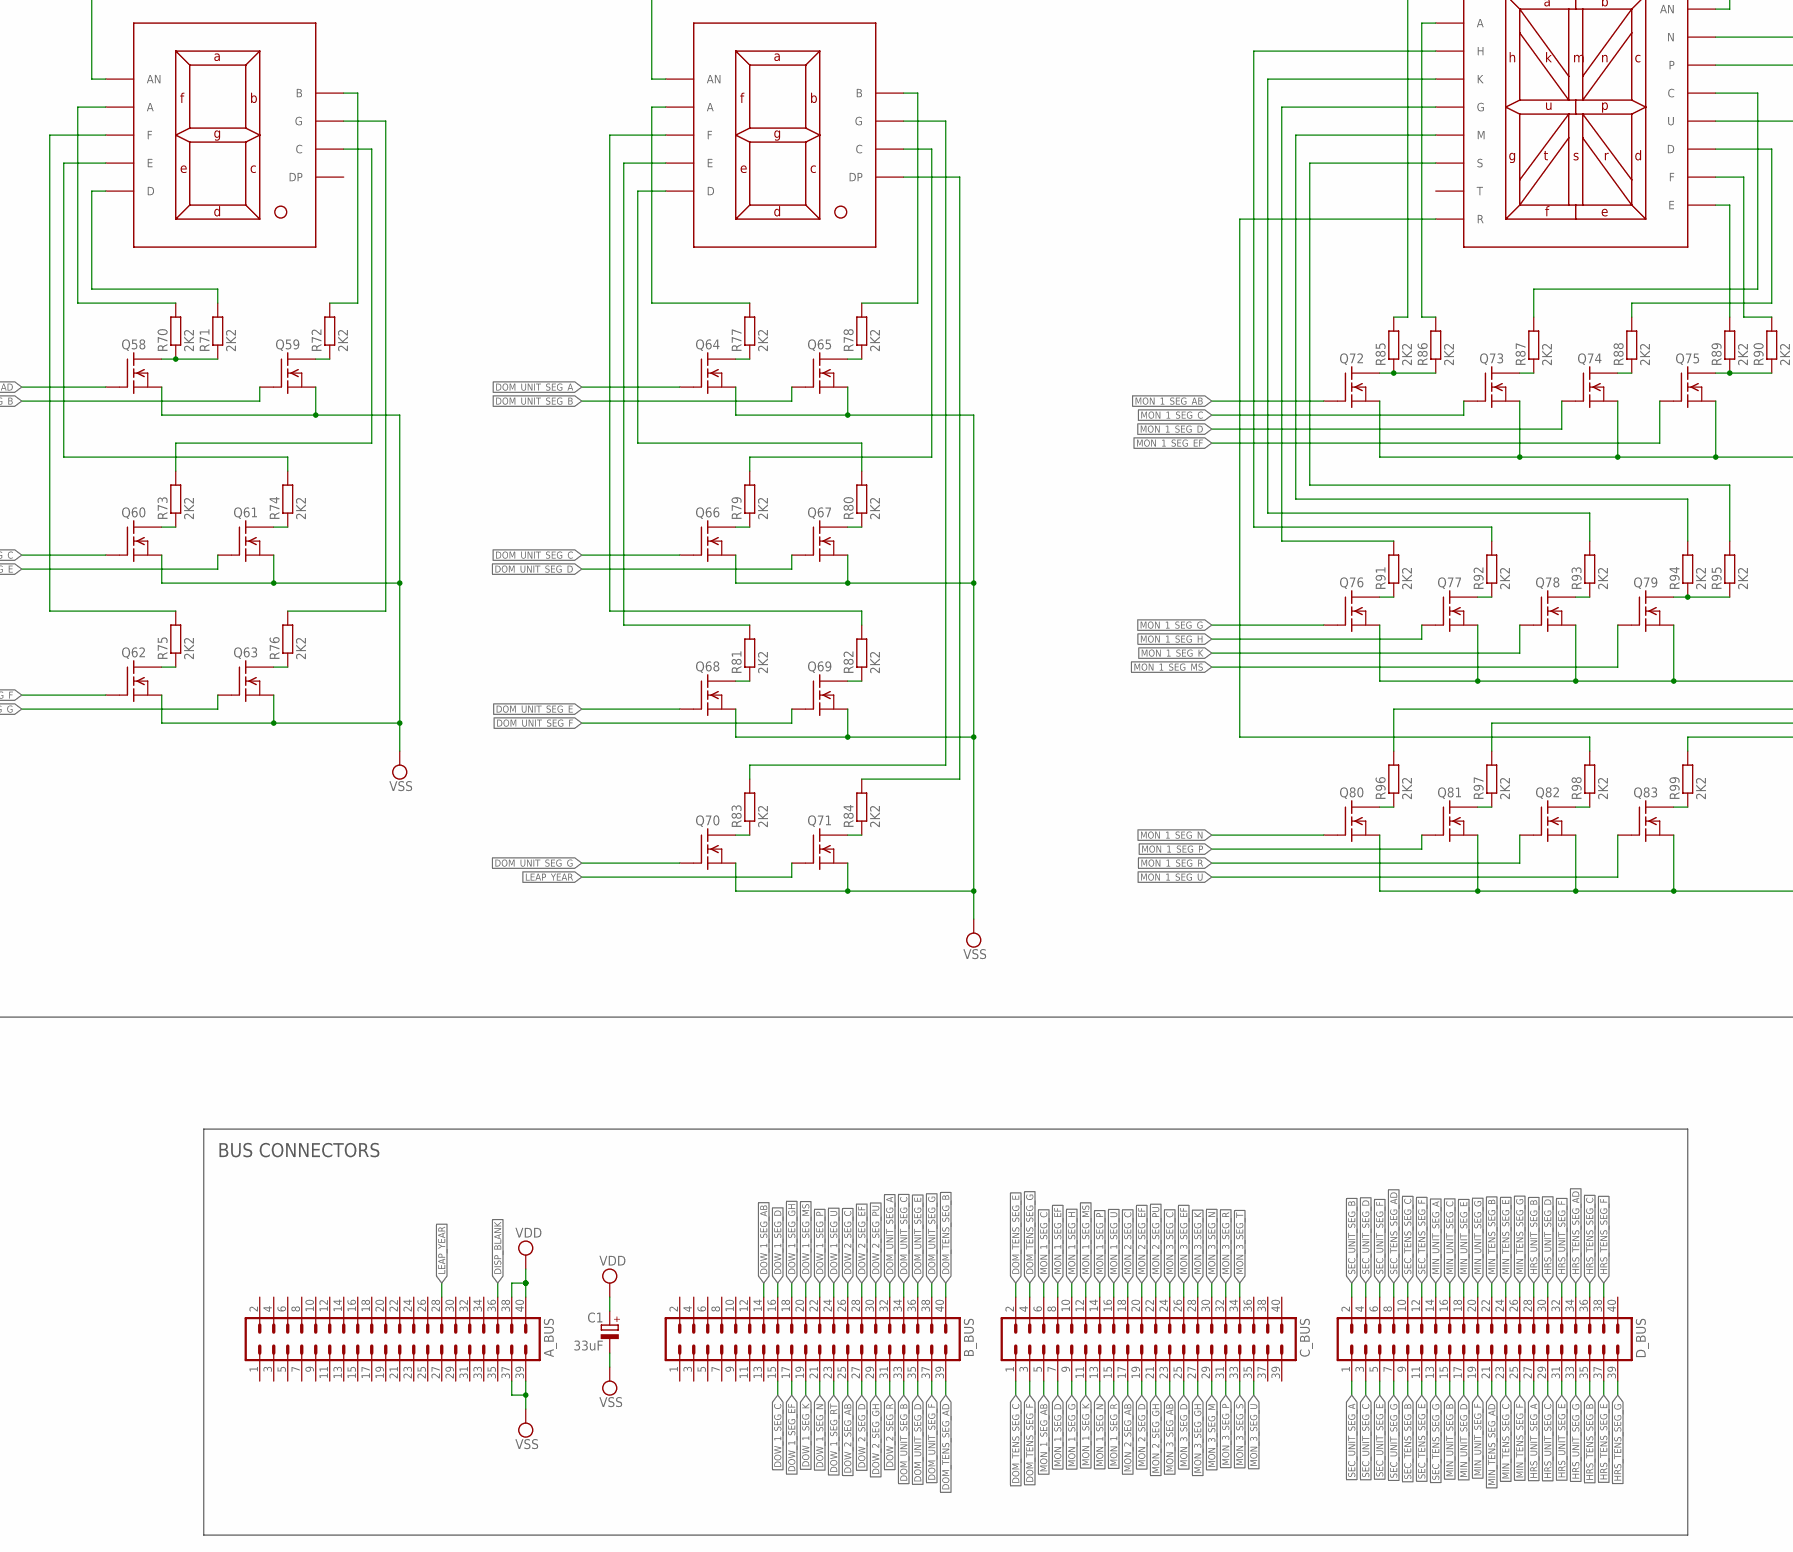
[picture p24: schematic display-board.sch, part in row 2, column 2]

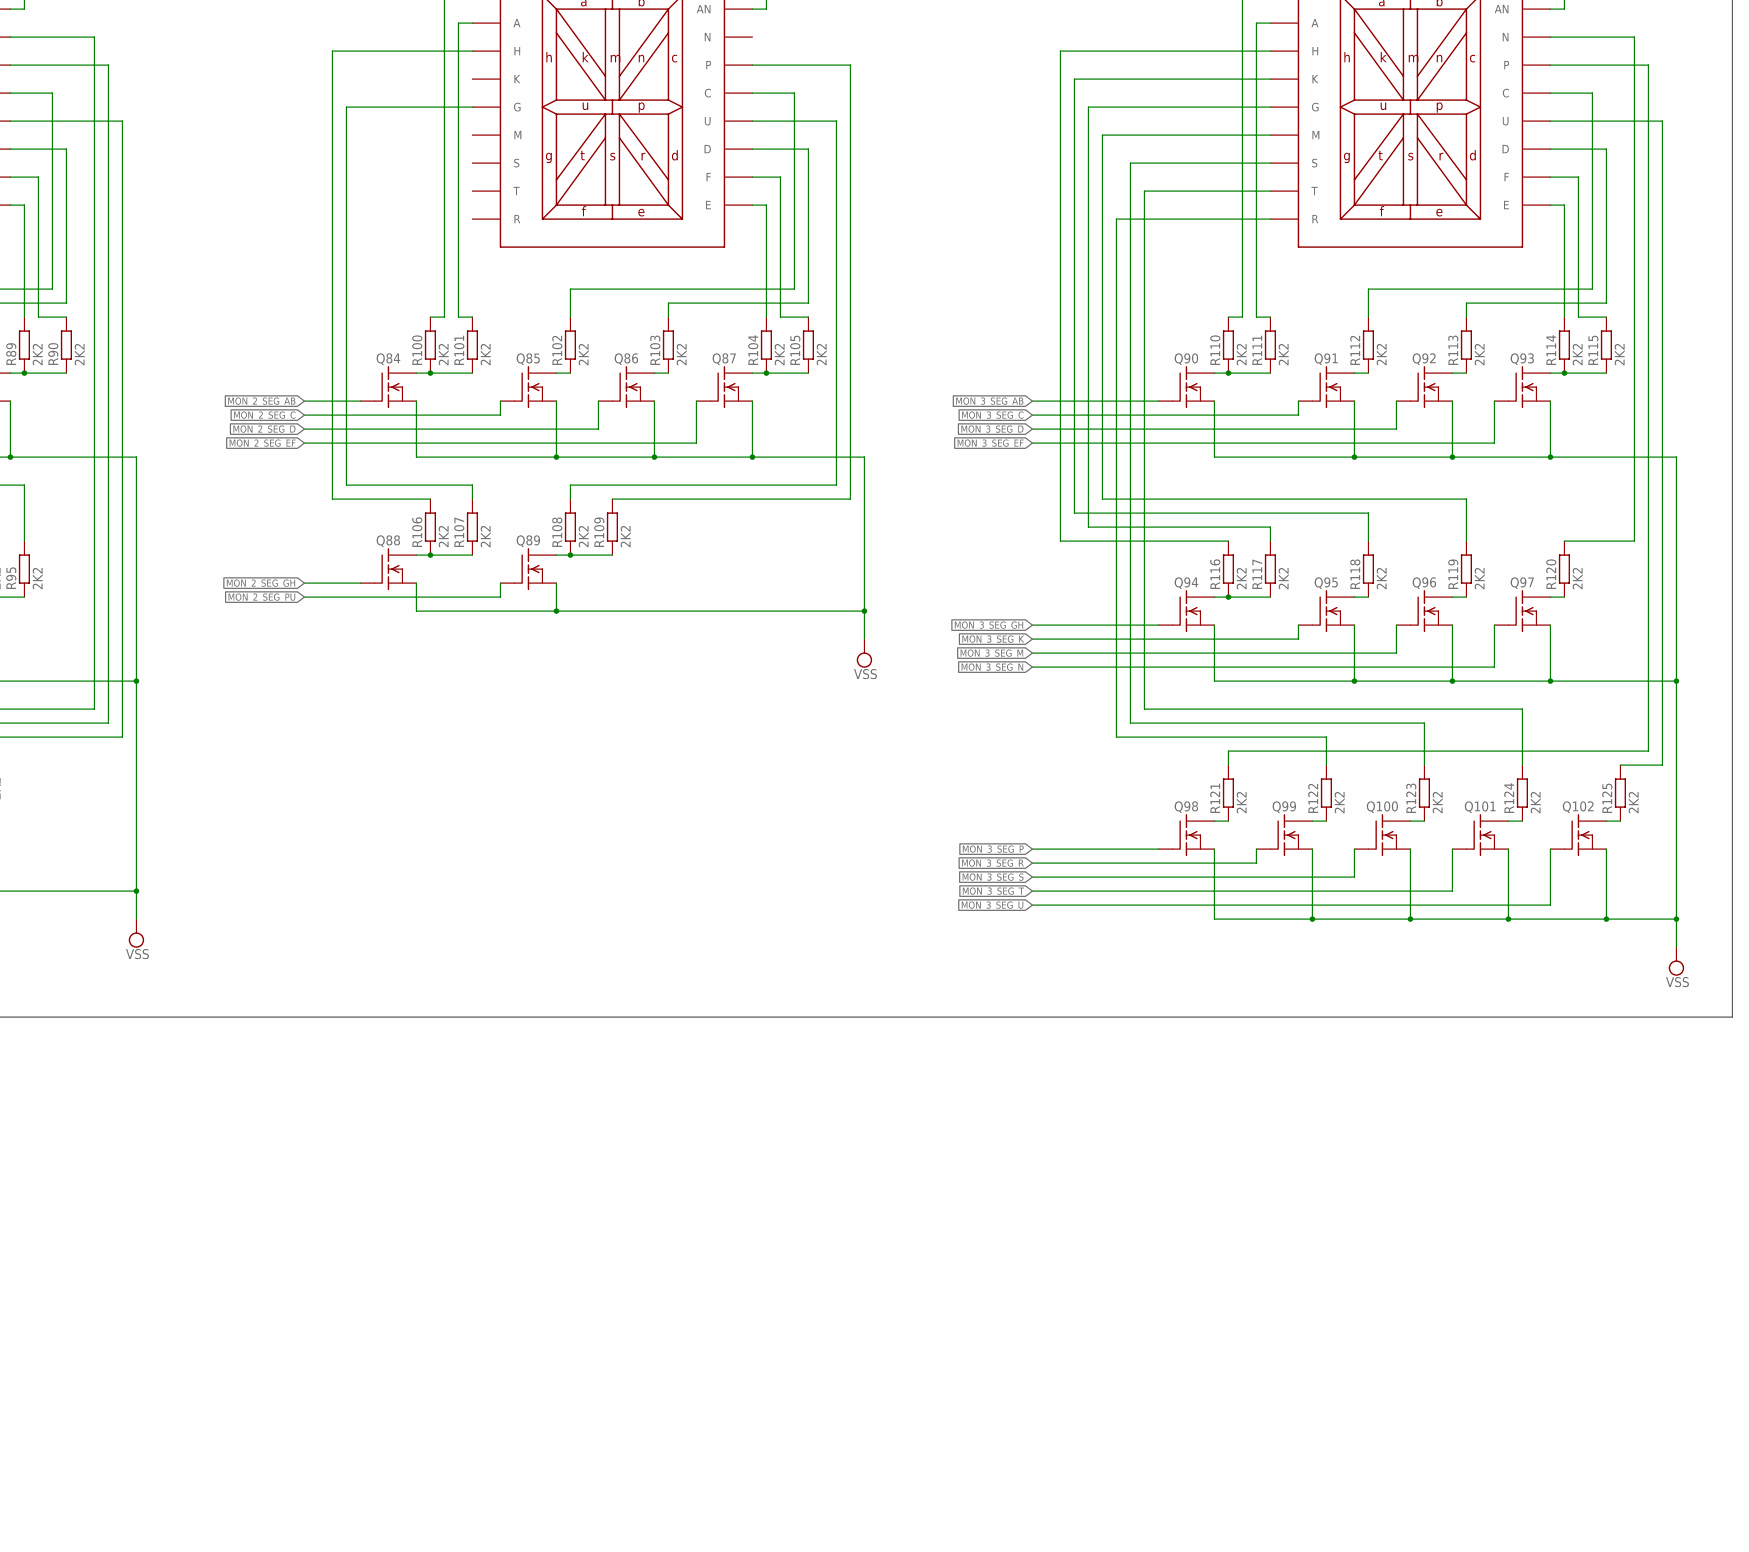
[picture p25: schematic display-board.sch, part in row 2, column 3]

Parts:
A_BUS: MA20-2
B_BUS: MA20-2
C1: 33uF; E2,5-6
C_BUS: MA20-2
D_BUS: MA20-2
LED1, LED2, LED3, LED4, LED5, LED6, LED9, LED10: SA08-21CGKWA
LED7, LED8, LED11, LED12, LED13: PSA08-12CGKWA
Q1, Q2, Q3, Q4, Q5, Q6, Q7, Q8, Q9, Q10, Q11, Q12, Q13, Q14, Q15, Q16, Q17, Q18, Q19, Q20, Q21, Q22, Q23, Q24, Q25, Q26, Q27, Q28, Q29, Q30, Q31, Q32, Q33, Q34, Q35, Q36, Q37, Q38, Q39, Q40, Q41, Q42, Q43, Q44, Q45, Q46, Q47, Q48, Q49, Q50, Q51, Q52, Q53, Q54, Q55, Q56, Q57, Q58, Q59, Q60, Q61, Q62, Q63, Q64, Q65, Q66, Q67, Q68, Q69, Q70, Q71, Q72, Q73, Q74, Q75, Q76, Q77, Q78, Q79, Q80, Q81, Q82, Q83, Q84, Q85, Q86, Q87, Q88, Q89, Q90, Q91, Q92, Q93, Q94, Q95, Q96, Q97, Q98, Q99, Q100, Q101, Q102: 2N7000; TO-92
R1, R2, R3, R4, R5, R6, R7, R8, R9, R10, R11, R12, R13, R14, R15, R16, R17, R18, R19, R20, R21, R22, R23, R24, R25, R26, R27, R28, R29, R30, R31, R32, R33, R34, R35, R36, R37, R38, R39, R40, R41, R42, R43, R44, R45, R46, R47, R48, R49, R50, R51, R52, R53, R54, R55, R56, R57, R58, R59, R60, R61, R62, R63, R64, R65, R66, R67, R68, R69, R70, R71, R72, R73, R74, R75, R76, R77, R78, R79, R80, R81, R82, R83, R84, R85, R86, R87, R88, R89, R90, R91, R92, R93, R94, R95, R96, R97, R98, R99, R100, R101, R102, R103, R104, R105, R106, R107, R108, R109, R110, R111, R112, R113, R114, R115, R116, R117, R118, R119, R120, R121, R122, R123, R124, R125: 2K2; 0207/2V

Connections:
DISP_BLANK: A_BUS.36
DOM_TENS_SEG_AD: B_BUS.39, Q58.2 (G)
DOM_TENS_SEG_B: B_BUS.40, Q59.2 (G)
DOM_TENS_SEG_C: C_BUS.1, Q60.2 (G)
DOM_TENS_SEG_E: C_BUS.2, Q61.2 (G)
DOM_TENS_SEG_F: C_BUS.3, Q62.2 (G)
DOM_TENS_SEG_G: C_BUS.4, Q63.2 (G)
DOM_UNIT_SEG_A: B_BUS.32, Q64.2 (G)
DOM_UNIT_SEG_B: B_BUS.33, Q65.2 (G)
DOM_UNIT_SEG_C: B_BUS.34, Q66.2 (G)
DOM_UNIT_SEG_D: B_BUS.35, Q67.2 (G)
DOM_UNIT_SEG_E: B_BUS.36, Q68.2 (G)
DOM_UNIT_SEG_F: B_BUS.37, Q69.2 (G)
DOM_UNIT_SEG_G: B_BUS.38, Q70.2 (G)
DOW_1_SEG_AB: B_BUS.14, Q40.2 (G)
DOW_1_SEG_C: B_BUS.15, Q41.2 (G)
DOW_1_SEG_D: B_BUS.16, Q42.2 (G)
DOW_1_SEG_EF: B_BUS.17, Q43.2 (G)
DOW_1_SEG_GH: B_BUS.18, Q44.2 (G)
DOW_1_SEG_K: B_BUS.19, Q45.2 (G)
DOW_1_SEG_MS: B_BUS.20, Q46.2 (G)
DOW_1_SEG_N: B_BUS.21, Q47.2 (G)
DOW_1_SEG_P: B_BUS.22, Q48.2 (G)
DOW_1_SEG_RT: B_BUS.23, Q49.2 (G)
DOW_1_SEG_U: B_BUS.24, Q50.2 (G)
DOW_2_SEG_AB: B_BUS.25, Q51.2 (G)
DOW_2_SEG_C: B_BUS.26, Q52.2 (G)
DOW_2_SEG_D: B_BUS.27, Q53.2 (G)
DOW_2_SEG_EF: B_BUS.28, Q54.2 (G)
DOW_2_SEG_GH: B_BUS.29, Q55.2 (G)
DOW_2_SEG_PU: B_BUS.30, Q56.2 (G)
DOW_2_SEG_R: B_BUS.31, Q57.2 (G)
HRS_TENS_SEG_AD: D_BUS.34, Q1.2 (G)
HRS_TENS_SEG_B: D_BUS.35, Q2.2 (G)
HRS_TENS_SEG_C: D_BUS.36, Q3.2 (G)
HRS_TENS_SEG_E: D_BUS.37, Q4.2 (G)
HRS_TENS_SEG_F: D_BUS.38, Q5.2 (G)
HRS_TENS_SEG_G: D_BUS.39, Q6.2 (G)
HRS_UNIT_SEG_A: D_BUS.27, Q7.2 (G)
HRS_UNIT_SEG_B: D_BUS.28, Q8.2 (G)
HRS_UNIT_SEG_C: D_BUS.29, Q9.2 (G)
HRS_UNIT_SEG_D: D_BUS.30, Q10.2 (G)
HRS_UNIT_SEG_E: D_BUS.31, Q11.2 (G)
HRS_UNIT_SEG_F: D_BUS.32, Q12.2 (G)
HRS_UNIT_SEG_G: D_BUS.33, Q13.2 (G)
LEAP_YEAR: A_BUS.28, Q71.2 (G)
MIN_TENS_SEG_AD: D_BUS.21, Q14.2 (G)
MIN_TENS_SEG_B: D_BUS.22, Q15.2 (G)
MIN_TENS_SEG_C: D_BUS.23, Q16.2 (G)
MIN_TENS_SEG_E: D_BUS.24, Q17.2 (G)
MIN_TENS_SEG_F: D_BUS.25, Q18.2 (G)
MIN_TENS_SEG_G: D_BUS.26, Q19.2 (G)
MIN_UNIT_SEG_A: D_BUS.14, Q20.2 (G)
MIN_UNIT_SEG_B: D_BUS.15, Q21.2 (G)
MIN_UNIT_SEG_C: D_BUS.16, Q22.2 (G)
MIN_UNIT_SEG_D: D_BUS.17, Q23.2 (G)
MIN_UNIT_SEG_E: D_BUS.18, Q24.2 (G)
MIN_UNIT_SEG_F: D_BUS.19, Q25.2 (G)
MIN_UNIT_SEG_G: D_BUS.20, Q26.2 (G)
MON_1_SEG_AB: C_BUS.5, Q72.2 (G)
MON_1_SEG_C: C_BUS.6, Q73.2 (G)
MON_1_SEG_D: C_BUS.7, Q74.2 (G)
MON_1_SEG_EF: C_BUS.8, Q75.2 (G)
MON_1_SEG_G: C_BUS.9, Q76.2 (G)
MON_1_SEG_H: C_BUS.10, Q77.2 (G)
MON_1_SEG_K: C_BUS.11, Q78.2 (G)
MON_1_SEG_MS: C_BUS.12, Q79.2 (G)
MON_1_SEG_N: C_BUS.13, Q80.2 (G)
MON_1_SEG_P: C_BUS.14, Q81.2 (G)
MON_1_SEG_R: C_BUS.15, Q82.2 (G)
MON_1_SEG_U: C_BUS.16, Q83.2 (G)
MON_2_SEG_AB: C_BUS.17, Q84.2 (G)
MON_2_SEG_C: C_BUS.18, Q85.2 (G)
MON_2_SEG_D: C_BUS.19, Q86.2 (G)
MON_2_SEG_EF: C_BUS.20, Q87.2 (G)
MON_2_SEG_GH: C_BUS.21, Q88.2 (G)
MON_2_SEG_PU: C_BUS.22, Q89.2 (G)
MON_3_SEG_AB: C_BUS.23, Q90.2 (G)
MON_3_SEG_C: C_BUS.24, Q91.2 (G)
MON_3_SEG_D: C_BUS.25, Q92.2 (G)
MON_3_SEG_EF: C_BUS.26, Q93.2 (G)
MON_3_SEG_GH: C_BUS.27, Q94.2 (G)
MON_3_SEG_K: C_BUS.28, Q95.2 (G)
MON_3_SEG_M: C_BUS.29, Q96.2 (G)
MON_3_SEG_N: C_BUS.30, Q97.2 (G)
MON_3_SEG_P: C_BUS.31, Q98.2 (G)
MON_3_SEG_R: C_BUS.32, Q99.2 (G)
MON_3_SEG_S: C_BUS.33, Q100.2 (G)
MON_3_SEG_T: C_BUS.34, Q101.2 (G)
MON_3_SEG_U: C_BUS.35, Q102.2 (G)
unnamed: Q1.3 (D), R1.1, R2.1
unnamed: LED1.P$2 (A), R1.2
unnamed: LED1.P$9 (D), R2.2
unnamed: LED1.P$15 (B), R3.2
unnamed: Q2.3 (D), R3.1
unnamed: LED1.P$13 (C), R4.2
unnamed: Q3.3 (D), R4.1
unnamed: LED1.P$5 (E), R5.2
unnamed: LED1.P$3 (F), R6.2
unnamed: LED1.P$14 (G), R7.2
unnamed: Q6.3 (D), R7.1
unnamed: Q4.3 (D), R5.1
unnamed: Q5.3 (D), R6.1
unnamed: Q7.3 (D), R8.1
unnamed: Q9.3 (D), R10.1
unnamed: Q11.3 (D), R12.1
unnamed: Q13.3 (D), R14.1
unnamed: Q8.3 (D), R9.1
unnamed: Q10.3 (D), R11.1
unnamed: Q12.3 (D), R13.1
unnamed: LED2.P$2 (A), R8.2
unnamed: LED2.P$15 (B), R9.2
unnamed: LED2.P$13 (C), R10.2
unnamed: LED2.P$9 (D), R11.2
unnamed: LED2.P$5 (E), R12.2
unnamed: LED2.P$3 (F), R13.2
unnamed: LED2.P$14 (G), R14.2
unnamed: Q14.3 (D), R15.1, R16.1
unnamed: Q15.3 (D), R17.1
unnamed: Q16.3 (D), R18.1
unnamed: Q19.3 (D), R21.1
unnamed: Q17.3 (D), R19.1
unnamed: Q18.3 (D), R20.1
unnamed: Q20.3 (D), R22.1
unnamed: Q22.3 (D), R24.1
unnamed: Q24.3 (D), R26.1
unnamed: Q26.3 (D), R28.1
unnamed: Q21.3 (D), R23.1
unnamed: Q23.3 (D), R25.1
unnamed: Q25.3 (D), R27.1
unnamed: LED3.P$2 (A), R15.2
unnamed: LED3.P$9 (D), R16.2
unnamed: LED3.P$15 (B), R17.2
unnamed: LED3.P$13 (C), R18.2
unnamed: LED3.P$5 (E), R19.2
unnamed: LED3.P$3 (F), R20.2
unnamed: LED3.P$14 (G), R21.2
unnamed: LED4.P$2 (A), R22.2
unnamed: LED4.P$15 (B), R23.2
unnamed: LED4.P$13 (C), R24.2
unnamed: LED4.P$9 (D), R25.2
unnamed: LED4.P$5 (E), R26.2
unnamed: LED4.P$3 (F), R27.2
unnamed: LED4.P$14 (G), R28.2
unnamed: Q27.3 (D), R29.1, R30.1
unnamed: Q28.3 (D), R31.1
unnamed: Q29.3 (D), R32.1
unnamed: Q32.3 (D), R35.1
unnamed: Q30.3 (D), R33.1
unnamed: Q31.3 (D), R34.1
unnamed: Q33.3 (D), R36.1
unnamed: Q35.3 (D), R38.1
unnamed: Q37.3 (D), R40.1
unnamed: Q39.3 (D), R42.1
unnamed: Q34.3 (D), R37.1
unnamed: Q36.3 (D), R39.1
unnamed: Q38.3 (D), R41.1
unnamed: LED5.P$2 (A), R29.2
unnamed: LED5.P$9 (D), R30.2
unnamed: LED5.P$15 (B), R31.2
unnamed: LED5.P$13 (C), R32.2
unnamed: LED5.P$5 (E), R33.2
unnamed: LED5.P$3 (F), R34.2
unnamed: LED5.P$14 (G), R35.2
unnamed: LED6.P$2 (A), R36.2
unnamed: LED6.P$15 (B), R37.2
unnamed: LED6.P$13 (C), R38.2
unnamed: LED6.P$9 (D), R39.2
unnamed: LED6.P$5 (E), R40.2
unnamed: LED6.P$3 (F), R41.2
unnamed: LED6.P$14 (G), R42.2
unnamed: Q40.3 (D), R43.1, R44.1
unnamed: Q41.3 (D), R45.1
unnamed: Q42.3 (D), R46.1
unnamed: Q43.3 (D), R47.1, R48.1
unnamed: LED7.P$2 (A), R44.2
unnamed: LED7.P$1 (B), R43.2
unnamed: LED7.P$15 (C), R45.2
unnamed: LED7.P$13 (D), R46.2
unnamed: LED7.P$10 (E), R47.2
unnamed: LED7.P$11 (F), R48.2
unnamed: Q44.3 (D), R49.1, R50.1
unnamed: Q45.3 (D), R51.1
unnamed: Q46.3 (D), R52.1, R53.1
unnamed: Q47.3 (D), R54.1
unnamed: LED7.P$5 (G), R50.2
unnamed: LED7.P$3 (H), R49.2
unnamed: LED7.P$4 (K), R51.2
unnamed: LED7.P$6 (M), R52.2
unnamed: LED7.P$7 (S), R53.2
unnamed: LED7.P$18 (N), R54.2
unnamed: Q48.3 (D), R55.1
unnamed: Q49.3 (D), R56.1, R57.1
unnamed: Q50.3 (D), R58.1
unnamed: LED7.P$16, R55.2
unnamed: LED7.P$8 (T), R56.2
unnamed: LED7.P$9 (R), R57.2
unnamed: LED7.P$14 (U), R58.2
unnamed: Q58.3 (D), R70.1, R71.1
unnamed: Q59.3 (D), R72.1
unnamed: Q60.3 (D), R73.1
unnamed: Q63.3 (D), R76.1
unnamed: Q61.3 (D), R74.1
unnamed: Q62.3 (D), R75.1
unnamed: Q64.3 (D), R77.1
unnamed: Q66.3 (D), R79.1
unnamed: Q68.3 (D), R81.1
unnamed: Q70.3 (D), R83.1
unnamed: Q65.3 (D), R78.1
unnamed: Q67.3 (D), R80.1
unnamed: Q69.3 (D), R82.1
unnamed: Q57.3 (D), R69.1
unnamed: LED8.P$9 (R), R69.2
unnamed: Q51.3 (D), R59.1, R60.1
unnamed: Q52.3 (D), R61.1
unnamed: Q53.3 (D), R62.1
unnamed: Q54.3 (D), R63.1, R64.1
unnamed: Q55.3 (D), R65.1, R66.1
unnamed: Q56.3 (D), R67.1, R68.1
unnamed: LED8.P$1 (B), R59.2
unnamed: LED8.P$2 (A), R60.2
unnamed: LED8.P$15 (C), R61.2
unnamed: LED8.P$13 (D), R62.2
unnamed: LED8.P$10 (E), R63.2
unnamed: LED8.P$11 (F), R64.2
unnamed: LED8.P$3 (H), R65.2
unnamed: LED8.P$5 (G), R66.2
unnamed: LED8.P$14 (U), R67.2
unnamed: LED8.P$16, R68.2
unnamed: LED9.P$2 (A), R70.2
unnamed: LED9.P$9 (D), R71.2
unnamed: LED9.P$15 (B), R72.2
unnamed: LED9.P$13 (C), R73.2
unnamed: LED9.P$5 (E), R74.2
unnamed: LED9.P$3 (F), R75.2
unnamed: LED9.P$14 (G), R76.2
unnamed: LED10.P$2 (A), R77.2
unnamed: LED10.P$15 (B), R78.2
unnamed: LED10.P$13 (C), R79.2
unnamed: LED10.P$9 (D), R80.2
unnamed: LED10.P$5 (E), R81.2
unnamed: LED10.P$3 (F), R82.2
unnamed: LED10.P$14 (G), R83.2
unnamed: Q71.3 (D), R84.1
unnamed: LED10.P$10 (DP), R84.2
unnamed: Q72.3 (D), R85.1, R86.1
unnamed: Q73.3 (D), R87.1
unnamed: Q74.3 (D), R88.1
unnamed: Q75.3 (D), R89.1, R90.1
unnamed: LED11.P$2 (A), R86.2
unnamed: LED11.P$1 (B), R85.2
unnamed: LED11.P$10 (E), R89.2
unnamed: LED11.P$11 (F), R90.2
unnamed: LED11.P$13 (D), R88.2
unnamed: LED11.P$15 (C), R87.2
unnamed: Q76.3 (D), R91.1
unnamed: Q77.3 (D), R92.1
unnamed: Q78.3 (D), R93.1
unnamed: Q79.3 (D), R94.1, R95.1
unnamed: Q84.3 (D), R100.1, R101.1
unnamed: Q85.3 (D), R102.1
unnamed: Q86.3 (D), R103.1
unnamed: Q87.3 (D), R104.1, R105.1
unnamed: LED12.P$2 (A), R101.2
unnamed: LED11.P$5 (G), R91.2
unnamed: LED11.P$3 (H), R92.2
unnamed: LED11.P$4 (K), R93.2
unnamed: LED11.P$7 (S), R95.2
unnamed: LED11.P$6 (M), R94.2
unnamed: LED12.P$1 (B), R100.2
unnamed: LED12.P$10 (E), R104.2
unnamed: LED12.P$11 (F), R105.2
unnamed: LED12.P$13 (D), R103.2
unnamed: LED12.P$15 (C), R102.2
unnamed: Q80.3 (D), R96.1
unnamed: Q81.3 (D), R97.1
unnamed: Q82.3 (D), R98.1
unnamed: Q83.3 (D), R99.1
unnamed: LED11.P$18 (N), R96.2
unnamed: LED11.P$16, R97.2
unnamed: LED11.P$9 (R), R98.2
unnamed: LED11.P$14 (U), R99.2
unnamed: Q90.3 (D), R110.1, R111.1
unnamed: Q88.3 (D), R106.1, R107.1
unnamed: Q89.3 (D), R108.1, R109.1
unnamed: LED12.P$5 (G), R107.2
unnamed: LED12.P$3 (H), R106.2
unnamed: LED12.P$14 (U), R108.2
unnamed: LED12.P$16, R109.2
unnamed: Q91.3 (D), R112.1
unnamed: Q92.3 (D), R113.1
unnamed: Q93.3 (D), R114.1, R115.1
unnamed: LED13.P$2 (A), R111.2
unnamed: LED13.P$1 (B), R110.2
unnamed: LED13.P$10 (E), R114.2
unnamed: LED13.P$11 (F), R115.2
unnamed: LED13.P$13 (D), R113.2
unnamed: LED13.P$15 (C), R112.2
unnamed: Q94.3 (D), R116.1, R117.1
unnamed: Q95.3 (D), R118.1
unnamed: Q96.3 (D), R119.1
unnamed: Q97.3 (D), R120.1
unnamed: LED13.P$5 (G), R117.2
unnamed: LED13.P$3 (H), R116.2
unnamed: LED13.P$4 (K), R118.2
unnamed: LED13.P$7 (S), R123.2
unnamed: LED13.P$6 (M), R119.2
unnamed: Q98.3 (D), R121.1
unnamed: Q99.3 (D), R122.1
unnamed: Q100.3 (D), R123.1
unnamed: Q101.3 (D), R124.1
unnamed: LED13.P$18 (N), R120.2
unnamed: LED13.P$16, R121.2
unnamed: LED13.P$9 (R), R122.2
unnamed: LED13.P$14 (U), R125.2
unnamed: Q102.3 (D), R125.1
unnamed: LED13.P$8 (T), R124.2
SEC_TENS_SEG_AD: D_BUS.8, Q27.2 (G)
SEC_TENS_SEG_B: D_BUS.9, Q28.2 (G)
SEC_TENS_SEG_C: D_BUS.10, Q29.2 (G)
SEC_TENS_SEG_E: D_BUS.11, Q30.2 (G)
SEC_TENS_SEG_F: D_BUS.12, Q31.2 (G)
SEC_TENS_SEG_G: D_BUS.13, Q32.2 (G)
SEC_UNIT_SEG_A: D_BUS.1, Q33.2 (G)
SEC_UNIT_SEG_B: D_BUS.2, Q34.2 (G)
SEC_UNIT_SEG_C: D_BUS.3, Q35.2 (G)
SEC_UNIT_SEG_D: D_BUS.4, Q36.2 (G)
SEC_UNIT_SEG_E: D_BUS.5, Q37.2 (G)
SEC_UNIT_SEG_F: D_BUS.6, Q38.2 (G)
SEC_UNIT_SEG_G: D_BUS.7, Q39.2 (G)
VDD: A_BUS.38, A_BUS.40, C1.+, LED1.P$4 (AN), LED2.P$4 (AN), LED3.P$4 (AN), LED4.P$4 (AN), LED5.P$4 (AN), LED6.P$4 (AN), LED7.P$12 (AN), LED8.P$12 (AN), LED9.P$4 (AN), LED10.P$4 (AN), LED11.P$12 (AN), LED12.P$12 (AN), LED13.P$12 (AN)
VSS: A_BUS.37, A_BUS.39, C1.-, Q1.1 (S), Q2.1 (S), Q3.1 (S), Q4.1 (S), Q5.1 (S), Q6.1 (S), Q7.1 (S), Q8.1 (S), Q9.1 (S), Q10.1 (S), Q11.1 (S), Q12.1 (S), Q13.1 (S), Q14.1 (S), Q15.1 (S), Q16.1 (S), Q17.1 (S), Q18.1 (S), Q19.1 (S), Q20.1 (S), Q21.1 (S), Q22.1 (S), Q23.1 (S), Q24.1 (S), Q25.1 (S), Q26.1 (S), Q27.1 (S), Q28.1 (S), Q29.1 (S), Q30.1 (S), Q31.1 (S), Q32.1 (S), Q33.1 (S), Q34.1 (S), Q35.1 (S), Q36.1 (S), Q37.1 (S), Q38.1 (S), Q39.1 (S), Q40.1 (S), Q41.1 (S), Q42.1 (S), Q43.1 (S), Q44.1 (S), Q45.1 (S), Q46.1 (S), Q47.1 (S), Q48.1 (S), Q49.1 (S), Q50.1 (S), Q51.1 (S), Q52.1 (S), Q53.1 (S), Q54.1 (S), Q55.1 (S), Q56.1 (S), Q57.1 (S), Q58.1 (S), Q59.1 (S), Q60.1 (S), Q61.1 (S), Q62.1 (S), Q63.1 (S), Q64.1 (S), Q65.1 (S), Q66.1 (S), Q67.1 (S), Q68.1 (S), Q69.1 (S), Q70.1 (S), Q71.1 (S), Q72.1 (S), Q73.1 (S), Q74.1 (S), Q75.1 (S), Q76.1 (S), Q77.1 (S), Q78.1 (S), Q79.1 (S), Q80.1 (S), Q81.1 (S), Q82.1 (S), Q83.1 (S), Q84.1 (S), Q85.1 (S), Q86.1 (S), Q87.1 (S), Q88.1 (S), Q89.1 (S), Q90.1 (S), Q91.1 (S), Q92.1 (S), Q93.1 (S), Q94.1 (S), Q95.1 (S), Q96.1 (S), Q97.1 (S), Q98.1 (S), Q99.1 (S), Q100.1 (S), Q101.1 (S), Q102.1 (S)

Notes on the sheet:
BUS CONNECTORS
TIME DISPLAY
DATE DISPLAY
ALL 7 SEGMENT DISPLAYS ARE KINGBRIGHT SA08-21CGKWA ALL 16 SEGMENT DISPLAYS ARE KINGBRIGHT PSA08-12CGKWA
ALL 7 SEGMENT DISPLAYS ARE KINGBRIGHT SA08-21CGKWA
