tomstorey/discrete-nor-logic-clock/schematics/time-decoders.sch

## EAGLE design schematics/time-decoders.sch (2017-05-31)

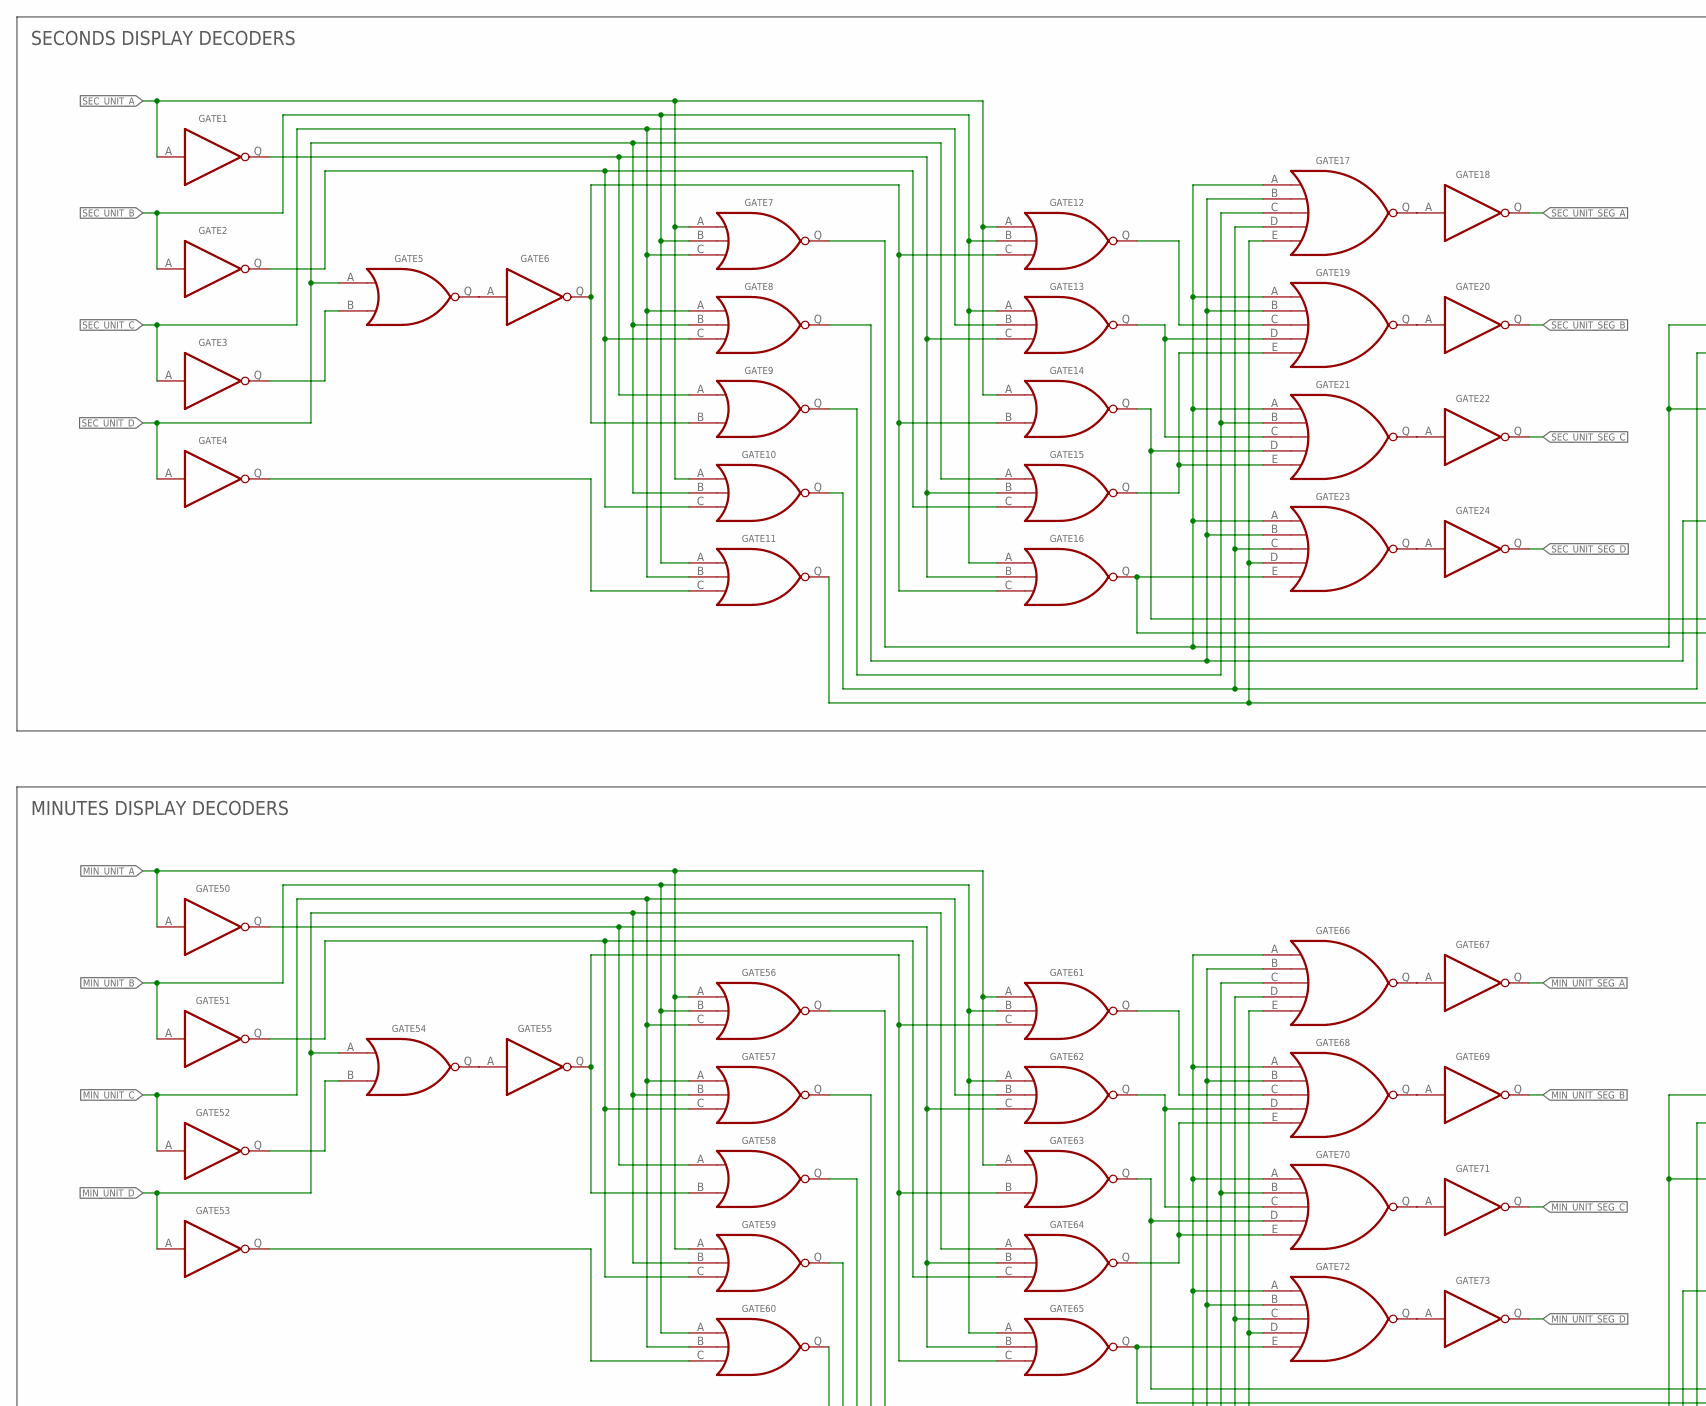
[picture p26: schematic time-decoders.sch, part in row 1, column 1]

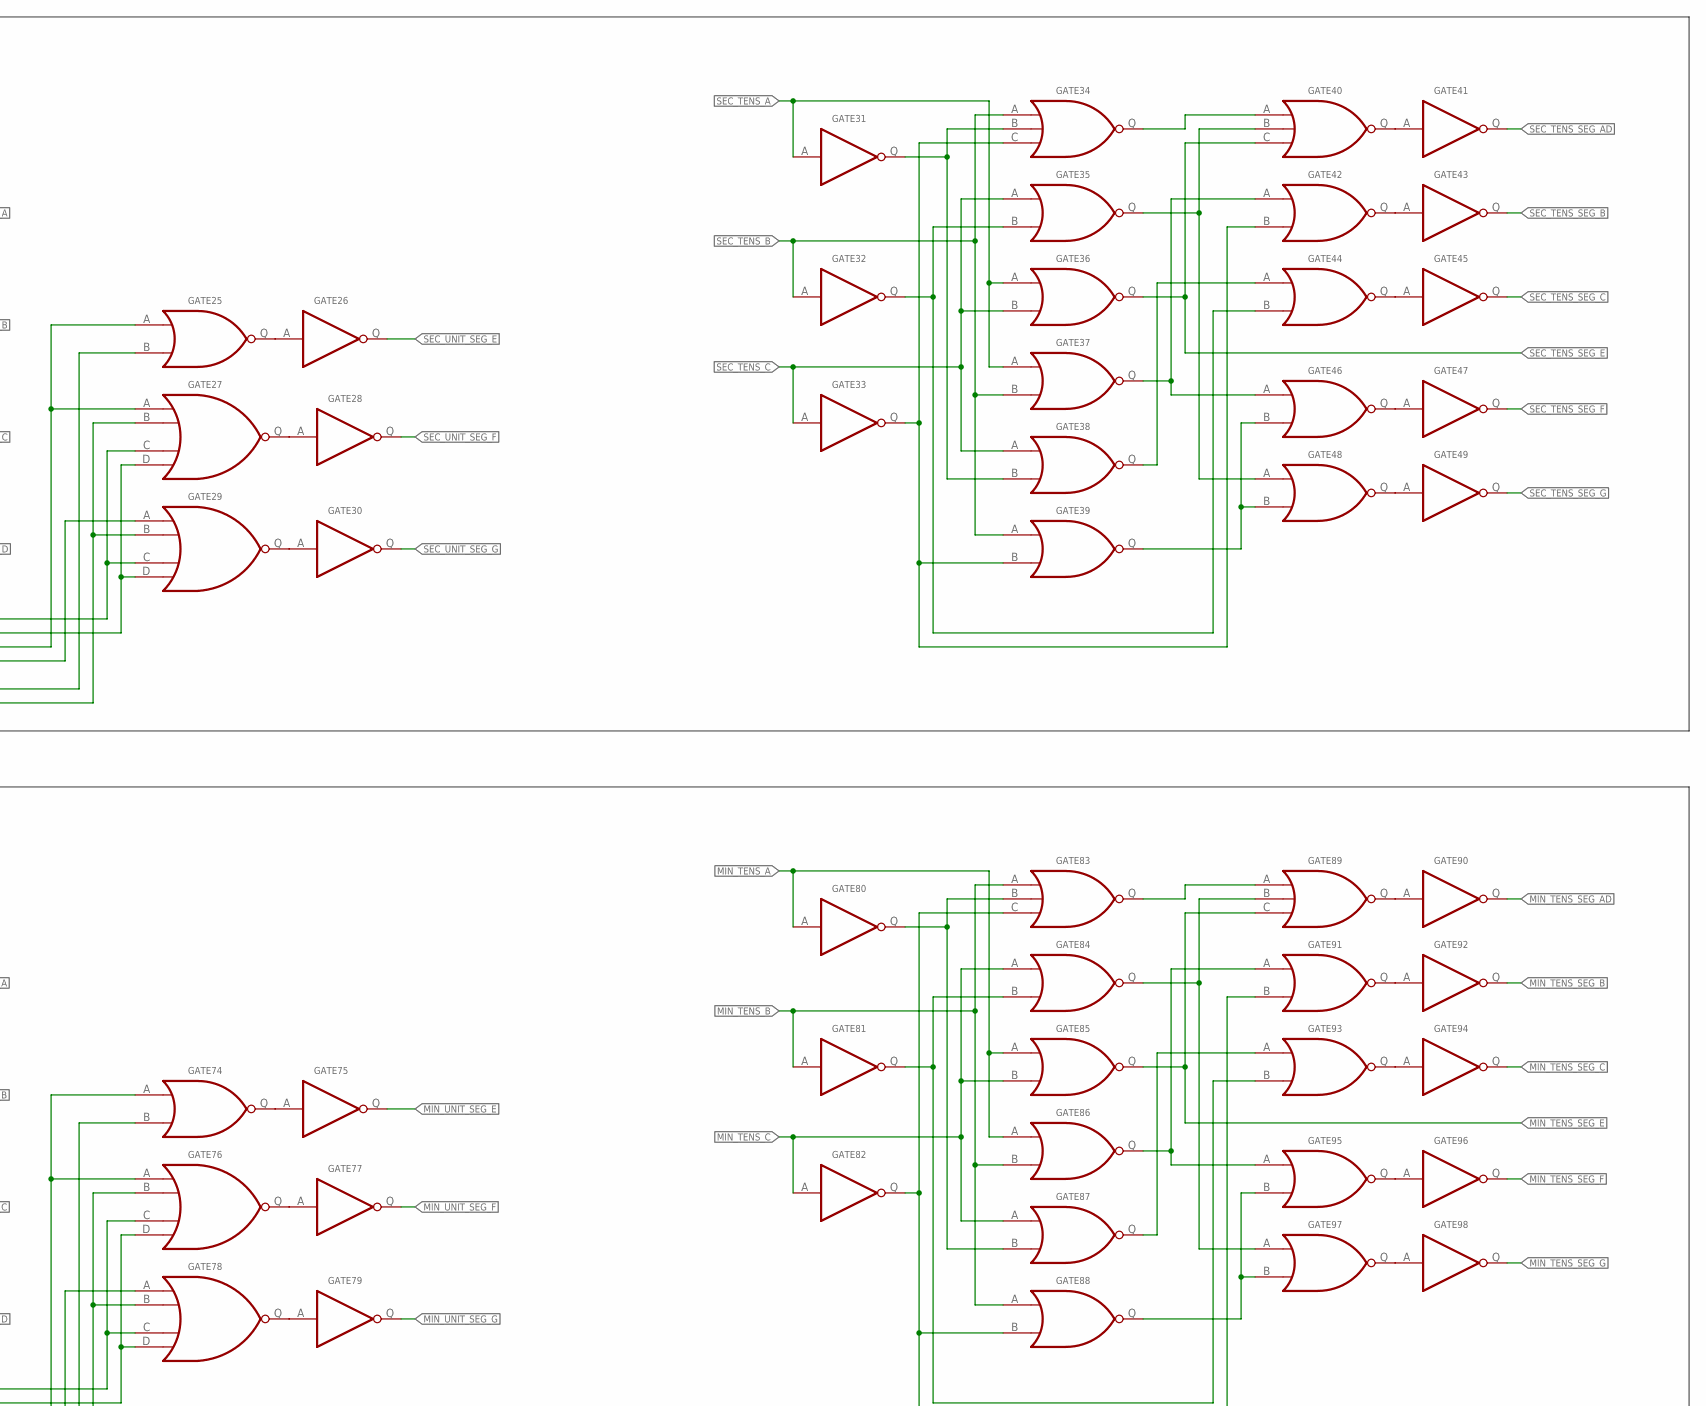
[picture p27: schematic time-decoders.sch, part in row 1, column 2]

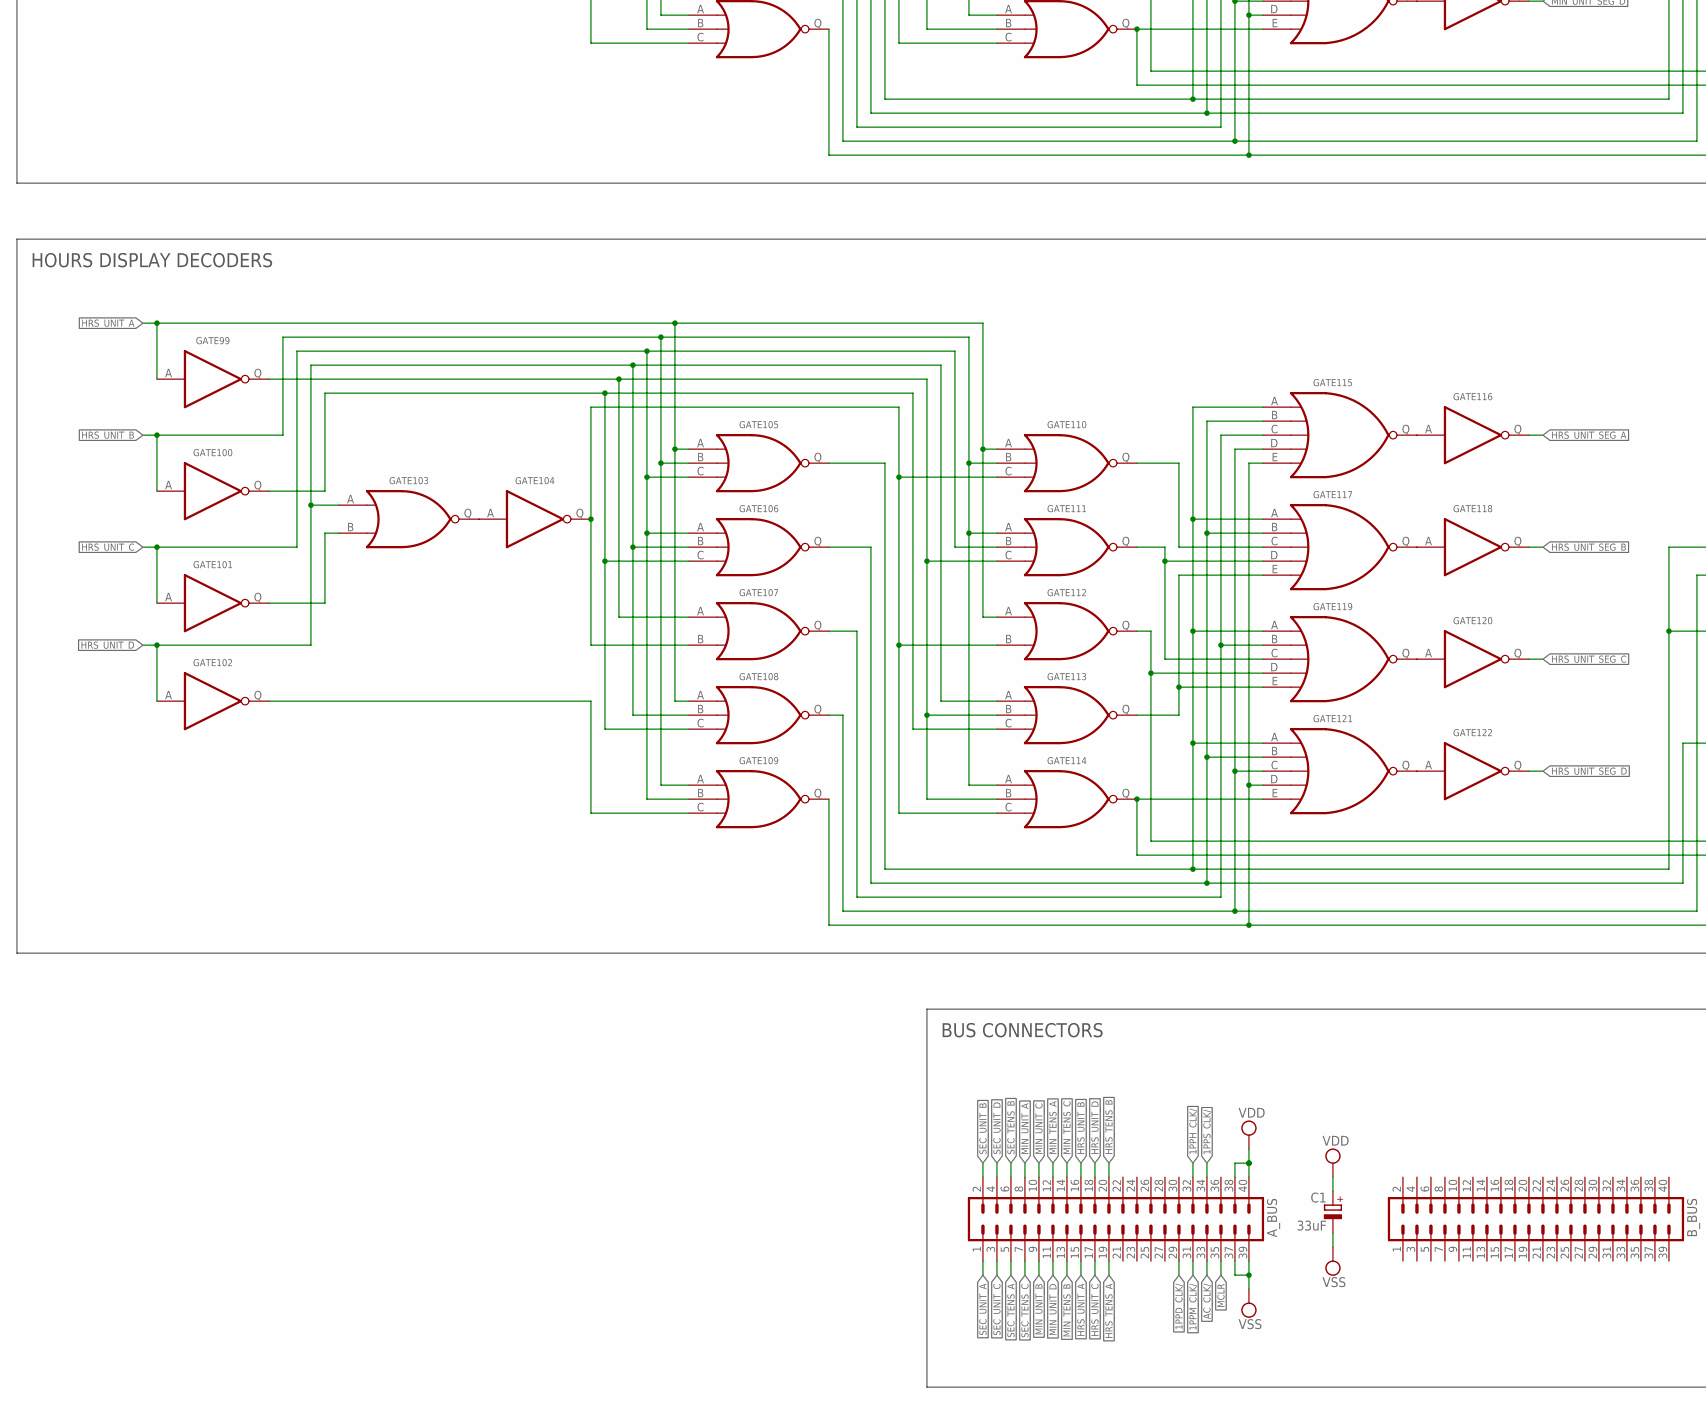
[picture p28: schematic time-decoders.sch, part in row 2, column 1]

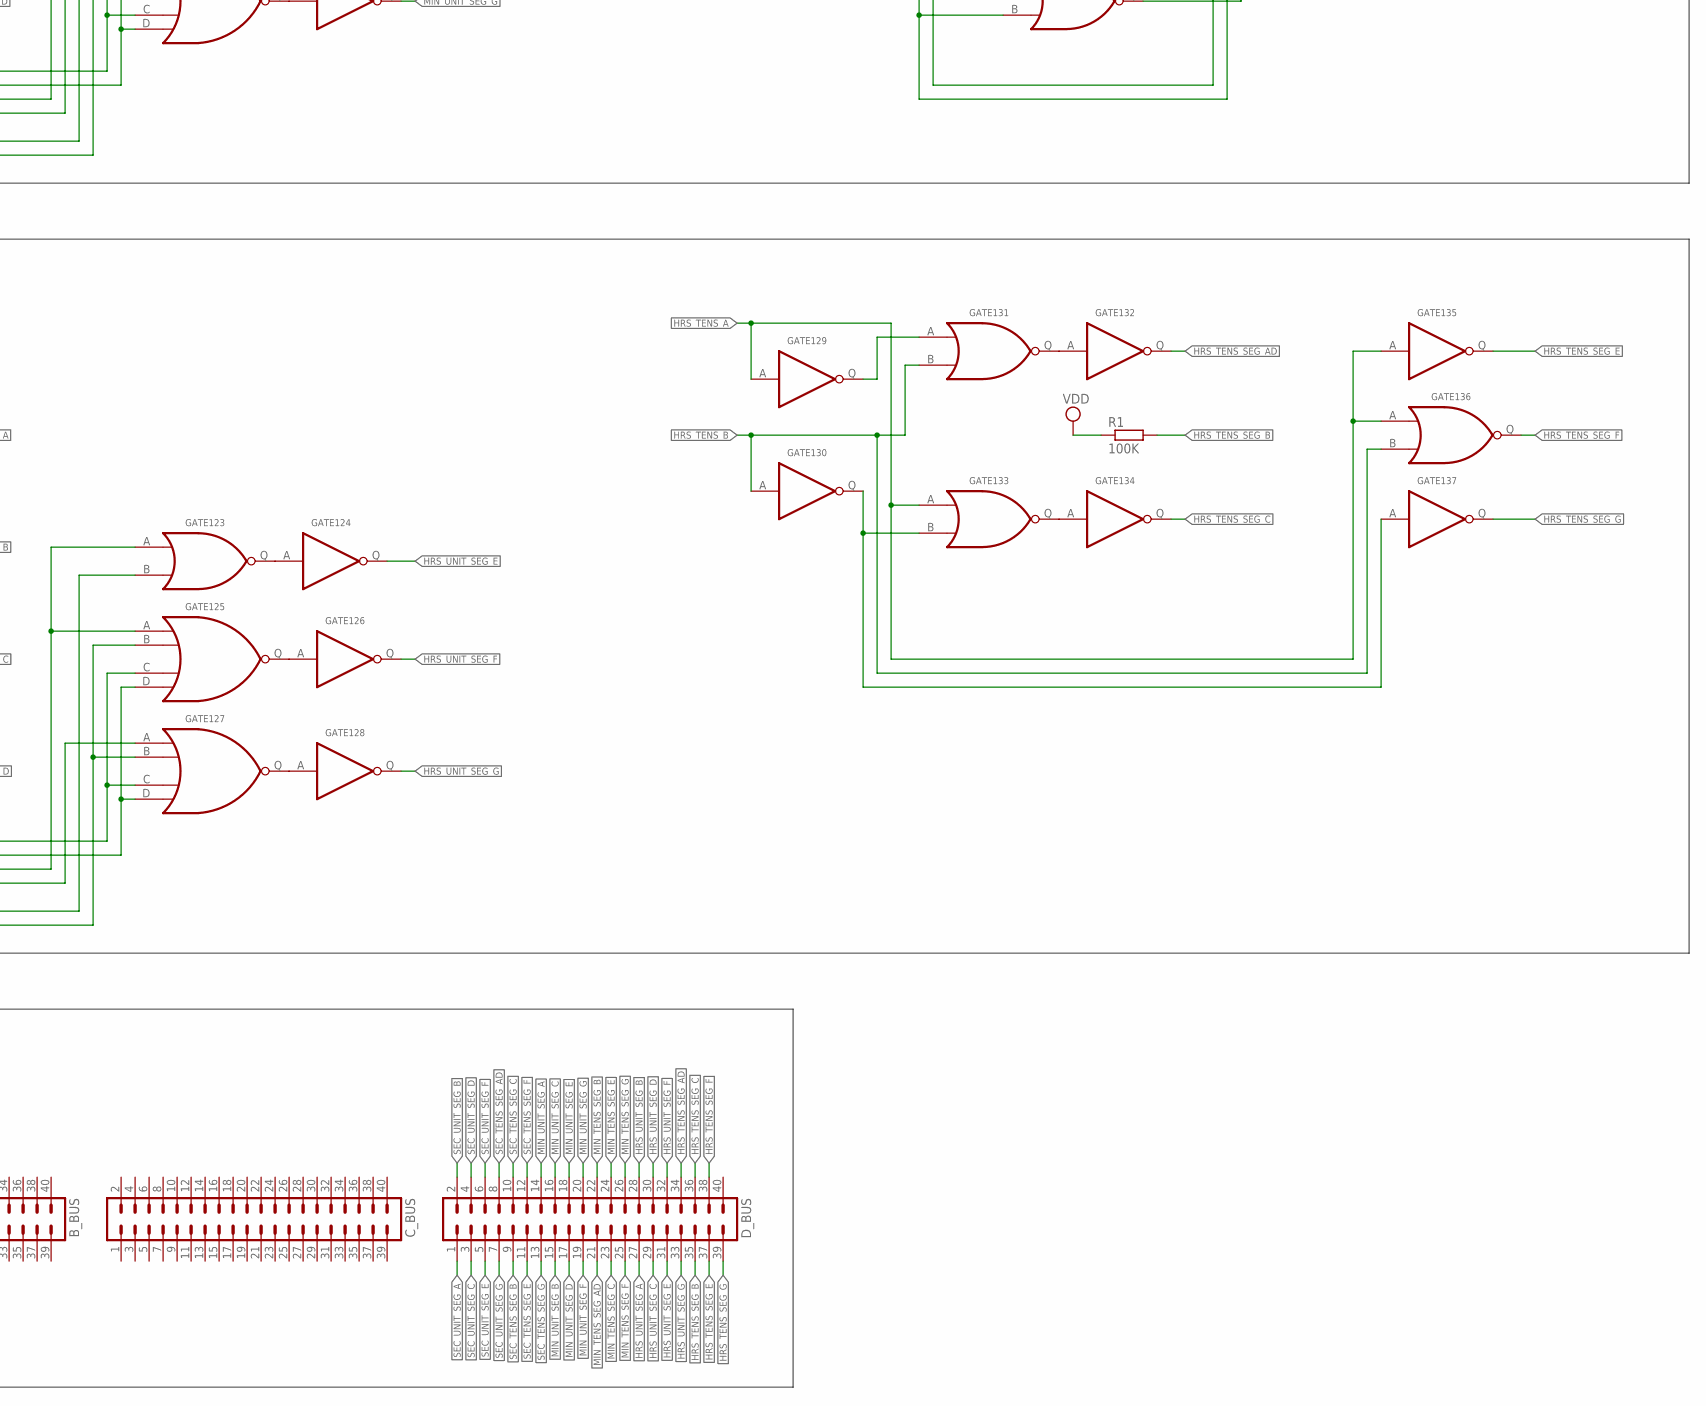
[picture p29: schematic time-decoders.sch, part in row 2, column 2]

Parts:
A_BUS: MA20-2
B_BUS: MA20-2
C1: 33uF; E2,5-6
C_BUS: MA20-2
D_BUS: MA20-2
GATE1, GATE2, GATE3, GATE4, GATE6, GATE18, GATE20, GATE22, GATE24, GATE26, GATE28, GATE30, GATE31, GATE32, GATE33, GATE41, GATE43, GATE45, GATE47, GATE49, GATE50, GATE51, GATE52, GATE53, GATE55, GATE67, GATE69, GATE71, GATE73, GATE75, GATE77, GATE79, GATE80, GATE81, GATE82, GATE90, GATE92, GATE94, GATE96, GATE98, GATE99, GATE100, GATE101, GATE102, GATE104, GATE116, GATE118, GATE120, GATE122, GATE124, GATE126, GATE128, GATE129, GATE130, GATE132, GATE134, GATE135, GATE137: INVERTER
GATE5, GATE9, GATE14, GATE25, GATE35, GATE36, GATE37, GATE38, GATE39, GATE42, GATE44, GATE46, GATE48, GATE54, GATE58, GATE63, GATE74, GATE84, GATE85, GATE86, GATE87, GATE88, GATE91, GATE93, GATE95, GATE97, GATE103, GATE107, GATE112, GATE123, GATE131, GATE133, GATE136: 2NOR
GATE7, GATE8, GATE10, GATE11, GATE12, GATE13, GATE15, GATE16, GATE34, GATE40, GATE56, GATE57, GATE59, GATE60, GATE61, GATE62, GATE64, GATE65, GATE83, GATE89, GATE105, GATE106, GATE108, GATE109, GATE110, GATE111, GATE113, GATE114: 3NOR
GATE17, GATE19, GATE21, GATE23, GATE66, GATE68, GATE70, GATE72, GATE115, GATE117, GATE119, GATE121: 5NOR
GATE27, GATE29, GATE76, GATE78, GATE125, GATE127: 4NOR
R1: 100K; 0207/2V

Connections:
1PPD_CLK/: A_BUS.29
1PPH_CLK/: A_BUS.32
1PPM_CLK/: A_BUS.31
1PPS_CLK/: A_BUS.34
AC_CLK/: A_BUS.33
HRS_TENS_A: A_BUS.19, GATE129.A, GATE133.A, GATE135.A, GATE136.A
HRS_TENS_B: A_BUS.20, GATE130.A, GATE131.B, GATE136.B
HRS_TENS_SEG_AD: D_BUS.34, GATE132.Q
HRS_TENS_SEG_B: D_BUS.35, R1.2
HRS_TENS_SEG_C: D_BUS.36, GATE134.Q
HRS_TENS_SEG_E: D_BUS.37, GATE135.Q
HRS_TENS_SEG_F: D_BUS.38, GATE136.Q
HRS_TENS_SEG_G: D_BUS.39, GATE137.Q
HRS_UNIT_A: A_BUS.15, GATE99.A, GATE105.A, GATE108.A, GATE110.A, GATE112.A
HRS_UNIT_B: A_BUS.16, GATE100.A, GATE105.B, GATE109.A, GATE110.B, GATE111.A, GATE114.A
HRS_UNIT_C: A_BUS.17, GATE101.A, GATE105.C, GATE106.A, GATE109.B, GATE111.B
HRS_UNIT_D: A_BUS.18, GATE102.A, GATE103.A, GATE106.B, GATE108.B, GATE113.A
HRS_UNIT_SEG_A: D_BUS.27, GATE116.Q
HRS_UNIT_SEG_B: D_BUS.28, GATE118.Q
HRS_UNIT_SEG_C: D_BUS.29, GATE120.Q
HRS_UNIT_SEG_D: D_BUS.30, GATE122.Q
HRS_UNIT_SEG_E: D_BUS.31, GATE124.Q
HRS_UNIT_SEG_F: D_BUS.32, GATE126.Q
HRS_UNIT_SEG_G: D_BUS.33, GATE128.Q
MCLR: A_BUS.35
MIN_TENS_A: A_BUS.12, GATE80.A, GATE85.A, GATE86.A
MIN_TENS_B: A_BUS.13, GATE81.A, GATE83.A, GATE86.B, GATE88.A
MIN_TENS_C: A_BUS.14, GATE82.A, GATE84.A, GATE85.B, GATE87.A
MIN_TENS_SEG_AD: D_BUS.21, GATE90.Q
MIN_TENS_SEG_B: D_BUS.22, GATE92.Q
MIN_TENS_SEG_C: D_BUS.23, GATE94.Q
MIN_TENS_SEG_E: D_BUS.24, GATE85.Q, GATE89.C
MIN_TENS_SEG_F: D_BUS.25, GATE96.Q
MIN_TENS_SEG_G: D_BUS.26, GATE98.Q
MIN_UNIT_A: A_BUS.8, GATE50.A, GATE56.A, GATE59.A, GATE61.A, GATE63.A
MIN_UNIT_B: A_BUS.9, GATE51.A, GATE56.B, GATE60.A, GATE61.B, GATE62.A, GATE65.A
MIN_UNIT_C: A_BUS.10, GATE52.A, GATE56.C, GATE57.A, GATE60.B, GATE62.B
MIN_UNIT_D: A_BUS.11, GATE53.A, GATE54.A, GATE57.B, GATE59.B, GATE64.A
MIN_UNIT_SEG_A: D_BUS.14, GATE67.Q
MIN_UNIT_SEG_B: D_BUS.15, GATE69.Q
MIN_UNIT_SEG_C: D_BUS.16, GATE71.Q
MIN_UNIT_SEG_D: D_BUS.17, GATE73.Q
MIN_UNIT_SEG_E: D_BUS.18, GATE75.Q
MIN_UNIT_SEG_F: D_BUS.19, GATE77.Q
MIN_UNIT_SEG_G: D_BUS.20, GATE79.Q
unnamed: GATE1.Q, GATE9.A, GATE13.C, GATE15.B, GATE16.B
unnamed: GATE2.Q, GATE8.C, GATE10.C, GATE15.C
unnamed: GATE3.Q, GATE5.B
unnamed: GATE4.Q, GATE11.C
unnamed: GATE5.Q, GATE6.A
unnamed: GATE6.Q, GATE9.B, GATE12.C, GATE14.B, GATE16.C
unnamed: GATE11.Q, GATE17.E, GATE23.D, GATE27.B, GATE29.B
unnamed: GATE10.Q, GATE17.D, GATE23.C, GATE25.B
unnamed: GATE9.Q, GATE17.C, GATE21.B
unnamed: GATE8.Q, GATE17.B, GATE19.B, GATE23.B, GATE29.A
unnamed: GATE7.Q, GATE17.A, GATE19.A, GATE21.A, GATE23.A, GATE25.A, GATE27.A
unnamed: GATE17.Q, GATE18.A
unnamed: GATE13.Q, GATE19.D, GATE21.C
unnamed: GATE14.Q, GATE21.D, GATE27.C, GATE29.C
unnamed: GATE15.Q, GATE19.E, GATE21.E
unnamed: GATE16.Q, GATE23.E, GATE27.D, GATE29.D
unnamed: GATE12.Q, GATE19.C
unnamed: GATE19.Q, GATE20.A
unnamed: GATE21.Q, GATE22.A
unnamed: GATE23.Q, GATE24.A
unnamed: GATE25.Q, GATE26.A
unnamed: GATE27.Q, GATE28.A
unnamed: GATE29.Q, GATE30.A
unnamed: GATE31.Q, GATE34.B, GATE38.B
unnamed: GATE33.Q, GATE34.C, GATE39.B, GATE42.B
unnamed: GATE34.Q, GATE40.A
unnamed: GATE35.Q, GATE40.B, GATE48.A
unnamed: GATE54.Q, GATE55.A
unnamed: GATE37.Q, GATE42.A, GATE46.A
unnamed: GATE38.Q, GATE44.A
unnamed: GATE39.Q, GATE46.B, GATE48.B
unnamed: GATE40.Q, GATE41.A
unnamed: GATE42.Q, GATE43.A
unnamed: GATE44.Q, GATE45.A
unnamed: GATE66.Q, GATE67.A
unnamed: GATE46.Q, GATE47.A
unnamed: GATE48.Q, GATE49.A
unnamed: GATE81.Q, GATE84.B, GATE93.B
unnamed: GATE80.Q, GATE83.B, GATE87.B
unnamed: GATE82.Q, GATE83.C, GATE88.B, GATE91.B
unnamed: GATE83.Q, GATE89.A
unnamed: GATE84.Q, GATE89.B, GATE97.A
unnamed: GATE50.Q, GATE58.A, GATE62.C, GATE64.B, GATE65.B
unnamed: GATE51.Q, GATE57.C, GATE59.C, GATE64.C
unnamed: GATE52.Q, GATE54.B
unnamed: GATE53.Q, GATE60.C
unnamed: GATE68.Q, GATE69.A
unnamed: GATE55.Q, GATE58.B, GATE61.C, GATE63.B, GATE65.C
unnamed: GATE60.Q, GATE66.E, GATE72.D, GATE76.B, GATE78.B
unnamed: GATE59.Q, GATE66.D, GATE72.C, GATE74.B
unnamed: GATE58.Q, GATE66.C, GATE70.B
unnamed: GATE57.Q, GATE66.B, GATE68.B, GATE72.B, GATE78.A
unnamed: GATE56.Q, GATE66.A, GATE68.A, GATE70.A, GATE72.A, GATE74.A, GATE76.A
unnamed: GATE62.Q, GATE68.D, GATE70.C
unnamed: GATE63.Q, GATE70.D, GATE76.C, GATE78.C
unnamed: GATE64.Q, GATE68.E, GATE70.E
unnamed: GATE65.Q, GATE72.E, GATE76.D, GATE78.D
unnamed: GATE61.Q, GATE68.C
unnamed: GATE70.Q, GATE71.A
unnamed: GATE72.Q, GATE73.A
unnamed: GATE74.Q, GATE75.A
unnamed: GATE76.Q, GATE77.A
unnamed: GATE78.Q, GATE79.A
unnamed: GATE103.Q, GATE104.A
unnamed: GATE115.Q, GATE116.A
unnamed: GATE117.Q, GATE118.A
unnamed: GATE86.Q, GATE91.A, GATE95.A
unnamed: GATE87.Q, GATE93.A
unnamed: GATE88.Q, GATE95.B, GATE97.B
unnamed: GATE89.Q, GATE90.A
unnamed: GATE91.Q, GATE92.A
unnamed: GATE93.Q, GATE94.A
unnamed: GATE119.Q, GATE120.A
unnamed: GATE95.Q, GATE96.A
unnamed: GATE97.Q, GATE98.A
unnamed: GATE121.Q, GATE122.A
unnamed: GATE123.Q, GATE124.A
unnamed: GATE125.Q, GATE126.A
unnamed: GATE127.Q, GATE128.A
unnamed: GATE99.Q, GATE107.A, GATE111.C, GATE113.B, GATE114.B
unnamed: GATE100.Q, GATE106.C, GATE108.C, GATE113.C
unnamed: GATE101.Q, GATE103.B
unnamed: GATE102.Q, GATE109.C
unnamed: GATE104.Q, GATE107.B, GATE110.C, GATE112.B, GATE114.C
unnamed: GATE109.Q, GATE115.E, GATE121.D, GATE125.B, GATE127.B
unnamed: GATE108.Q, GATE115.D, GATE121.C, GATE123.B
unnamed: GATE107.Q, GATE115.C, GATE119.B
unnamed: GATE106.Q, GATE115.B, GATE117.B, GATE121.B, GATE127.A
unnamed: GATE105.Q, GATE115.A, GATE117.A, GATE119.A, GATE121.A, GATE123.A, GATE125.A
unnamed: GATE111.Q, GATE117.D, GATE119.C
unnamed: GATE112.Q, GATE119.D, GATE125.C, GATE127.C
unnamed: GATE113.Q, GATE117.E, GATE119.E
unnamed: GATE114.Q, GATE121.E, GATE125.D, GATE127.D
unnamed: GATE110.Q, GATE117.C
unnamed: GATE129.Q, GATE131.A
unnamed: GATE130.Q, GATE133.B, GATE137.A
unnamed: GATE131.Q, GATE132.A
unnamed: GATE133.Q, GATE134.A
unnamed: GATE32.Q, GATE35.B, GATE44.B
SEC_TENS_A: A_BUS.5, GATE31.A, GATE36.A, GATE37.A
SEC_TENS_B: A_BUS.6, GATE32.A, GATE34.A, GATE37.B, GATE39.A
SEC_TENS_C: A_BUS.7, GATE33.A, GATE35.A, GATE36.B, GATE38.A
SEC_TENS_SEG_AD: D_BUS.8, GATE41.Q
SEC_TENS_SEG_B: D_BUS.9, GATE43.Q
SEC_TENS_SEG_C: D_BUS.10, GATE45.Q
SEC_TENS_SEG_E: D_BUS.11, GATE36.Q, GATE40.C
SEC_TENS_SEG_F: D_BUS.12, GATE47.Q
SEC_TENS_SEG_G: D_BUS.13, GATE49.Q
SEC_UNIT_A: A_BUS.1, GATE1.A, GATE7.A, GATE10.A, GATE12.A, GATE14.A
SEC_UNIT_B: A_BUS.2, GATE2.A, GATE7.B, GATE11.A, GATE12.B, GATE13.A, GATE16.A
SEC_UNIT_C: A_BUS.3, GATE3.A, GATE7.C, GATE8.A, GATE11.B, GATE13.B
SEC_UNIT_D: A_BUS.4, GATE4.A, GATE5.A, GATE8.B, GATE10.B, GATE15.A
SEC_UNIT_SEG_A: D_BUS.1, GATE18.Q
SEC_UNIT_SEG_B: D_BUS.2, GATE20.Q
SEC_UNIT_SEG_C: D_BUS.3, GATE22.Q
SEC_UNIT_SEG_D: D_BUS.4, GATE24.Q
SEC_UNIT_SEG_E: D_BUS.5, GATE26.Q
SEC_UNIT_SEG_F: D_BUS.6, GATE28.Q
SEC_UNIT_SEG_G: D_BUS.7, GATE30.Q
VDD: A_BUS.38, A_BUS.40, C1.+, R1.1
VSS: A_BUS.37, A_BUS.39, C1.-

Notes on the sheet:
SECONDS DISPLAY DECODERS
MINUTES DISPLAY DECODERS
HOURS DISPLAY DECODERS
BUS CONNECTORS
