tomstorey/discrete-nor-logic-clock/schematics/time-module.sch

## EAGLE design schematics/time-module.sch (2017-05-18)

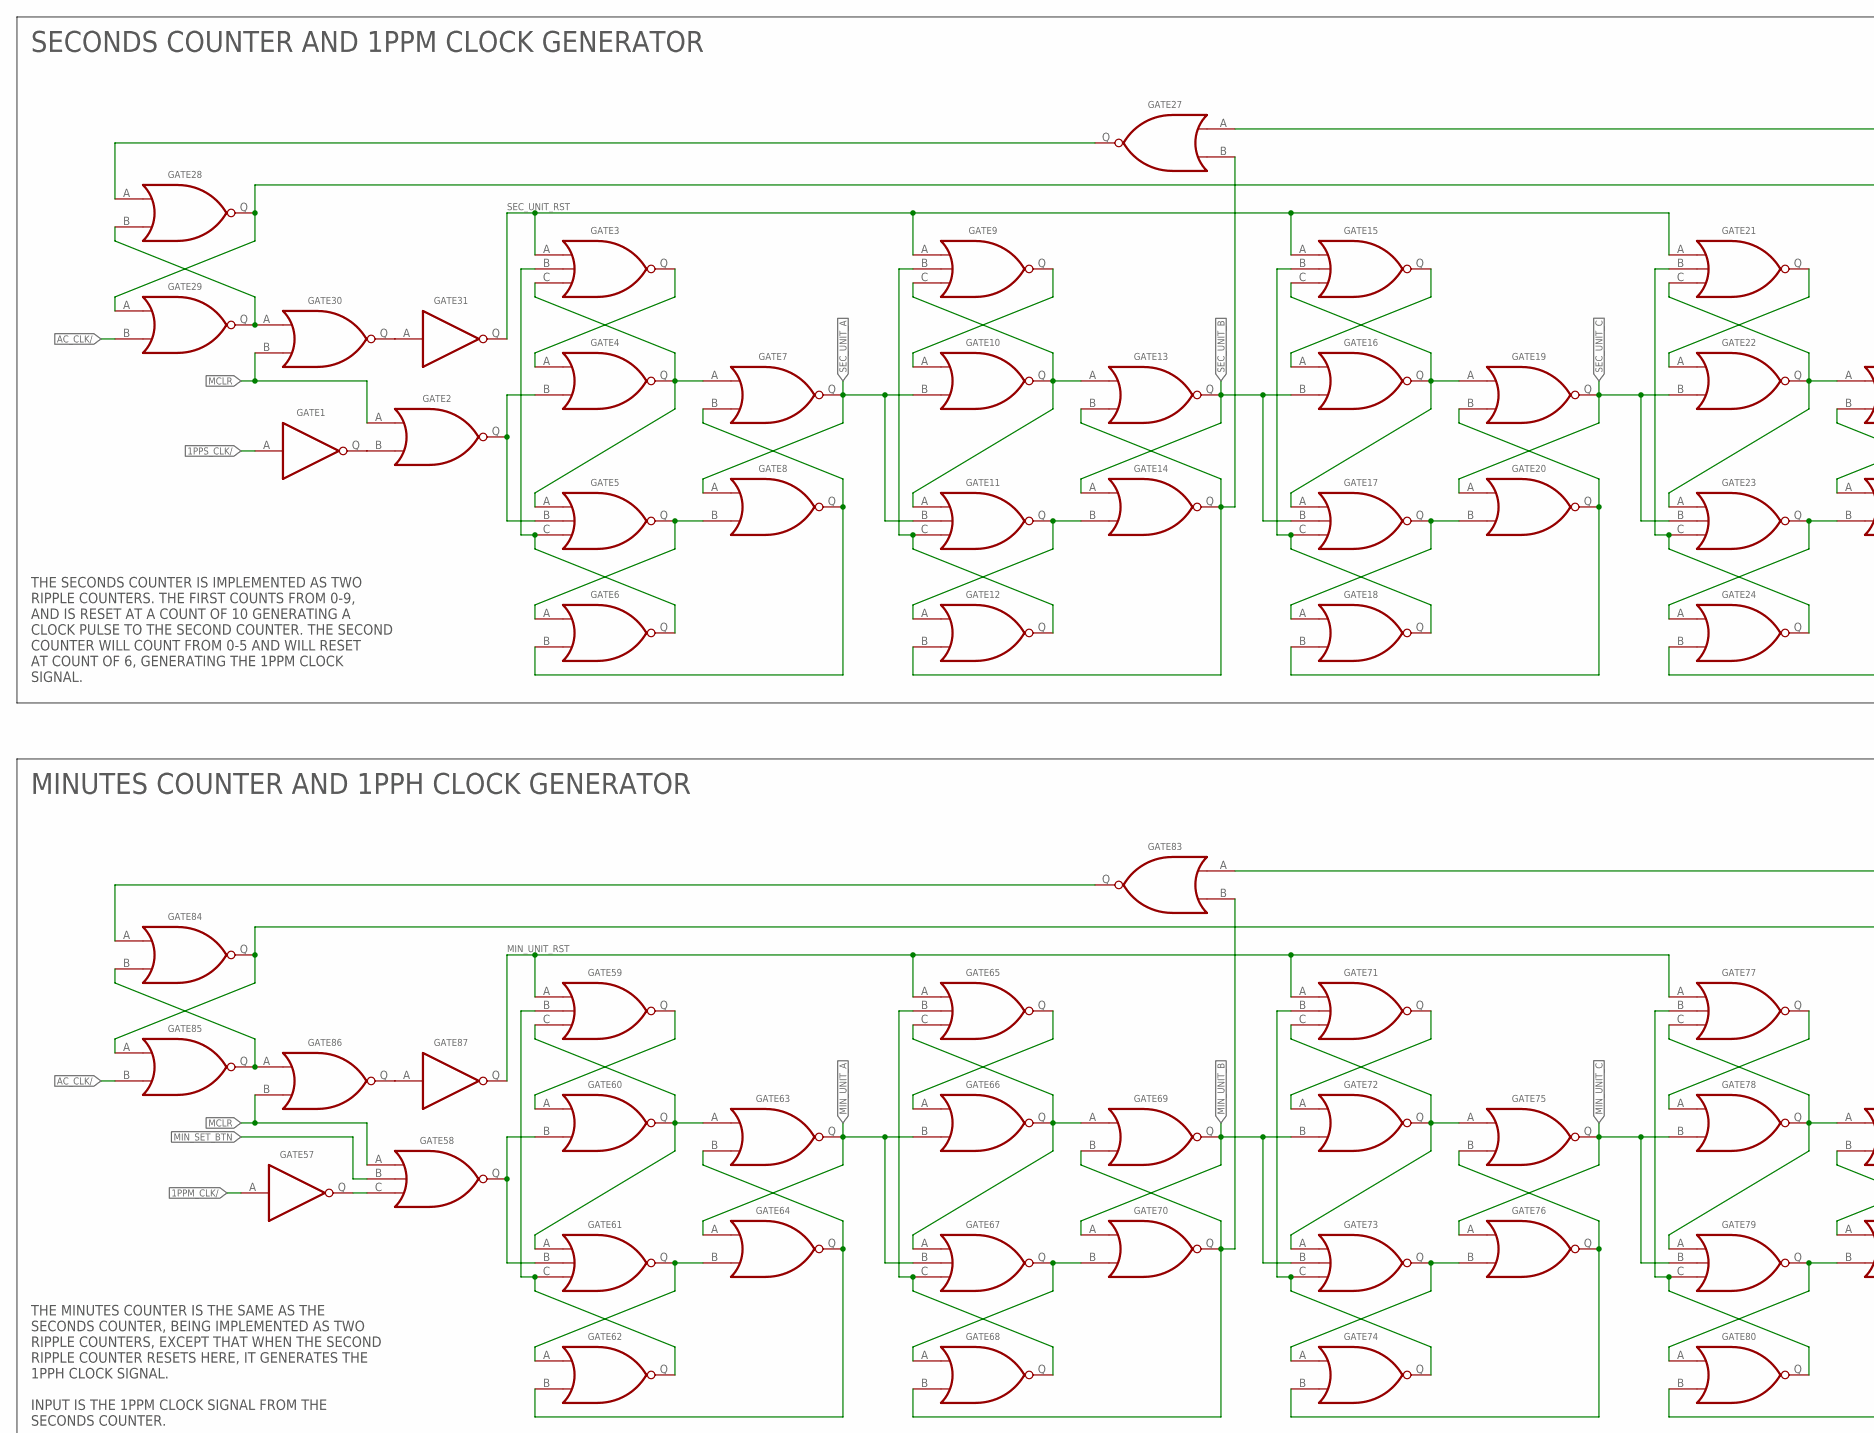
[picture p30: schematic time-module.sch, part in row 1, column 1]

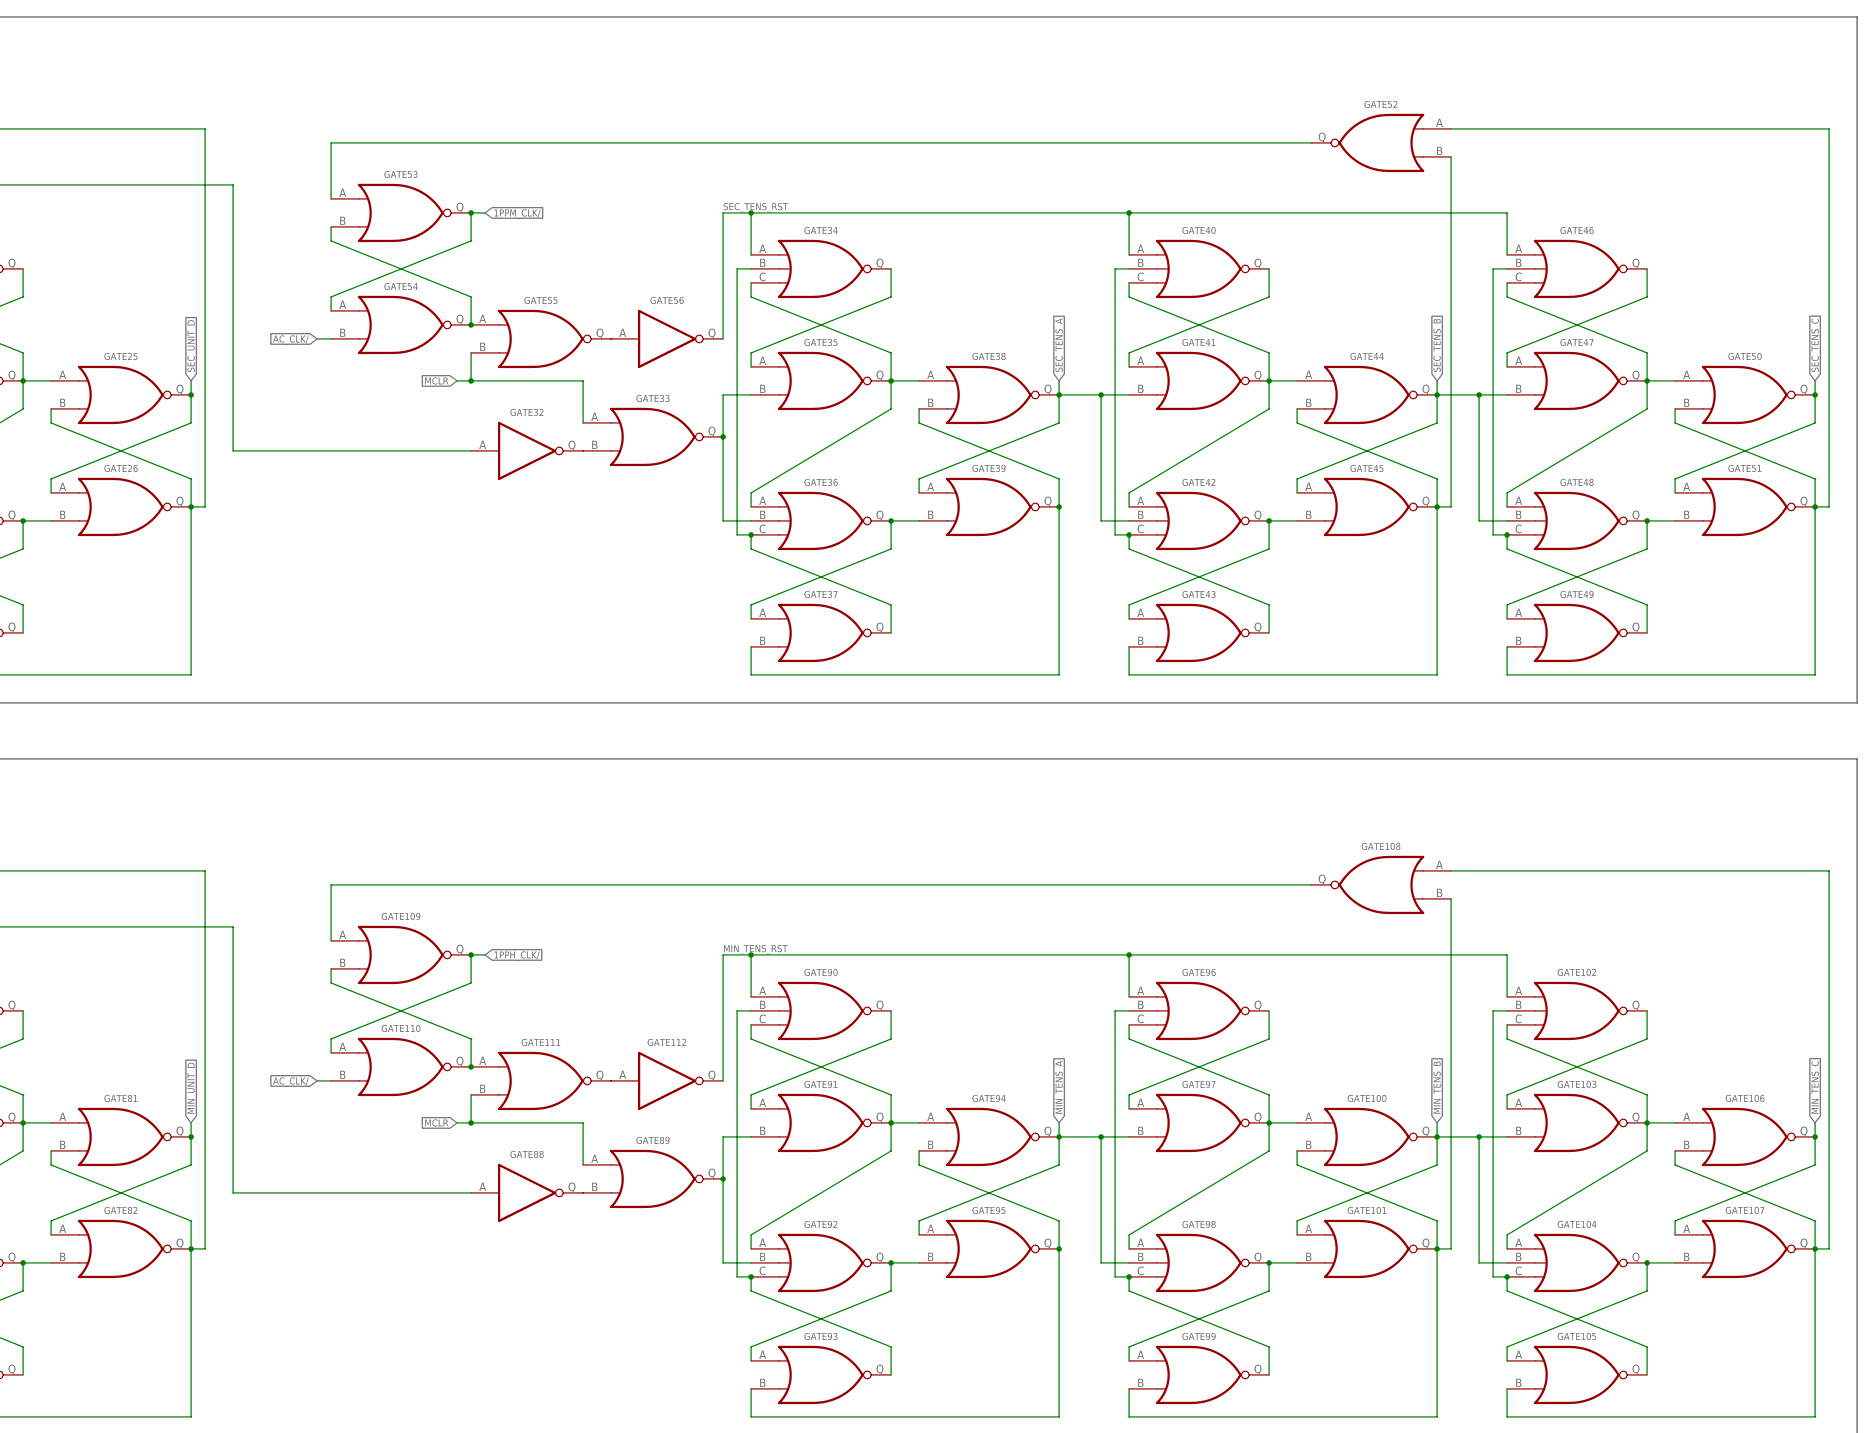
[picture p31: schematic time-module.sch, part in row 1, column 2]

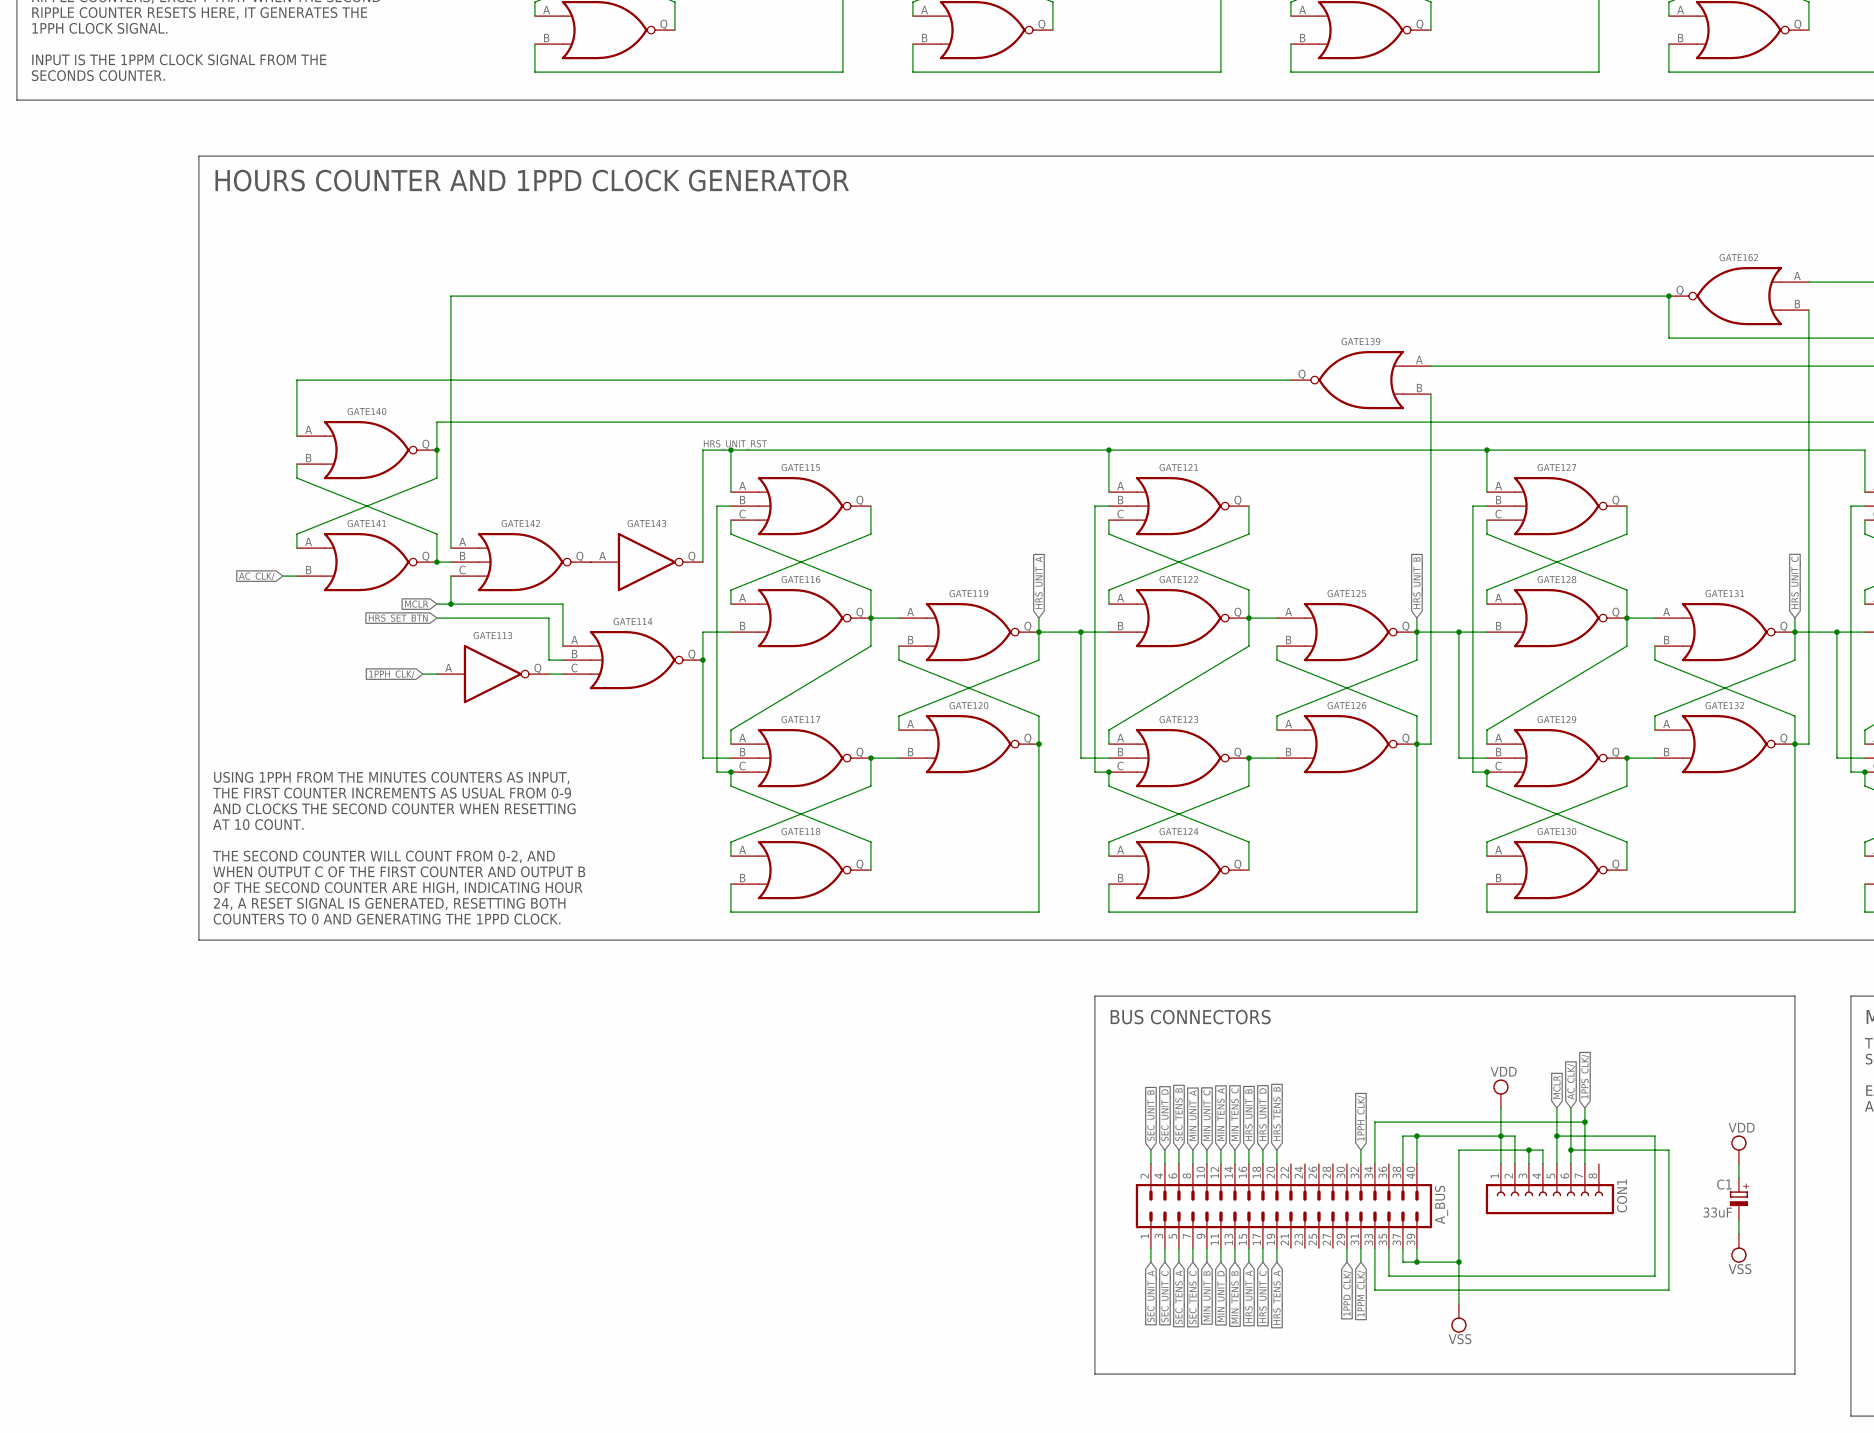
[picture p32: schematic time-module.sch, part in row 2, column 1]

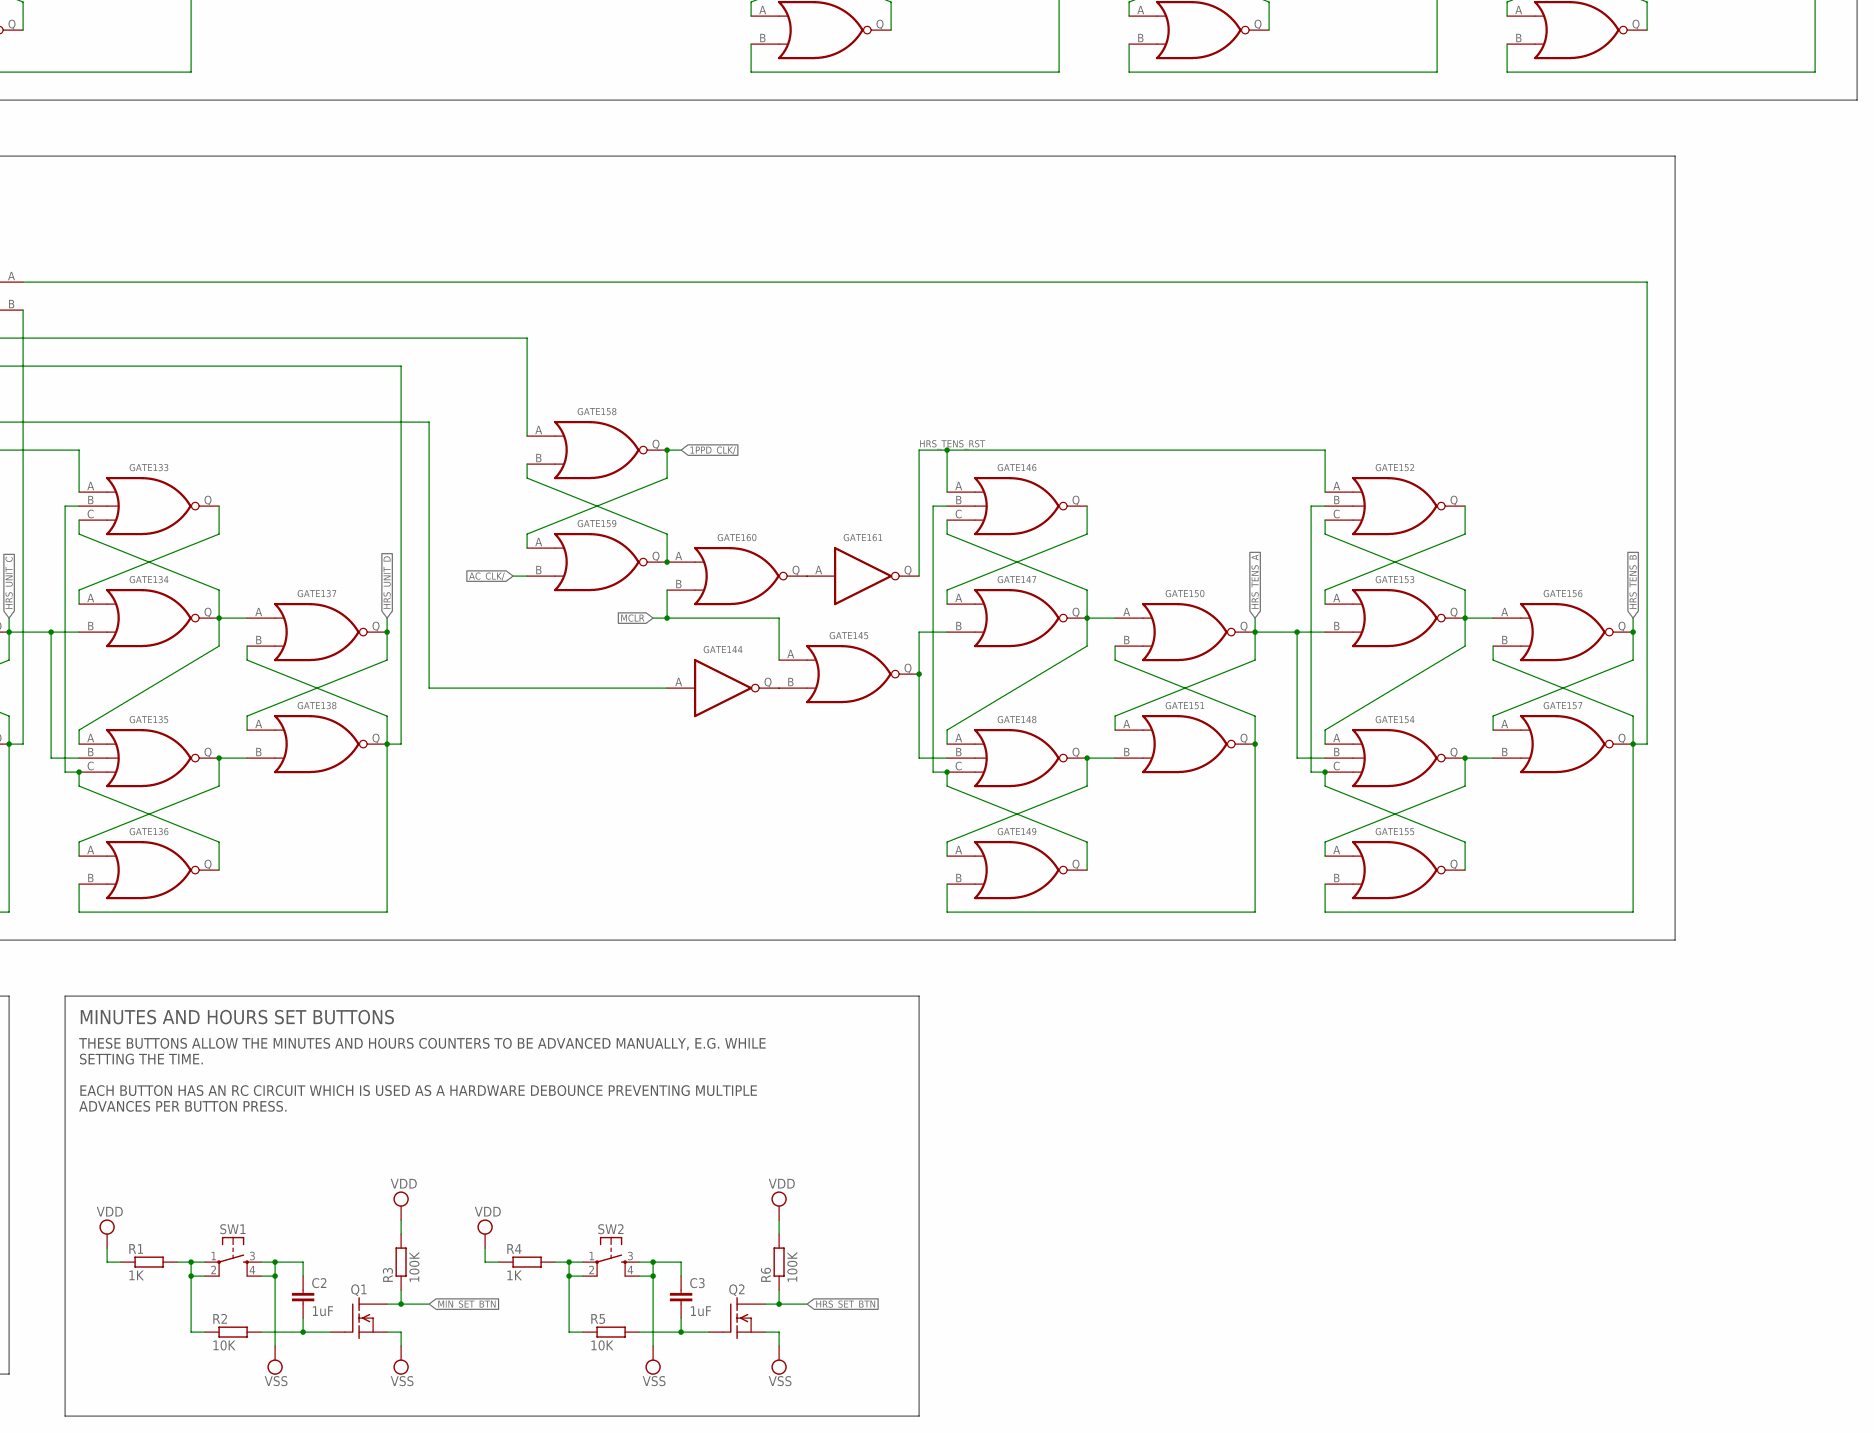
[picture p33: schematic time-module.sch, part in row 2, column 2]

Parts:
A_BUS: MA20-2
C1: 33uF; E2,5-6
C2, C3: 1uF; C050-025X075
CON1: FE08-1; FE08
GATE1, GATE31, GATE32, GATE56, GATE57, GATE87, GATE88, GATE112, GATE113, GATE143, GATE144, GATE161: INVERTER
GATE2, GATE4, GATE6, GATE7, GATE8, GATE10, GATE12, GATE13, GATE14, GATE16, GATE18, GATE19, GATE20, GATE22, GATE24, GATE25, GATE26, GATE27, GATE28, GATE29, GATE30, GATE33, GATE35, GATE37, GATE38, GATE39, GATE41, GATE43, GATE44, GATE45, GATE47, GATE49, GATE50, GATE51, GATE52, GATE53, GATE54, GATE55, GATE60, GATE62, GATE63, GATE64, GATE66, GATE68, GATE69, GATE70, GATE72, GATE74, GATE75, GATE76, GATE78, GATE80, GATE81, GATE82, GATE83, GATE84, GATE85, GATE86, GATE89, GATE91, GATE93, GATE94, GATE95, GATE97, GATE99, GATE100, GATE101, GATE103, GATE105, GATE106, GATE107, GATE108, GATE109, GATE110, GATE111, GATE116, GATE118, GATE119, GATE120, GATE122, GATE124, GATE125, GATE126, GATE128, GATE130, GATE131, GATE132, GATE134, GATE136, GATE137, GATE138, GATE139, GATE140, GATE141, GATE145, GATE147, GATE149, GATE150, GATE151, GATE153, GATE155, GATE156, GATE157, GATE158, GATE159, GATE160, GATE162: 2NOR
GATE3, GATE5, GATE9, GATE11, GATE15, GATE17, GATE21, GATE23, GATE34, GATE36, GATE40, GATE42, GATE46, GATE48, GATE58, GATE59, GATE61, GATE65, GATE67, GATE71, GATE73, GATE77, GATE79, GATE90, GATE92, GATE96, GATE98, GATE102, GATE104, GATE114, GATE115, GATE117, GATE121, GATE123, GATE127, GATE129, GATE133, GATE135, GATE142, GATE146, GATE148, GATE152, GATE154: 3NOR
Q1, Q2: 2N7000; TO-92
R1, R4: 1K; 0207/2V
R2, R5: 10K; 0207/2V
R3, R6: 100K; 0207/2V
SW1, SW2: SPST-TACSWITCH; TE-SMD-TACSWITCH

Connections:
1PPD_CLK/: A_BUS.29, GATE158.Q, GATE159.A
1PPH_CLK/: A_BUS.32, GATE109.Q, GATE110.A, GATE113.A
1PPM_CLK/: A_BUS.31, GATE53.Q, GATE54.A, GATE57.A
1PPS_CLK/: A_BUS.34, CON1.7, GATE1.A
AC_CLK/: A_BUS.33, CON1.6, GATE29.B, GATE54.B, GATE85.B, GATE110.B, GATE141.B, GATE159.B
HRS_SET_BTN: GATE114.B, Q2.3 (D), R6.1
HRS_TENS_A: A_BUS.19, GATE150.Q, GATE151.A, GATE153.B, GATE154.B
HRS_TENS_B: A_BUS.20, GATE156.Q, GATE157.A
HRS_TENS_RST: GATE146.A, GATE152.A, GATE161.Q
HRS_UNIT_A: A_BUS.15, GATE119.Q, GATE120.A, GATE122.B, GATE123.B
HRS_UNIT_B: A_BUS.16, GATE125.Q, GATE126.A, GATE128.B, GATE129.B
HRS_UNIT_C: A_BUS.17, GATE131.Q, GATE132.A, GATE134.B, GATE135.B
HRS_UNIT_D: A_BUS.18, GATE137.Q, GATE138.A
HRS_UNIT_RST: GATE115.A, GATE121.A, GATE127.A, GATE133.A, GATE143.Q
HRS_UNIT_RST/: GATE140.Q, GATE141.A, GATE144.A
MCLR: A_BUS.35, CON1.5, GATE2.A, GATE30.B, GATE33.A, GATE55.B, GATE58.A, GATE86.B, GATE89.A, GATE111.B, GATE114.A, GATE142.C, GATE145.A, GATE160.B
MIN_SET_BTN: GATE58.B, Q1.3 (D), R3.1
MIN_TENS_A: A_BUS.12, GATE94.Q, GATE95.A, GATE97.B, GATE98.B
MIN_TENS_B: A_BUS.13, GATE100.Q, GATE101.A, GATE103.B, GATE104.B
MIN_TENS_C: A_BUS.14, GATE106.Q, GATE107.A
MIN_TENS_RST: GATE90.A, GATE96.A, GATE102.A, GATE112.Q
MIN_UNIT_A: A_BUS.8, GATE63.Q, GATE64.A, GATE66.B, GATE67.B
MIN_UNIT_B: A_BUS.9, GATE69.Q, GATE70.A, GATE72.B, GATE73.B
MIN_UNIT_C: A_BUS.10, GATE75.Q, GATE76.A, GATE78.B, GATE79.B
MIN_UNIT_D: A_BUS.11, GATE81.Q, GATE82.A
MIN_UNIT_RST: GATE59.A, GATE65.A, GATE71.A, GATE77.A, GATE87.Q
MIN_UNIT_RST/: GATE84.Q, GATE85.A, GATE88.A
unnamed: GATE34.C, GATE35.Q, GATE36.A, GATE38.A
unnamed: GATE34.Q, GATE35.A
unnamed: GATE34.B, GATE36.C, GATE37.Q
unnamed: GATE36.Q, GATE37.A, GATE39.B
unnamed: GATE37.B, GATE38.B, GATE39.Q
unnamed: GATE59.C, GATE60.Q, GATE61.A, GATE63.A
unnamed: GATE40.C, GATE41.Q, GATE42.A, GATE44.A
unnamed: GATE40.Q, GATE41.A
unnamed: GATE40.B, GATE42.C, GATE43.Q
unnamed: GATE42.Q, GATE43.A, GATE45.B
unnamed: GATE43.B, GATE44.B, GATE45.Q, GATE52.B
unnamed: GATE3.C, GATE4.Q, GATE5.A, GATE7.A
unnamed: GATE59.Q, GATE60.A
unnamed: GATE46.C, GATE47.Q, GATE48.A, GATE50.A
unnamed: GATE46.Q, GATE47.A
unnamed: GATE3.Q, GATE4.A
unnamed: GATE46.B, GATE48.C, GATE49.Q
unnamed: GATE3.B, GATE5.C, GATE6.Q
unnamed: GATE48.Q, GATE49.A, GATE51.B
unnamed: GATE49.B, GATE50.B, GATE51.Q, GATE52.A
unnamed: GATE59.B, GATE61.C, GATE62.Q
unnamed: GATE52.Q, GATE53.A
unnamed: GATE5.Q, GATE6.A, GATE8.B
unnamed: GATE32.Q, GATE33.B
unnamed: GATE53.B, GATE54.Q, GATE55.A
unnamed: GATE61.Q, GATE62.A, GATE64.B
unnamed: GATE62.B, GATE63.B, GATE64.Q
unnamed: GATE65.C, GATE66.Q, GATE67.A, GATE69.A
unnamed: GATE65.Q, GATE66.A
unnamed: GATE6.B, GATE7.B, GATE8.Q
unnamed: GATE65.B, GATE67.C, GATE68.Q
unnamed: GATE67.Q, GATE68.A, GATE70.B
unnamed: GATE68.B, GATE69.B, GATE70.Q, GATE83.B
unnamed: GATE71.C, GATE72.Q, GATE73.A, GATE75.A
unnamed: GATE9.C, GATE10.Q, GATE11.A, GATE13.A
unnamed: GATE71.Q, GATE72.A
unnamed: GATE9.Q, GATE10.A
unnamed: GATE9.B, GATE11.C, GATE12.Q
unnamed: GATE71.B, GATE73.C, GATE74.Q
unnamed: GATE73.Q, GATE74.A, GATE76.B
unnamed: GATE74.B, GATE75.B, GATE76.Q
unnamed: GATE11.Q, GATE12.A, GATE14.B
unnamed: GATE77.C, GATE78.Q, GATE79.A, GATE81.A
unnamed: GATE77.Q, GATE78.A
unnamed: GATE77.B, GATE79.C, GATE80.Q
unnamed: GATE12.B, GATE13.B, GATE14.Q, GATE27.B
unnamed: GATE15.C, GATE16.Q, GATE17.A, GATE19.A
unnamed: GATE79.Q, GATE80.A, GATE82.B
unnamed: GATE15.Q, GATE16.A
unnamed: GATE15.B, GATE17.C, GATE18.Q
unnamed: GATE17.Q, GATE18.A, GATE20.B
unnamed: GATE18.B, GATE19.B, GATE20.Q
unnamed: GATE21.C, GATE22.Q, GATE23.A, GATE25.A
unnamed: GATE21.Q, GATE22.A
unnamed: GATE21.B, GATE23.C, GATE24.Q
unnamed: GATE23.Q, GATE24.A, GATE26.B
unnamed: GATE24.B, GATE25.B, GATE26.Q, GATE27.A
unnamed: GATE27.Q, GATE28.A
unnamed: GATE30.Q, GATE31.A
unnamed: GATE28.B, GATE29.Q, GATE30.A
unnamed: GATE80.B, GATE81.B, GATE82.Q, GATE83.A
unnamed: GATE83.Q, GATE84.A
unnamed: GATE55.Q, GATE56.A
unnamed: GATE158.B, GATE159.Q, GATE160.A
unnamed: GATE90.C, GATE91.Q, GATE92.A, GATE94.A
unnamed: GATE90.Q, GATE91.A
unnamed: GATE90.B, GATE92.C, GATE93.Q
unnamed: GATE92.Q, GATE93.A, GATE95.B
unnamed: GATE93.B, GATE94.B, GATE95.Q
unnamed: GATE96.C, GATE97.Q, GATE98.A, GATE100.A
unnamed: GATE96.Q, GATE97.A
unnamed: GATE96.B, GATE98.C, GATE99.Q
unnamed: GATE98.Q, GATE99.A, GATE101.B
unnamed: GATE99.B, GATE100.B, GATE101.Q, GATE108.B
unnamed: GATE102.C, GATE103.Q, GATE104.A, GATE106.A
unnamed: GATE102.Q, GATE103.A
unnamed: GATE102.B, GATE104.C, GATE105.Q
unnamed: GATE104.Q, GATE105.A, GATE107.B
unnamed: GATE105.B, GATE106.B, GATE107.Q, GATE108.A
unnamed: GATE108.Q, GATE109.A
unnamed: GATE88.Q, GATE89.B
unnamed: GATE84.B, GATE85.Q, GATE86.A
unnamed: GATE115.C, GATE116.Q, GATE117.A, GATE119.A
unnamed: GATE115.Q, GATE116.A
unnamed: GATE115.B, GATE117.C, GATE118.Q
unnamed: GATE117.Q, GATE118.A, GATE120.B
unnamed: GATE118.B, GATE119.B, GATE120.Q
unnamed: GATE121.C, GATE122.Q, GATE123.A, GATE125.A
unnamed: GATE121.Q, GATE122.A
unnamed: GATE121.B, GATE123.C, GATE124.Q
unnamed: GATE123.Q, GATE124.A, GATE126.B
unnamed: GATE124.B, GATE125.B, GATE126.Q, GATE139.B
unnamed: GATE127.C, GATE128.Q, GATE129.A, GATE131.A
unnamed: GATE127.Q, GATE128.A
unnamed: GATE127.B, GATE129.C, GATE130.Q
unnamed: GATE129.Q, GATE130.A, GATE132.B
unnamed: GATE130.B, GATE131.B, GATE132.Q, GATE162.B
unnamed: GATE133.C, GATE134.Q, GATE135.A, GATE137.A
unnamed: GATE133.Q, GATE134.A
unnamed: GATE133.B, GATE135.C, GATE136.Q
unnamed: GATE135.Q, GATE136.A, GATE138.B
unnamed: GATE136.B, GATE137.B, GATE138.Q, GATE139.A
unnamed: GATE139.Q, GATE140.A
unnamed: GATE140.B, GATE141.Q, GATE142.B
unnamed: GATE113.Q, GATE114.C
unnamed: GATE142.A, GATE158.A, GATE162.Q
unnamed: GATE109.B, GATE110.Q, GATE111.A
unnamed: GATE146.C, GATE147.Q, GATE148.A, GATE150.A
unnamed: GATE146.Q, GATE147.A
unnamed: GATE146.B, GATE148.C, GATE149.Q
unnamed: GATE148.Q, GATE149.A, GATE151.B
unnamed: GATE149.B, GATE150.B, GATE151.Q
unnamed: GATE152.C, GATE153.Q, GATE154.A, GATE156.A
unnamed: GATE152.Q, GATE153.A
unnamed: GATE152.B, GATE154.C, GATE155.Q
unnamed: GATE154.Q, GATE155.A, GATE157.B
unnamed: GATE142.Q, GATE143.A
unnamed: GATE2.Q, GATE4.B, GATE5.B
unnamed: GATE1.Q, GATE2.B
unnamed: GATE155.B, GATE156.B, GATE157.Q, GATE162.A
unnamed: GATE33.Q, GATE35.B, GATE36.B
unnamed: R1.2, R2.1, SW1.1, SW1.2
unnamed: GATE58.Q, GATE60.B, GATE61.B
unnamed: GATE86.Q, GATE87.A
unnamed: GATE89.Q, GATE91.B, GATE92.B
unnamed: GATE111.Q, GATE112.A
unnamed: GATE114.Q, GATE116.B, GATE117.B
unnamed: GATE144.Q, GATE145.B
unnamed: GATE145.Q, GATE147.B, GATE148.B
unnamed: GATE160.Q, GATE161.A
unnamed: GATE57.Q, GATE58.C
unnamed: C2.2, Q1.2 (G), R2.2
unnamed: R4.2, R5.1, SW2.1, SW2.2
unnamed: C3.2, Q2.2 (G), R5.2
SEC_TENS_A: A_BUS.5, GATE38.Q, GATE39.A, GATE41.B, GATE42.B
SEC_TENS_B: A_BUS.6, GATE44.Q, GATE45.A, GATE47.B, GATE48.B
SEC_TENS_C: A_BUS.7, GATE50.Q, GATE51.A
SEC_TENS_RST: GATE34.A, GATE40.A, GATE46.A, GATE56.Q
SEC_UNIT_A: A_BUS.1, GATE7.Q, GATE8.A, GATE10.B, GATE11.B
SEC_UNIT_B: A_BUS.2, GATE13.Q, GATE14.A, GATE16.B, GATE17.B
SEC_UNIT_C: A_BUS.3, GATE19.Q, GATE20.A, GATE22.B, GATE23.B
SEC_UNIT_D: A_BUS.4, GATE25.Q, GATE26.A
SEC_UNIT_RST: GATE3.A, GATE9.A, GATE15.A, GATE21.A, GATE31.Q
SEC_UNIT_RST/: GATE28.Q, GATE29.A, GATE32.A
VDD: A_BUS.38, A_BUS.40, C1.+, CON1.1, CON1.2, R1.1, R3.2, R4.1, R6.2
VSS: A_BUS.37, A_BUS.39, C1.-, C2.1, C3.1, CON1.3, CON1.4, Q1.1 (S), Q2.1 (S), SW1.3, SW1.4, SW2.3, SW2.4

Notes on the sheet:
SECONDS COUNTER AND 1PPM CLOCK GENERATOR
THE SECONDS COUNTER IS IMPLEMENTED AS TWO RIPPLE COUNTERS. THE FIRST COUNTS FROM 0-9, AND IS RESET AT A COUNT OF 10 GENERATING A CLOCK PULSE TO THE SECOND COUNTER. THE SECOND COUNTER WILL COUNT FROM 0-5 AND WILL RESET AT COUNT OF 6, GENERATING THE 1PPM CLOCK SIGNAL.
MINUTES COUNTER AND 1PPH CLOCK GENERATOR
THE MINUTES COUNTER IS THE SAME AS THE SECONDS COUNTER, BEING IMPLEMENTED AS TWO RIPPLE COUNTERS, EXCEPT THAT WHEN THE SECOND RIPPLE COUNTER RESETS HERE, IT GENERATES THE 1PPH CLOCK SIGNAL. INPUT IS THE 1PPM CLOCK SIGNAL FROM THE SECONDS COUNTER.
HOURS COUNTER AND 1PPD CLOCK GENERATOR
USING 1PPH FROM THE MINUTES COUNTERS AS INPUT, THE FIRST COUNTER INCREMENTS AS USUAL FROM 0-9 AND CLOCKS THE SECOND COUNTER WHEN RESETTING AT 10 COUNT. THE SECOND COUNTER WILL COUNT FROM 0-2, AND WHEN OUTPUT C OF THE FIRST COUNTER AND OUTPUT B OF THE SECOND COUNTER ARE HIGH, INDICATING HOUR 24, A R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
BUS CONNECTORS
MINUTES AND HOURS SET BUTTONS
THESE BUTTONS ALLOW THE MINUTES AND HOURS COUNTERS TO BE ADVANCED MANUALLY, E.G. WHILE SETTING THE TIME. EACH BUTTON HAS AN RC CIRCUIT WHICH IS USED AS A HARDWARE DEBOUNCE PREVENTING MULTIPLE ADVANCES PER BUTTON PRESS.
