tomstorey/discrete-nor-logic-clock/(commit log)

2017-04-30 Add design files (schematics) for analogue board.
    [analogue-board.sch]
2017-04-30 Fixed notes for prescaler, references to incorrect gate numbers.
    [analogue-board.sch]
2017-04-30 Fix some component designators on the analogue board.
    [analogue-board.sch]
2017-05-06 Modified value of C7 to 1uF from 1nF. Debounce wasnt effective enough with 1nF.
    [analogue-board.sch]
2017-05-13 Update README.md to include link to latest blog post about analog board build. (#5)
2017-05-18 Add design files (schematics) for time module. (#6)
    * Add design files (schematics) for time module.
    [time-module.sch]
2017-05-24 Time module build (#7)
    * Upload files related to time module build.
    Includes:
    * revised analogue schematic to address a design fault
    * C program used to collect offset statistics
    * Rename directory for offset monitor program, its not a "script"
    * Finalise README.md
    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
    [analogue-board.sch]
2017-05-24 Quick fix of some formatting
    [offset.c]
2017-05-29 Fix typo. (#8)
    Time module section had analogue-board in file names instead of time-module.
2017-05-31 Time decoder schematics (#9)
    * Add design files related to time decoder board.
    * Final changes for time decoder design file release
    [time-decoders.sch]
2017-07-05 Adding design files for display board (#11)
    [display-board.sch]
2017-07-05 Fix URL to display board blog post
2017-07-22 Adding calendar module schematics (#12)
    [calendar-module.sch]
2017-07-22 Upload fixed schematics for analogue board (#13)
    Not sure how I missed this, but the schematic was missing sheet 2 which has all of the circuitry for the prescaler on it. Oops.
2017-07-30 Calendar module schematics (#14)
    * Add revised calendar module schematics
    [calendar-module.sch]
2017-07-30 Calendar module schematics (#15)
    * Adding calendar module schematics
    * Upodate readme with link to build log #5
    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
2017-08-16 Add schematics for calendar decoders (#16)
    [calendar-decoders.sch]
2017-09-22 Upload new calendar module schematic.
    Fixes rollover bug which caused calendar module to roll over from 29th day of a month to day 00 of the next month.
    [calendar-module.sch]
2017-11-10 Add display part numbers to display board shematics
    [display-board.sch]
